destone28/DomotiQ/docs/it/07-riconoscimento-e-identita.md

# 7. Riconoscimento e identità

La casa riconosce persone, animali, l'auto e gli oggetti con la **visione artificiale classica**, senza addestrare un modello. Vista dal palo, la base di una statuina misura appena una dozzina di pixel alla risoluzione di analisi, il numero dei personaggi non ha limiti e chi usa la casa ne aggiunge di nuovi in ogni momento. Un rilevatore addestrato avrebbe bisogno di centinaia di immagini etichettate per ogni nuovo personaggio; il metodo classico registra un personaggio in pochi secondi e sta in un solo core della CPU della UNO Q.

Il **machine learning** si usa in due punti. Quando un personaggio viene registrato con una foto, un rilevatore di oggetti **YOLOX-Nano** addestrato sul dataset COCO guarda la foto e propone che tipo di cosa è. In più, se vuoi, puoi addestrare sul PC una piccola rete che conosce le tue statuine e dà alla casa un secondo parere (vedi [La rete che conosce le statuine](#la-rete-che-conosce-le-statuine)); senza, la casa funziona lo stesso.

## Come vede la casa

La visione gira in un processo separato, così un fotogramma lento o un problema della webcam non rallentano mai la webapp o la voce; se si ferma, riparte da sola.

1. **Acquisizione.** La Logitech C270 fornisce fotogrammi MJPEG; la casa li analizza a 640 × 480, da 7 a 10 al secondo sulla scheda. Esposizione, bilanciamento del bianco e guadagno sono bloccati, così i colori non si spostano quando statuine e luci colorate vanno e vengono. I valori si trovano misurando le immagini: la casa lascia regolare la webcam in automatico sulla casa vuota, misura luminosità e colori, poi cerca i valori manuali che danno la stessa immagine, un quarto più scura. Quello che la temperatura di colore della webcam non riesce a correggere (certe luci calde e verdastre) lo corregge un guadagno fisso su ogni canale. Finché la luce non è regolata la casa non riconosce niente, e lo dice in *Diagnostica*. Se poi la luce della sala cambia molto, la webcam si riregola da sola (vedi *La luce della sala*).
2. **La casa vuota.** Alla calibrazione la casa salva la mediana di 20 fotogrammi della casa vuota, arredi compresi. Tutto ciò che è diverso da questa immagine è una statuina, l'auto, un oggetto o una mano.
3. **Differenza nello spazio colore CIELAB, con correzione della luce stanza per stanza.** Le luci delle stanze della casa sono colorate, e la luce della sala cambia. Ogni pixel viene corretto con i guadagni della luce della sua stanza: un guadagno per canale di colore, stimato sul pavimento libero della stanza come il rapporto più frequente rispetto alla casa vuota (così una statuina o l'auto non lo falsano), e, quando sono possibili due valori, quello più vicino al fotogramma precedente. Attraverso una porta il guadagno passa gradualmente da una stanza all'altra. La casa avvisa la visione ogni volta che cambia una luce.
4. **Le ombre non contano.** Un'ombra è più scura ma mantiene il colore del pavimento.
   **Tolleranza per pixel.** Alcuni punti tremolano più di altri: i prati, i bordi dei mobili, gli angoli bui, tutta la casa se la sala è buia e la webcam alza il guadagno. Quando si salva la casa vuota la casa misura il tremolio di ogni pixel sui 20 fotogrammi e lo salva accanto all'immagine (`noise.npy`); senza quel file lo impara dalle prime immagini tranquille dopo l'avvio, poi lo aggiorna piano dove non ci sono presenze, e lo reimpara quando la webcam si riregola. Una macchia conta solo se da qualche parte supera di 5 volte il tremolio dei suoi pixel, e allora conta intera: una statuina su un prato che tremola resta com'è, una macchia fatta solo di tremolio sparisce. Con una buona luce il tremolio resta sotto le soglie fisse e non cambia niente; con un'immagine rumorosa (poca luce, guadagno alto) toglie gran parte delle macchie di tremolio, senza perdere statuine. Costa circa 2,5 ms per immagine.
5. **Maschere.** La visione guarda solo la base della casa: quello che c'è intorno (il tavolo, le mani prima che entrino, i telefoni) non conta. Dentro la base vengono ignorate le zone che non sono pavimento: le applique, la chioma dell'albero, il palo della webcam, la cima delle pareti, il totem del citofono e le schede sulle pareti del locale tecnico (la UNO Q, che sporge di un paio di centimetri dalla parete, e l'hub), i cui LED si accendono e spengono, ciascuna proiettata all'altezza a cui si trova davvero.
6. **Oggetti.** Dopo una pulizia morfologica, ogni macchia connessa diventa un oggetto con la sua area in mm², il suo colore mediano e un istogramma del suo colore, il suo allungamento, e i suoi punti più vicino e più lontano rispetto al punto sotto la webcam.
7. **Dove si trova (parallasse).** La webcam vede dall'alto una statuina in piedi, che quindi appare allungata in direzione opposta al punto sotto l'obiettivo: il suo punto più vicino è la punta dei piedi, quello più lontano la nuca. Abbassando la testa di tutta l'altezza della statuina si ottiene anche la posizione dei piedi, così una statuina viene piazzata correttamente anche quando i piedi sono nascosti dietro una parete. L'auto, che è una scatola più che una statuina, viene piazzata al centro di ciò che si vede. Su scene di prova sintetiche l'errore di posizione resta sotto i 12 mm. Una statuina sul letto, sul divano, su un tavolo o su una panca viene misurata dall'altezza di quel mobile: la casa capisce che ci sta sopra perché i suoi piedi, riportati a quell'altezza, cadono sul mobile. Sul tetto dell'auto invece no: una statuina posata sull'auto si confonde con l'auto. Su quale mobile sta un personaggio lo sa anche la casa, che lo dice (capitolo 8).
8. **Mani.** Una macchia grande almeno come un braccio (2500 mm² dentro la base) che entra dal bordo della base è una mano, tranne al portone del garage, da cui entra l'auto. Fa eccezione anche l'auto parcheggiata contro il muro di fondo del garage, con il tetto sopra il bordo: una "mano" quasi tutta nel garage la guarda la rete, e se vi riconosce l'auto con sicurezza non è una mano. Tutti i pezzi vicini alla mano ne fanno parte, qualunque sia la loro dimensione: il braccio tagliato dalla cima delle pareti e dalle applique, le dita, l'ombra. Una "mano" che resta perfettamente ferma per 8 secondi è invece un oggetto appoggiato sul bordo (un modulo, un cavo) ed entra a far parte della casa vuota. Le statuine che la "mano" copriva restano fuori dalla casa vuota: per esempio, il bagliore di una lampada a parete appena accesa dalla casa può diventare una grande "mano" ferma che contiene le statuine della stanza, e la casa le tiene dove le aveva viste l'ultima volta da sole. Una "mano" quasi tutta in stanze che la casa ha appena acceso, comparsa con la luce, è il bagliore di quella luce e non ferma la casa; le stanze accese restano anche fuori dalla misura con cui la webcam segue la luce della sala.
9. **Inseguimento.** Gli oggetti vengono abbinati alle tracce del fotogramma precedente con il metodo ungherese, su una distanza che combina posizione, colore e dimensione. **Niente si muove da solo, nemmeno sulla mappa:** senza una mano passata da poco una traccia non salta oltre 30 mm, per quanto tempo sia rimasta nascosta, e la posizione di un personaggio fermo non cambia (un'ombra o una luce sulla sua macchia non lo spostano); nei secondi dopo il passaggio di una mano la posizione si aggiorna una volta, dove la mano l'ha lasciato. Un personaggio seguito che per un momento non si vede (una luce, due statuine che si toccano) resta al suo posto fino a due minuti, un personaggio noto fino a un quarto d'ora. Una macchia sconosciuta proprio accanto a un personaggio, del suo colore, è un pezzo di lui (una statuina sdraiata sopra il tronco dell'albero si vede in due).
10. **Portato in mano.** Quando una statuina sparisce sotto una mano, la sua traccia diventa *portata* e mantiene la sua identità; quando la mano se ne va, la statuina che ricompare dove la mano ha lavorato è lo stesso personaggio. Se la mano ha lasciato una sola cosa nuova, quella è il personaggio che teneva, anche sdraiato o sul letto con colori un po' diversi. Se la mano le è solo passata sopra, la statuina ritrova la sua traccia dov'era. Se è stata posata contro un'altra statuina e le due si vedono come una sola macchia, resta nascosta dietro l'altra finché non si separano. Se la mano esce senza posarla, il personaggio lascia la casa 2,5 secondi dopo.
11. **Chi è.** Ogni identità registrata ha una **firma di colore**: un istogramma degli assi di colore a\* e b\* dello spazio CIELAB (dove la luminosità è tenuta a parte, così un'ombra o una luce più fioca cambiano poco) più il colore mediano. Per le statuine bianche, grigie e nere la luminosità pesa di più, perché è l'unica cosa che le distingue. Le identità sono uniche, quindi l'assegnazione delle identità alle tracce si risolve per tutte insieme; un'identità viene data dopo due fotogrammi concordi. Conta anche la dimensione: l'auto non viene mai presa per una statuina né una statuina per l'auto, e una taglia molto diversa da quella imparata conta come meno somigliante. Ogni personaggio impara sulla scheda le sue **pose** (fino a sei: sdraiato, sul letto, sotto un'altra luce), ciascuna con colori, dimensione e forma, e il confronto si fa con la più simile; una posa nuova si aggiunge quando la casa è sicura del personaggio, fermo e visto intero, e subito quando qualcuno dice chi è. Una posa però mostra la stessa statuina da un altro lato, non un altro colore: deve avere i colori del personaggio, più che di chiunque altro. Una posa imparata sulla macchia sbagliata (i LED di una scheda, un altro personaggio vicino) farebbe vedere quel personaggio ovunque: la casa non la impara, e quando carica i personaggi dimentica le pose che non passano questo controllo. Allo stesso modo i colori e la dimensione registrati imparano solo da una macchia che somiglia da vicino al personaggio. Il confronto di una macchia con tutte le pose di tutti i personaggi è un solo calcolo, fatto una volta per fotogramma. Un personaggio molto più simile a uno che a tutti gli altri viene riconosciuto anche con colori meno vicini, ma solo nei primi 10 secondi di una traccia nuova. **I nomi si muovono solo con le mani:** un nome non sta mai in due posti; senza una mano, chi lo tiene se lo tiene finché gli somiglia, e lo perde solo dopo otto fotogrammi in cui non gli somiglia più; e un nome non va mai a una macchia lontana dall'ultimo posto in cui quel personaggio è stato visto, a meno che una mano sia passata di lì o l'abbia preso. Un personaggio che non si vede più resta così dov'era, invece di comparire su qualche riflesso dall'altra parte della casa. **Storico:** la casa ricorda dove ogni personaggio è stato visto l'ultima volta e se una mano è passata di lì; prima di chiedere chi è una cosa nuova, se in quel punto stava un personaggio e nessuna mano lo ha toccato, è ancora lui e riprende il suo nome. Mentre una statuina è seguita con sicurezza, la sua firma si aggiorna lentamente con quello che vede la webcam.
12. **In quale stanza.** La stanza è quella sotto il punto in cui la statuina poggia, con 15 mm di tolleranza sulle porte, così una statuina su una soglia non salta avanti e indietro tra due stanze.

Il risultato è un elenco di tracce, ognuna con una posizione in millimetri, una stanza, un tipo e, quando è nota, un'identità. Il resto della casa (luci, regole, voce, webapp) lavora su questo elenco.

**A riposo.** Analizzare un fotogramma costa circa 180 ms sulla scheda. Quando la casa è ferma (nessuna mano da 25 secondi, nessuna luce della casa che cambia o è animata, niente in sospeso) la casa confronta prima ogni fotogramma, rimpicciolito a 80 × 60 e in grigi, con l'ultimo analizzato: se nessun punto è cambiato di più di 6 livelli di grigio, il fotogramma è uguale e non viene analizzato di nuovo. Il confronto costa una frazione di millisecondo, una mano lo cambia subito, e comunque almeno un fotogramma al secondo viene analizzato per intero. Così il processore resta libero per la voce. In **Diagnostica**, sulla riga della webcam, *a riposo 60% dei fotogrammi* dice quanti fotogrammi la casa ha lasciato stare (durante la festa compare *in pausa per la festa*).

**Priorità.** La visione è il lavoro continuo della scheda: quando il processore non basta per tutti, cede il passo alla voce, che gira nello stesso servizio (il suo processo ha priorità più bassa). Tra i servizi vengono prima la casa, poi la sintesi vocale, per ultimo il modello linguistico.

### Niente si muove da solo

In un plastico ogni cambiamento lo fa una mano: una statuina entra, esce o si sposta solo se qualcuno la prende. La casa usa questa regola per non vedere presenze che non ci sono.

- **Mentre una mano è sopra la casa**, e per 0,6 secondi dopo che è uscita (la sua ombra, la statuina che oscilla), la casa non conta niente di nuovo e non fa sparire nessuno. Una statuina che la mano non tiene resta dov'è: la sua traccia non salta su un'altra macchia.
- **Sulla piantina una statuina si sposta solo se una mano le arriva vicino** (entro 5 cm), anche di pochi millimetri. Senza una mano vicina restano ferme la posizione e il mobile su cui sta: un'ombra, la luce della sala, la sua macchia che a tratti si unisce a qualcosa accanto o salta avanti e indietro di qualche millimetro non la muovono. Mentre la mano lavora, la statuina segue quello che si vede. Quando la mano se ne va (dopo 0,6 secondi), il suo posto diventa la mediana delle prime 10 immagini, circa un secondo: la mediana ignora le immagini storte con l'ombra del braccio. Lo stesso vale per una statuina appena comparsa.
- **Dopo, le cose nuove si cercano solo dove la mano ha lavorato**, per 3 secondi, e nasce solo ciò che la mano ha portato: una cosa che era già diversa dalla casa vuota prima che la mano arrivasse non è nuova. Deve anche essere compatta (al massimo 3,5 volte più lunga che larga) e staccarsi bene dal pavimento, per colore o perché molto più scura o più chiara: le strisce che la luce disegna ai piedi delle pareti o sul bordo del divano, e le chiazze tenui, non sono presenze. Non nasce niente che stia tutto su una parete, né una cosa piccola proprio sul bordo della base.
- **Doppio controllo.** Prima di mostrare una cosa nuova sulla piantina e di chiederne il nome, la casa controlla due volte di esserne sicura. La sicurezza va da 0 a 100% e mette insieme quattro misure: quanto spesso la vede, quanto sta ferma, quanto si stacca dal pavimento, quanto è compatta. Deve superare l'80%, e di nuovo un secondo dopo, senza essere scesa sotto nel frattempo. Per due minuti, nella stanza dove qualcuno ha appena detto che non c'era nessuno (a voce, con **Non c'è niente** o con **Non c'è davvero: togli**) o dove la casa ha appena scartato un riflesso, serve il 92%, controllato a 2,5 secondi di distanza.
- **Una cosa sconosciuta che salta**, anche di pochi millimetri, o che sparisce e ricompare più volte al secondo senza una mano intorno, non è una statuina: è un riflesso o un LED. Esce dalla piantina, lì per 30 secondi non nasce niente e per due minuti in quella stanza vale il doppio controllo più severo. Non vale nelle stanze con le luci animate (la festa).
- **Una differenza senza mano intorno** (un riflesso, la luce della sala, una lampada laterale) non diventa mai una presenza. Le differenze tenui entrano a far parte della casa vuota dopo circa 3 secondi. Ciò che sembra una statuina invece non ci entra mai, così toglierla non lascia un fantasma. Fa eccezione una cosa che spicca chiaramente, compare con una mano intorno e resta per 2 secondi: è una statuina posata mentre la casa aspettava.
- **Il posto lasciato** da una statuina entrata nella casa vuota (per esempio dopo che la casa ha reimparato la casa vuota), quando torna uguale alla casa vuota salvata, non è una presenza: la casa vuota se lo riprende.
- **Quando la casa cambia la luce di una stanza**, per 2,5 secondi il suo riflesso su pareti e pavimento non viene preso per una presenza.
- **Quando cambia la luce della sala** i personaggi restano com'erano un attimo prima, e la casa reimpara la casa vuota con la luce nuova: vedi *La luce della sala*.
- **All'accensione** la casa aspetta che le luci stiano ferme (il microcontrollore le rimanda), poi riconosce i personaggi registrati che sono in casa e l'auto: solo quelli che somigliano da vicino a un personaggio e hanno la forma di una statuina, così l'alone di una lampada o i LED di un modulo non diventano qualcuno. Un personaggio nuovo che era già in casa, o uno sdraiato che somiglia meno, compare appena qualcuno lo sposta.
- **Una presenza seguita meno di 2,5 secondi** è rumore, anche se ha preso un nome: non resta sulla piantina come nascosta.
- **Allarmi solo su presenze certe.** Le regole d'allarme (capitolo 9) contano un personaggio che la casa conosce, o una cosa sconosciuta che sta lì, ferma e ben visibile, da almeno 6 secondi. Una macchia appena nata non fa suonare niente.
- **Il citofono** è escluso dall'analisi, ma il suo contorno conta come bordo della base: un braccio che si allunga verso il soggiorno passando sopra il totem resta una mano.

## Tipi di cose

Ogni identità ha un tipo: **persona**, **cane**, **gatto**, **animale** (qualsiasi altro animale domestico), **auto** o **oggetto**. Le regole possono filtrare per tipo; in una regola *animale* comprende anche cani e gatti. Gli arredi della casa sono fissi e fanno parte della casa vuota; un oggetto nuovo messo nella casa (una sedia, un pallone, una valigia) è un'identità di tipo *oggetto*.

Quando parte una registrazione, la casa propone un tipo:

- **Dalla foto**, se ne è stata scattata una: YOLOX-Nano gira sulla scheda con ONNX Runtime e cerca le 80 classi di COCO; decide il rilevamento sicuro più grande. *person* dà una persona, *dog* un cane, *cat* un gatto; *car*, *truck* e *bus* danno un'auto; *bird*, *horse*, *sheep*, *cow*, *elephant*, *bear*, *zebra*, *giraffe* e *teddy bear* danno un animale; ogni altra classe dà un oggetto, con un nome proposto (per esempio *sedia*, *pallone*, *valigia*).
- **Senza foto**, da dimensione e forma viste dall'alto: una macchia grande è un'auto, una alta e stretta una persona, una piccola, allungata e bassa un animale, tutto il resto un oggetto.

La proposta va sempre confermata da chi registra.

## Registrare un personaggio

Chiunque può registrare personaggi, animali, auto e oggetti, in tre modi.

### Dalla webapp

1. **Personaggi → + Aggiungi**, oppure tocca una statuina sconosciuta nella schermata **Casa** e poi **Registra**.
2. Scrivi il **Nome**. Se vuoi tocca **Scatta o scegli una foto**: basta una foto di fronte; compare nell'elenco e serve a indovinare il tipo. Il telefono la riduce a 1024 pixel prima di inviarla. Tocca **Avanti**.
3. *Appoggialo in un punto libero della casa: lo sto cercando…* La casa cerca qualcosa che vede ma non conosce. Se c'è esattamente un candidato lo prende; se ce n'è più di uno dice *Vedo più cose nuove: tocca quella giusta sulla piantina.*; se non ce n'è nessuno aspetta. Dopo due minuti e mezzo senza risultato ci rinuncia: *Non ho trovato niente di nuovo. Riprova.*
4. *Trovato! Che cos'è?* La casa mostra la sua ipotesi (*Mi sembra: cane*, con un nome proposto per gli oggetti), gli eventuali [avvisi](#avvisi) e i sei tipi. Scegli e tocca **Salva**.
5. *Marco è registrato. D'ora in poi lo riconosco.*

### Con il citofono

1. Premi **Citofono** sul totem. Suona un campanello e la casa chiede "Chi è?" / "Who is it?".
2. **Un nome registrato**: "Ciao Marco, entra pure!". La prima statuina che compare dopo il campanello, nei 3 minuti successivi, sul vialetto o in una stanza della casa (non in garage), riceve quel nome, qualunque cosa la webcam l'abbia presa (una statuina sembra spesso un oggetto o un animale) e senza che la casa chieda chi è. Se il nome appartiene a qualcuno che è già dentro, la casa lo dice ("Ma Marco è già in cucina!"). Se la webcam riconosce chiaramente nella statuina che entra qualcun altro, la casa lo dice ("Ma a me sembri Sofia, non Marco!") e mantiene l'identità che vede.
3. **Un nome nuovo**: "Ho capito Marco, giusto?" Dopo un *sì*: "Piacere, Marco! Entra dalla porta." La prima statuina che compare dopo il campanello, nei 3 minuti successivi, sul vialetto o in una stanza della casa, diventa Marco, una persona, con i colori che la casa vede, senza altri passaggi e senza domande; anche se la casa le aveva dato un nome di cui non era sicura. Una statuina che la casa riconosce con certezza come qualcun altro non conta, e nemmeno una che era già in casa prima del campanello.
4. **Un nome non capito**: un secondo tentativo ("Scusa, non ho capito. Chi sei?"), poi "Non ti conosco, ma entra pure: sei un ospite."

Quando una registrazione avviata a voce è completa, la casa dice "Benvenuto, Marco! Ora ti riconosco."

### Con il tasto Parla

Tieni premuto **Parla** e di' "Aggiungi un personaggio" / "Add a character". La casa chiede "Come si chiama?", poi "In che stanza l'hai messo?", e cerca in quella stanza la statuina che non conosce:

- esattamente una: diventa subito Marco;
- ancora nessuna: "Va bene: mettilo in cucina, lo aspetto." La prima statuina sconosciuta messa in quella stanza entro due minuti e mezzo diventa Marco;
- più di una: "Vedo più di un personaggio nuovo in cucina: scegli Marco dalla webapp." Su tutti i telefoni compare una fascia *Registrazione a voce da completare*; **Scegli** apre la piantina per toccare la statuina giusta.

## Nomi

- **I nomi sono unici** in tutta la casa, senza distinzione tra maiuscole e minuscole, e vengono confrontati anche con le pronunce inglesi. Un nome già in uso viene rifiutato: *Il nome Marco è già usato: aggiungi un cognome o un soprannome.* Se le si chiede a voce di aggiungere un nome che ha già, la casa risponde "Conosco già Marco."
- **Non c'è limite** al numero di personaggi o di oggetti.
- **Dire i nomi a voce.** Per riconoscere un nome a voce, la casa ascolta solo i nomi registrati, con il vocabolario del suo modello di riconoscimento vocale. Un nome fatto di parole che il modello non conosce non si può riconoscere a voce: alla registrazione la casa lo controlla e lo segnala al passo di conferma (*Il riconoscimento vocale italiano non conosce «Zorbax»: a voce potrei non capirlo.*). Il riconoscimento inglese potrebbe non capire un nome italiano: nella scheda del personaggio compila **Pronuncia inglese (facoltativa)** con una grafia che riesca a riconoscere; la casa accetta entrambe le forme.
- Chiunque può rinominare o eliminare un personaggio dalla sua scheda. Un personaggio eliminato lascia subito la presenza che lo portava, le domande aperte che lo proponevano e le etichette di **Addestramento immagini** (non insegna più alla rete un personaggio che non c'è). Resta nel cestino per 24 ore e si può ripristinare da **Altro → Impostazioni → Cestino**; se nel frattempo il suo nome è stato preso, torna con " 2" dopo il nome.

## Avvisi

Alla registrazione la casa controlla cosa potrebbe rendere difficile riconoscere la nuova statuina, e lo dice al passo di conferma:

- *Il colore è molto simile al pavimento / ai prati / alle pareti: potrei non vederlo bene.* La differenza rispetto alla casa vuota è piccola, quindi alcune parti della statuina potrebbero andare perse.
- *Compare e scompare: prova a spostarlo in un punto più libero.* La statuina è stata rilevata in meno della metà dei fotogrammi da quando è comparsa.
- *Sembra uguale a Marco: li distinguerò solo seguendoli.* La sua firma di colore è quasi uguale a quella di un personaggio già registrato.

Nessuno di questi avvisi impedisce la registrazione.

## Personaggi dello stesso colore e dubbi

Due statuine dello stesso colore si distinguono solo seguendole. La continuità del movimento le tiene separate: se solo una delle due viene presa e appoggiata altrove, dev'essere per forza quella, visto che l'altra è rimasta in vista.

Quando il filo si perde (prese tutte e due insieme, le due si toccano, una ricompare lontano, oppure la casa è appena partita) la traccia diventa **incerta**. La casa allora:

- chiede su tutti i telefoni, con una domanda come "In cucina c'è Marco o Leo?", un pulsante per ogni nome e **Tutti e due**, se le statuine si toccano;
- chiede anche ad alta voce, se la sua loquacità lo permette, e subito dopo ascolta la risposta da sola, senza il tasto **Parla**: basta dire il nome, oppure "tutti e due". Vale la prima risposta, a voce o da un telefono;
- se non arriva una risposta entro 60 secondi, tiene la sua ipotesi migliore, segnata come incerta: un **?** sulla piantina, e "Marco è in cucina. Almeno credo." nelle risposte a voce.

**Un nome non sta mai in due posti.** Prima di chiedere, la casa toglie dai candidati chi è già riconosciuto da un'altra parte della casa (tranne se una mano è passata dov'era), chi è stato visto per l'ultima volta lontano da lì senza che una mano ci sia passata, chi ha una taglia troppo diversa da quella che vede (più di quattro volte più grande o più piccola di tutte le sue pose; una statuina non è mai l'auto, l'auto non è mai una statuina) e l'auto fuori dal garage se non ne è certa. Se ne resta uno solo, la casa decide da sola senza chiedere: se Sofia è in cucina, la statuina nuova in soggiorno che somiglia a Sofia e a Leo è Leo. Se non ne resta nessuno (Sofia è in cucina e Leo in camera), quella statuina non è nessuno dei due: la casa la tratta come un nuovo arrivato e chiede chi è. Se il dubbio si scioglie mentre la domanda è aperta (Sofia ricompare in cucina), la domanda viene ritirata dai telefoni e la casa smette di ascoltare.

La stessa regola vale per quello che la casa mostra e dice. Se due presenze arrivano con lo stesso nome (per esempio una ancora in mano e una appena posata), il nome resta a quella in vista. Un nome dato dalla webapp, a voce o dal citofono resta dove è stato dato e sparisce da dove era subito, anche nel mezzo secondo in cui la visione, che gira in un processo separato, non lo sa ancora; poi i nomi tornano a essere quelli della visione, che non li rimette più su una presenza a cui li ha tolti.

**L'auto sta in garage.** L'auto non viene mai proposta per una statuina, né per qualcosa fuori dal garage, a meno che la casa non ne sia certa: grande come un'auto, ferma e ben visibile da 10 secondi.

Sulla stessa statuina richiede al massimo ogni 30 secondi. Una risposta, una registrazione o un ingresso dal citofono **confermano** un'identità: una statuina confermata la mantiene finché la casa riesce a seguirla.

## Un nuovo arrivato

Quando è sicura che c'è qualcosa che non riconosce, la casa lo chiede subito, a voce e su tutti i telefoni insieme. Dice anche che cosa le sembra, così lo si può correggere: "In soggiorno vedo una persona nuova, giusto? Come si chiama?". A una persona chiede il nome, senza proporre quelle registrate. Per un animale, un'auto o un oggetto propone i registrati dello stesso tipo che non sono già in casa ("In giardino vedo un cane nuovo, giusto? È Fido o Birba, o come si chiama?"); per un animale non propone mai una persona. **L'auto sta in garage**: dentro una stanza della casa non chiede mai di un'auto nuova (la chiama "un oggetto"); per qualcosa grande come un'auto fuori dal garage (più spesso una luce, un'ombra o statuine ammucchiate) la casa non chiede niente, a meno di esserne certa: vista ferma e ben visibile per almeno 10 secondi.

**A voce**, senza il tasto Parla, si può rispondere con qualsiasi frase. La casa la capisce e risponde di conseguenza:

| Risposta | La casa |
|---|---|
| un nome nuovo ("Marco", "si chiama Marco", "è mio fratello Andrea") | chiede conferma del nome insieme al tipo ("Una persona di nome Marco, giusto?"), poi "Piacere, Marco!" |
| un nome già registrato ("è Sofia"), anche sentito con una lettera sbagliata ("sera" per Sara) | lo assegna e ne impara i colori, se gli somigliano. Se quel personaggio è in vista in un altro punto della casa, il nuovo arrivato non c'era: "Sofia è già in soggiorno: allora qui ho visto male" |
| "tutti e due", "entrambi", "sia Sofia che Leo", "Sofia e Leo" | due statuine a contatto sono una sola macchia: le segna presenti tutte e due, una nascosta dietro l'altra finché una mano non le separa ("Ah, sono in due: Sofia e Leo!"). Se uno dei due è in vista altrove, qui c'è solo l'altro; se i nomi non sono stati detti e la domanda non ne proponeva, chiede quali sono |
| il tipo giusto ("no, è un cane", "è un gatto e si chiama Micia") | corregge il tipo e chiede il nome, se manca |
| sì o no | dopo un sì chiede il nome, dopo un no chiede che cos'è |
| "non c'è nessuno", "è la mia mano", "è un'ombra" | dimentica quello che aveva visto: la macchia entra nella casa vuota e lì per 30 secondi non nasce niente. Per due minuti in quella stanza vale il doppio controllo più severo |
| "non lo so", "lascia perdere" | lascia la domanda ai telefoni |
| "aspetta" | aspetta e ascolta di nuovo |
| un comando o una domanda ("che ore sono?", "accendi la luce in cucina") | risponde, poi chiede di nuovo il nome |
| una battuta o altro | chiede di nuovo il nome; la seconda volta lascia stare |
| un discorso che non parla del nuovo arrivato ("...e domani andiamo al mare") | come una battuta: il tipo che dice il modello linguistico conta solo se la frase lo nomina |
| silenzio | chiede ancora una volta, poi lascia la domanda ai telefoni. Se due nuovi arrivati di fila non ricevono nessuna risposta, per tre minuti la casa li chiede solo sui telefoni |

Le risposte brevi e comuni le capiscono delle regole, all'istante. Le altre frasi le classifica il modello linguistico locale (capitolo 8). Sulla scheda servono da 3 a 6 secondi, e intanto la casa dice "Fammi pensare..." e i tasti respirano.

- **Dal telefono** si tocca un nome sulla domanda, **Tutti e due** quando i nomi proposti sono più di uno, oppure si sceglie **Uno già noto…** fra tutti i personaggi e gli oggetti che la casa conosce e si tocca **Questo** (il nome si sposta lì da dov'era), oppure si scrive un nome nuovo, si sceglie il tipo e si tocca **Aggiungi**. **Non c'è niente** fa dimenticare alla casa quello che aveva visto.
- Vale la prima risposta, da uno dei due canali; quando arriva, la casa smette di ascoltare.
- Se quello di cui chiede sparisce prima della risposta, la domanda viene ritirata dai telefoni e la casa smette di ascoltare.

Con un nome nuovo la casa crea il personaggio, con il tipo detto (o intuito) e i colori che vede. Con un nome già registrato aggiorna subito i colori di quel personaggio con quelli che vede in quel momento, se gli somigliano, così la volta dopo lo riconosce da sola; una risposta data sulla macchia sbagliata dà il nome ma non cambia l'aspetto del personaggio. Una registrazione in corso dalla webapp ha la precedenza: mentre aspetta il suo personaggio, la casa non fa questa domanda.

## Durante la festa

Mentre la casa fa festa le luci colorate cambiano a ogni battuta, e la webcam vede colori che non sono quelli dei personaggi. Per questo la casa **sospende il riconoscimento** dall'inizio della festa alla fine dello spettacolo di luci: le presenze restano dove erano e con il loro nome, non nasce niente di nuovo, non sparisce niente, la casa non fa domande e non annuncia spostamenti. L'immagine in **Diretta** continua ad aggiornarsi.

A festa finita la casa misura di nuovo la luce di ogni stanza, aspetta che le luci si fermino e riprende quello che vede, come all'avvio. Durante la festa qualcuno potrebbe aver spostato un personaggio, quindi per ognuno vale come se una mano fosse passata dov'era: un personaggio spostato viene ritrovato e il suo nome lo segue anche lontano da dov'era; se la casa non lo riconosce, chiede chi è.

## Correggere la casa dalla webapp

- **Chi è.** Sulla scheda di una presenza (pagina **Casa**), **Chi è?** o **È un altro: cambia** apre l'elenco di tutti i personaggi e gli oggetti che la casa conosce, con un nome nuovo in fondo. Scegliendo un personaggio già noto, il nome passa a quella presenza e lascia quella che lo aveva per errore; la casa impara quell'aspetto come una delle sue pose anche se è diverso dal solito (una luce diversa, un personaggio sdraiato), fino a una distanza di colore di 0,6 invece di 0,45, e lo ricorda dopo un riavvio. Una risposta a voce, che potrebbe riguardare la macchia sbagliata, resta più prudente.
- **Elemento non riconosciuto.** Una statuina che la casa non ha visto posare, o che ha preso per la casa vuota, non viene seguita. **Elemento non riconosciuto**, sulla pagina **Casa** (toccando il punto sulla piantina) o in **Diretta** (toccandolo nell'immagine), dice alla casa dov'è: intorno a quel punto, per circa 3 cm, la casa riprende la casa vuota com'era stata salvata, così quello che c'è torna diverso da lei, ne fa una presenza seguita da subito e chiede chi è. Lì si annullano anche i "non c'è niente" detti poco prima. Se lì non vede niente di diverso dalla casa vuota (l'elemento c'era già quando è stata salvata), basta spostarlo un poco e riprovare.

- **Impara di nuovo l'aspetto.** Nella scheda di un personaggio (**Personaggi**) fa dimenticare alla casa i suoi colori, le pose e la misura. Il nome, le cose da sapere e le regole restano. La prima volta che qualcuno dice chi è (toccando la statuina sulla piantina, rispondendo a una domanda della casa o a voce) la casa impara l'aspetto che vede in quel momento. Serve quando la statuina è un'altra: un personaggio ridipinto o sostituito da un'altra statuina, oppure dopo aver ripristinato un backup fatto con statuine diverse dalle tue. La casa cercherebbe i colori vecchi e non riconoscerebbe la statuina nuova, o la scambierebbe con un altro personaggio.

## La luce della sala

La webcam ha esposizione e colori bloccati sulla luce in cui è stata salvata la casa vuota.

**Il guadagno segue la luce.** Mentre la casa guarda, ogni mezzo secondo confronta la luce delle stanze con la casa vuota in uso, così come è stata fotografata: in ogni stanza conta il pavimento libero, lontano dai personaggi e dalle mani, e fra le stanze conta quella di mezzo, così una stanza con la luce appena accesa non sposta niente. Se la differenza supera il 5%, ritocca il guadagno della webcam di un passo, al massimo l'8% di luce alla volta. Quando la luce della sala cambia di colpo, la casa tiene fermi i personaggi, il guadagno fa passi più lunghi (fino al 25%) e solo dopo la casa impara di nuovo la casa vuota. Così la sera che cala o una lampada accesa si seguono senza buchi di immagini: la regolazione completa della webcam, circa 10 secondi senza immagini, parte da sola solo quando il guadagno è già al limite, e mai al buio se è già stata fatta al buio. *Diagnostica → Luce della webcam* mostra guadagno, ritocchi dell'ultima ora ed eventuale pausa (mani sulla casa, avvio, buio, festa, stanze coperte, luci della casa che cambiano). La webapp non ha un interruttore: si spegne mettendo `"follow_light": false` nella sezione `"camera"` di `var/config/settings.json` e riavviando `domotiq`.

**Come se ne accorge.** La casa si accorge da sola quando cambia la luce della sala:
- la luminosità dell'immagine cambia di oltre il 12% in 2 secondi (una luce accesa o spenta);
- la luminosità resta per 3 secondi oltre il 15% lontana da quella in cui ha imparato la casa vuota l'ultima volta (la sera che arriva piano);
- gran parte della casa cambia senza mani;
- le "mani" coprono quasi metà della casa e insieme la luminosità è cambiata (due braccia vere coprono al massimo un quarto della casa e la luminosità la cambiano appena: sono le pareti illuminate in un altro modo);
- la luce va oltre quello che la correzione delle stanze riesce a seguire;
- la webcam viene regolata di nuovo.

Non conta mentre una luce della casa è appena cambiata (il suo riflesso si misura stanza per stanza), né durante la ricerca dei personaggi all'avvio.

**Cosa fa.**
- **I personaggi restano.** Da quel momento i personaggi restano esattamente com'erano un attimo prima: stessi nomi, stessi posti, niente nasce, niente sparisce e la casa non guarda. Quello che negli ultimi secondi sembrava "preso in mano" resta dov'era: quelle mani erano la luce.
- **La luminosità.** Se l'immagine è sotto il 70% o sopra il 143% della casa vuota, la webcam si regola di nuovo subito.
- **La mappa.** Quando la luminosità sta ferma (entro il 2% per un secondo), la casa reimpara la casa vuota dalla mediana degli ultimi 5 fotogrammi, tranne intorno ai personaggi.
- **Si riparte.** Un secondo dopo ritrova i personaggi al loro posto e ricomincia a guardare: in tutto, pochi secondi.

Spegnere la luce della sala porta l'immagine a circa metà della luminosità, mentre gli scenari della casa (cinema, notte) la abbassano appena: la soglia del 70% distingue bene i due casi.

Una webcam coperta o abbagliata non viene mai imparata come casa vuota, e lo stesso vale per una sala troppo buia (grigio medio dell'immagine sotto 25 su 255). La casa vuota non si può nemmeno salvare al buio: la webapp chiede di accendere la luce. I personaggi restano e la webapp avvisa *La webcam vede quasi buio* (vedi il capitolo 11). Quando la luce torna, la casa riguarda cosa c'è, come dopo una festa: al buio qualcuno può aver spostato una statuina, e la casa la ritrova al suo nuovo posto, con il suo nome. Neanche una webcam urtata: prima di imparare, la casa controlla che pareti e mobili siano al loro posto. Se non ci sono, non impara niente e chiede subito una nuova calibrazione. *Diagnostica* mostra quando la luce sta cambiando e quante volte la casa si è adattata.

**Una sala molto buia.** Anche quando l'immagine è troppo buia per essere imparata, la webcam continua ad alzare il guadagno, e solo verso la luce, finché può, così la casa non resta cieca ad aspettare che la luce torni. Arrivata al guadagno massimo, la webcam usa anche le esposizioni oltre 625, dove moltiplica l'immagine (circa 1,7, 2,3 e 2,9 volte, sempre a 15 fotogrammi al secondo); quando la luce torna le lascia per prime. A quel punto il rumore della webcam è alto, e la casa lo impara di nuovo anche se vede "mani": a quel guadagno quasi sempre sono il rumore stesso. In una sala così buia le statuine scure sul pavimento scuro (una statuina nera, una rossa nell'ombra) possono non distinguersi più: la casa non vede cose che non ci sono, ma può non vedere tutte quelle che ci sono. Con una luce normale tutto torna come prima.

**La casa vuota con più luci.** In **Calibrazione**, con la casa vuota:
1. **Fotografa con tutte le luci della casa.** La casa mostra le sue luci una dopo l'altra (tutte spente, tutte accese, una stanza alla volta, gli scenari) e in ognuna salva una foto della casa vuota, in circa un minuto.
2. **Aggiungi la luce di adesso.** Accendi una alla volta le luci della sala che la casa non comanda (lampade, LED, la luce della finestra) e per ognuna premi il pulsante.

Quando la luce cambia, e a ogni avvio, la casa confronta con la foto più simile, dopo aver misurato la luce di ogni stanza, e non impara niente da quello che vede: una statuina che non sta seguendo non può finire nella casa vuota. Se nessuna foto è abbastanza simile, la reimpara come al solito. Le foto si cancellano quando si rifanno gli angoli. Dopo aver spostato un arredo, premi *Cancella* e rifalle.

**Un avvio con un'altra luce.** Se la casa si accende, o riparte, con una luce diversa da quella in cui è stata salvata la casa vuota, i colori delle statuine non sono quelli registrati. All'avvio la casa prende anche quello che la rete riconosce come un personaggio, e se reimpara la casa vuota senza conoscere ancora nessuna presenza, quello che spicca non entra nella casa vuota e la casa riguarda cosa c'è. Altrimenti le statuine diventerebbero parte della casa vuota: non si vedrebbero più e, spostate, lascerebbero presenze fantasma dove erano state. Resta buona regola salvare di nuovo la casa vuota quando la luce della sala cambia per sempre. Se mentre cerca la casa cambia una luce (per esempio una regola che accende una stanza, o le luci che seguono le persone, se le hai accese), da quel momento prende solo quello che la rete riconosce con sicurezza: il bagliore di una lampada sui muri ha i colori dei personaggi.

Mentre la webcam si regola (circa 10 secondi, senza immagini) le presenze restano dove sono sulla piantina, anche nell'istante tra la fine della regolazione e il primo fotogramma: la casa non saluta e non riaccoglie nessuno. Se una regolazione non riporta l'immagine vicina alla casa vuota (una sala più buia di quanto la webcam riesca a seguire), la successiva aspetta il doppio, fino a un quarto d'ora, così la webcam non si regola di continuo sempre con gli stessi valori.

Con una luce molto diversa le pareti e i bordi dei mobili cambiano aspetto e possono sembrare grandi macchie che entrano dai bordi, cioè mani, che "prenderebbero" e sposterebbero i personaggi e lascerebbero nascere presenze false dove erano stati. Per questo la casa riconosce prima il cambio di luce, e la casa vuota imparata di nuovo non ha più quelle "mani". Valgono anche le regole delle mani: "mani" ferme senza interruzione per 30 secondi non sono mani, e se la luce è vicina a quella della casa vuota entrano nella casa vuota (tranne dove c'è un personaggio).

## La rete che conosce le statuine

Oltre alla differenza dalla casa vuota e alla firma di colore, la casa può avere un secondo parere: una piccola rete neurale che addestri tu sulle tue statuine, viste dalla webcam della casa con luci e ombre diverse (vedi *Addestrarla* più sotto). Guarda il ritaglio di una macchia e dice quale personaggio è, oppure "niente" (il riflesso di una luce su una parete, un'ombra, un modulo). Sulla scheda ogni ritaglio costa circa 10 ms, quindi la casa la usa solo quando serve:
- **Una macchia nuova** che la rete vede come "niente", abbastanza sicura, non diventa una presenza. Non vale mentre si registra un personaggio nuovo: la rete non lo conosce ancora.
  - **"Niente" per prima risposta.** Anche quando la rete non è sicura, una presenza nuova viene annunciata solo quando la sua risposta più recente non è "niente": la presenza aspetta, e la rete la riguarda ogni mezzo secondo. Le statuine vere non hanno quasi mai "niente" come prima risposta, mentre molte presenze false (mobili, griglie e prati sotto un'altra luce) sì. Un personaggio registrato dopo l'addestramento della rete non viene giudicato da lei.
  - **Il tipo.** Una presenza senza nome prende il tipo del personaggio che la rete vede, se ne è sicura almeno all'80%: così una statuina piccola e tonda, che dalla forma sembrerebbe un animale, non viene chiesta come "un animale nuovo".
  - **La soglia.** Ogni rete è sicura a modo suo, quindi la soglia si misura quando la si addestra: sta appena sopra la statuina vera più "niente" dei blocchi lasciati fuori, e arriva nel file `figures.json` della rete. Senza, è il 90%.
- **Un personaggio che non somiglia più ai suoi colori** (un'altra luce) tiene il nome finché la rete, almeno all'80%, lo vede ancora.
- **Un nome sbagliato dei colori.** La rete riguarda ogni 2 secondi anche le presenze che hanno un nome. Se è sicura al 95% due volte di fila che una presenza è un altro personaggio, il nome passa a lei, anche da un'altra presenza che lo teneva, tranne quando quel nome l'ha dato qualcuno o la rete vede quel personaggio anche nell'altra presenza. Un personaggio non impara un aspetto nuovo quando la rete, almeno all'80%, ci vede un altro personaggio.
- **Un nuovo arrivato** prende il nome di un personaggio che nessun altro ha, invece di sentirsi chiedere "chi è?", quando la rete ne è sicura al 95% due volte di fila.
- **Il nome che può avere uno solo.** Una presenza senza nome prende il nome del personaggio che la rete vede almeno al 75%, tre volte di fila, se nessun altro può esserlo: quel personaggio non è altrove in casa, la rete non lo confonde con un altro che manca, e non vede lui in nessun'altra presenza senza nome. Serve dove la rete è meno sicura perché ha visto poco quel posto (per esempio il bagno, che di serie è sfocato anche nelle immagini per la rete).
- **L'auto con l'alone.** In una luce diversa da quella della casa vuota l'auto ha intorno un alone di pavimento e pareti, e la rete ne è meno sicura nella macchia intera che nel suo centro. Per una macchia grande come l'auto la rete guarda anche il centro, all'avvio e nei controlli di ogni presenza. L'auto riconosciuta così non è una mano, nemmeno accanto a una "mano" (un bagliore lì vicino).
- **I doppioni.** Una presenza senza nome che la casa non vede più, o crede in una mano, a meno di 4 cm da un personaggio visto adesso, è lui ritrovato: sparisce subito, senza essere contata né chiesta.
- **Il nome che la rete vede resta.** Quando la rete vede in una presenza il personaggio di cui porta il nome, almeno all'80%, i colori non glielo tolgono per 10 secondi dall'ultima volta che la rete l'ha guardata (una presenza con un nome la guarda ogni qualche secondo). Così un personaggio di cui la casa non conosce ancora bene i colori non torna a prendere il nome di un altro personaggio dai colori simili.
- **Un nome conteso.** Se la rete vede in una presenza un altro personaggio almeno al 90%, due volte di fila, e quel personaggio non è in nessun'altra presenza, oppure la presenza che ne porta il nome è in vista e la rete lì non lo vede, il nome passa a lei. Due personaggi scambiati dai colori si rimettono a posto da soli; la presenza che resta senza nome viene riconosciuta o chiesta.
- **Due risposte di fila** della rete contano se arrivano a meno di 10 secondi l'una dall'altra: a casa ferma la webcam guarda un'immagine al secondo, poche presenze per volta, quindi la rete riguarda una presenza con un nome solo ogni qualche secondo.
- **Con le luci della casa che si muovono** (un allarme, l'onda del climatizzatore, uno scenario) la visione non cambia idea: nessun nome passa da una presenza a un'altra, la rete non viene interrogata (il bagliore ne cambia i colori), i personaggi restano dove erano anche se il bagliore li nasconde, e il bagliore nelle stanze accese non è una mano. Nasce solo quello che una mano ha posato, e prende il nome quando le luci si fermano. Nemmeno la luce della sala si adatta: il lampeggio rosso dell'allarme sembrerebbe una luce nuova della sala, e la casa vuota verrebbe imparata di nuovo con dentro l'allarme.
- **Due personaggi dei colori simili** (due statuine rosse, per esempio) li distingue la rete, quando è sicura al 95% due volte di fila, invece dei colori. Prima di chiedere "chi è?" per un dubbio tra due personaggi uguali, la casa aspetta 2 secondi il parere della rete.

La rete guarda anche le statuine prese "in ritardo" (posate mentre la casa aspettava). È sempre accesa, senza interruttori nelle impostazioni; *Diagnostica* mostra quante volte è servita. Senza il file della rete (`models/vision/figures.onnx` e `figures.json`) la casa funziona senza questo secondo parere.

**Il consenso della rete**, sempre richiesto quando la rete c'è: una presenza nuova viene annunciata solo quando la rete ha visto una statuina, due volte di fila. È il modo per non avere falsi positivi. Il prezzo è che una statuina che la rete non conosce viene annunciata solo mentre la si registra (**Personaggi → + Aggiungi**), e che con poca luce una statuina può tardare un po'.

Una presenza nuova viene annunciata solo dopo che la rete l'ha guardata (al più un fotogramma dopo), e il nome di un personaggio appena preso in mano non va a una macchia che la rete ha appena visto come "niente".

**La raccolta continua** (Impostazioni → Raccolta continua di immagini per la rete, spenta di serie) tiene quello che vede la webcam, con l'esterno sfocato, in `var/collect`: cartelle di 10 minuti nel formato delle registrazioni, un'immagine ogni 5 secondi e due al secondo quando succede qualcosa. Oltre lo spazio scelto (500 MB di serie) si cancellano le cartelle più vecchie. Sono i dati per addestrare di nuovo la rete con le luci e le posizioni vere del posto dove sta la casa; ogni cartella tiene anche la casa vuota di quel momento (`reference.jpg`), utile per controllare che la casa non abbia imparato una statuina come parte della casa vuota.

**Addestramento immagini** (Altro → Addestramento immagini) serve ad addestrare la rete neurale a riconoscere meglio presenze e assenze nella casa: tiene ogni presenza nuova, ogni nome dato e ogni macchia scartata dalla rete, con l'immagine. Dire per ognuna se era giusto, o cosa era davvero, dà esempi verificati da una persona per l'addestramento successivo (`build_crops.py ... --journal <copia di var/journal>`).

**Addestrarla.** La rete si addestra sul PC con i programmi di `scripts/figures/`, partendo dalle registrazioni della casa (**Calibrazione → Registra**). Ogni registrazione salva, per ogni personaggio riconosciuto, il riquadro della sua macchia: quello è il ritaglio con il suo nome.
1. Con tutti i personaggi in casa e riconosciuti, registra qualche minuto spostandoli in stanze e posizioni diverse, con luci diverse (luce della sala, una lampada laterale, gli scenari della casa) e con le ombre di chi sta vicino.
2. Copia sul PC `var/recordings/rec-*` (o `var/collect/rec-*`, la raccolta continua), `var/config/identities.json`, `var/domotiq.db` e `var/calibration`, poi:
   ```
   python scripts/figures/web_fixes.py domotiq.db identities.json correzioni.json [--since "AAAA-MM-GG HH:MM"]
   python scripts/figures/build_crops.py <registrazioni> identities.json crops [--journal journal] [--fixes correzioni.json]
   python scripts/figures/empty_crops.py calibration vuota     # la casa vuota sotto ogni luce: tutto "niente"
   python scripts/figures/preview.py crops anteprima.png      # controlla a occhio le etichette
   python scripts/figures/train.py rete crops vuota --only 2 --niente-weight 2   # prova su un blocco lasciato fuori
   python scripts/figures/train.py rete2 crops vuota --drop rete/suspect.json --niente-weight 2
   ```
   - **Le correzioni della piantina.** `web_fixes.py` ritrova nel database della casa quello che è stato corretto sulla piantina della webapp: una presenza eliminata era "niente" per tutto il tempo in cui è rimasta in quel punto; una presenza a cui è stato dato un nome era quel personaggio, anche mentre la casa la chiamava in un altro modo o non la chiamava. Con `--fixes` queste correzioni contano più delle etichette della casa. `--since` (facoltativo) prende solo le correzioni fatte da quel momento in poi.
   - **La casa vuota.** `empty_crops.py` fa ritagli "niente" dalle foto della casa vuota (quella salvata e quelle con le luci), alle misure delle macchie vere. Insegnano alla rete i mobili della casa anche prima che ci siano errori da correggere: per esempio un divano di un colore simile a quello di una statuina viene scambiato per una statuina molto più di rado.
   - **Il peso di "niente".** Ogni classe si vede circa lo stesso numero di volte; in più un errore su una statuina pesa di più, perché "niente" ha molti più esempi. Con `--niente-weight 2` un errore su "niente" pesa il doppio: calano sia le statuine vere prese per "niente" sia i ritagli "niente" presi per statuine. Con valori più alti, per esempio 4, le presenze false calano ancora, ma una statuina sdraiata sul prato comincia a diventare "niente".
   - **Il secondo addestramento** lascia fuori i ritagli su cui la rete è sicurissima di un'altra etichetta (lì aveva sbagliato la casa). Non vale per un nome dato a mano: lì la rete può essere sicura di un nome sbagliato solo perché la casa, prima della correzione, aveva chiamato così quella statuina.
3. Copia `figures.onnx` e `figures.json` in `models/vision/` sulla scheda e riavvia la casa.

Serve PyTorch sul PC (non sulla scheda). Le classi sono i nomi dei personaggi: dopo un personaggio nuovo, o con statuine diverse, la rete va addestrata di nuovo.

## Privacy

- **Tutto ciò che sta intorno alla casa è sfocato** in ogni immagine che lascia la scheda (il tavolo, le persone intorno, i loro telefoni), appena la casa sa dove si trova la base.
- **Il bagno è sfocato** di serie in ogni immagine che lascia la scheda: la diretta, le istantanee, le catture per i dataset e le sequenze registrate. Si può togliere in **Impostazioni → Bagno sfocato nella diretta**. Con il bagno sfocato anche la raccolta continua e le registrazioni lo sono, e non insegnano alla rete il bagno: lì la rete resta meno sicura. L'area sfocata è l'ingombro del bagno a livello del pavimento e alla cima delle sue pareti, più un margine, così all'interno non si vede niente, a qualsiasi altezza. L'area viene calcolata dalla calibrazione. Prima della calibrazione la casa presume che la webcam sia montata come da progetto e sfoca un'area più ampia attorno a dove dovrebbe trovarsi il bagno: calibra prima di usare la diretta, così la sfocatura si adatta esattamente al bagno.
- Il microfono registra solo mentre la casa ascolta; l'audio resta in memoria e non viene mai salvato.
- Niente lascia la scheda: niente internet, niente cloud. Le posizioni vengono conservate per 24 ore e gli eventi per 7 giorni.

## Dataset e registrazioni

La casa funziona senza addestramento, ma si possono raccogliere immagini anche per altri progetti, per esempio per addestrare un rilevatore. In **Altro → Calibrazione → Dataset**:

- **Cattura** salva il fotogramma attuale; **Raffica (10)** ne salva dieci di fila. Ogni immagine (JPEG 640 × 480, bagno sfocato) riceve etichette automatiche: un riquadro attorno a ogni oggetto trovato dalla visione, con il tipo e il nome della sua traccia; le mani vengono escluse.
- **Scarica il dataset** esporta uno zip con `images/`, `coco/annotations.json` (formato COCO, categorie person, dog, cat, animal, car, object, con il nome del personaggio come attributo) e `yolo/` (`classes.txt` e un file di etichette per immagine nel formato YOLO).
- **Registra una sequenza (60 s)** salva in `var/recordings/rec-DATE-TIME/` ogni fotogramma analizzato come JPEG sfocato, un file `detections.jsonl` con gli oggetti e le tracce di ogni fotogramma, la calibrazione e il riferimento della casa vuota. Sequenze come queste servono a provare l'inseguimento su un PC: `.venv/bin/python scripts/replay.py var/recordings/rec-DATE-TIME` fa girare il codice di visione attuale sui fotogrammi registrati e stampa quello che vede accanto a quello che la casa aveva visto allora (`--video out.mp4` scrive anche i fotogrammi con le tracce disegnate).

Avanti: [voce](08-voce.md).
