destone28/DomotiQ/docs/it/08-voce.md

# 8. Voce

La casa ascolta e parla in **italiano e in inglese**, interamente offline. I visitatori usano i tre tasti del totem: tengono premuto **Parla** per fare una domanda o dare un comando, premono **Citofono** per suonare il campanello e presentarsi, e premono **Lingua** per passare dall'italiano all'inglese e viceversa.

La catena vocale ha quattro parti:

- **Riconoscimento vocale**: Vosk, con i modelli piccoli italiano e inglese, sulla scheda.
- **Comprensione**: un analizzatore a regole, veloce, per le frasi più comuni; le frasi che non capisce passano a un piccolo modello linguistico, Qwen2.5-0.5B-Instruct su llama.cpp, che sceglie soltanto cosa fare.
- **Risposte**: sempre composte dal codice a partire dallo stato reale della casa.
- **Sintesi vocale**: Piper, con una voce naturale per l'italiano e una per l'inglese.

## I tasti

Visti dal visitatore, da sinistra:

| Tasto | Cosa fa | Il suo LED |
|---|---|---|
| **Parla** | Tienilo premuto e parla; rilascialo quando hai finito. Un bip segna l'inizio e la fine. Non c'è fretta: la casa ascolta finché il tasto resta premuto (fino a due minuti). Premere Parla mentre la casa sta parlando la interrompe. Con la [parola di attivazione](#la-parola-di-attivazione) basta dirla. | lampeggia mentre la casa ascolta (con gli altri due) |
| **Citofono** | Suona un campanello e la casa chiede "Chi è?" / "Who is it?". Di' un nome, senza premere niente: dopo la domanda la casa ascolta per 5 secondi. Vedi [il citofono](07-riconoscimento-e-identita.md#con-il-citofono). | lampeggia durante la conversazione |
| **Lingua** | Passa dall'italiano all'inglese e viceversa. Tutte le luci lampeggiano per circa un secondo, **verdi per l'italiano** e **rosse per l'inglese**, e la casa dice "Italiano" o "English". | acceso mentre la casa parla inglese |

Mentre la casa ascolta, **tutti e tre i LED** dei tasti **lampeggiano**; mentre elabora una risposta da dire, **respirano** (si accende il centro, poi tutti, poi di nuovo il centro, poi si spengono); mentre parla restano **accesi fissi**. Se il microfono si apre mentre la casa sta ancora finendo la frase, restano fissi finché non ha finito, poi lampeggiano.

La casa parte in italiano. Puoi cambiare la lingua anche dalla webapp, in **Comandi → Lingua della casa**, oppure a voce ("Parla inglese", "Speak Italian"). È la lingua in cui la casa parla e ascolta; ogni telefono sceglie per conto suo la lingua della webapp.

Durante la conversazione del citofono e la registrazione a voce, la casa ascolta da sola per qualche secondo dopo ognuna delle sue domande ("Chi è?", "Ho capito Marco, giusto?", "In che stanza l'hai messo?"). Anche alle sue domande su chi è chi ("In cucina c'è Marco o Leo?", a cui si può rispondere anche "tutti e due") e sull'ora si risponde senza premere niente.

## La parola di attivazione

In **Impostazioni → Voce** puoi accendere **Attivazione con la parola chiave** e scrivere la *Parola di attivazione*, per esempio *Casa*. Da quel momento dire la parola fa quello che fa il tasto Parla. I tre LED dei tasti cominciano a lampeggiare mentre la parola è ancora detta: il riconoscimento la segnala parola per parola, senza aspettare la fine della frase.

Puoi dire tutto insieme, "Casa, accendi la luce in cucina": dopo la parola la casa continua ad ascoltare fino alla prima pausa, e quello che segue è già la richiesta. **Se dici solo la parola, la casa risponde subito**: appena il riconoscimento libero ha scritto la parola, se per tre decimi di secondo non continui a parlare dice "Dimmi!" (oppure "Sì, dimmi!" o "Eccomi!"), una frase breve già pronta in memoria, poi ascolta la frase senza tasti e risponde. Se il riconoscimento libero non l'ha ancora scritta, la casa aspetta mezzo secondo di silenzio e la trascrizione completa: così le voci vicine che somigliano alla parola non ricevono un "Dimmi!".

Così è chiaro quando parlare: dopo la parola, o dopo il suo "Dimmi!". I LED lampeggiano dalla parola fino alla risposta senza spegnersi. Una sola parola dopo il nome vale come richiesta solo se ha un senso per la casa ("Casa, aiuto!"); un suono qualsiasi no. Il tasto Parla continua a funzionare.

- **Numeri e lettere.** La parola si confronta come la scrive il riconoscimento vocale: i numeri diventano parole, quindi *Robot 3*, *robot3* e *robot tre* sono la stessa parola (in inglese *Robot 3* è *robot three*). Salvando, la webapp mostra come la casa sentirà la parola.
- **Una parola che il riconoscimento vocale non conosce.** La casa la ascolta con parole che conosce e suonano uguali, per esempio *Domotiq* come «domotica». Le lettere che l'italiano non ha si scrivono come suonano: *q* e *k* come *c*, *w* come *v*, *y* come *i*. Se la parola finisce con una consonante, si prova anche con una vocale in fondo. La webapp lo dice: «che il riconoscimento vocale non conosce e sente come «domotica»». Una parola così si conferma sempre con il riconoscimento libero, anche detta da sola, perché la stessa grafia si sente anche nel finale di altre parole ("automatico" per "domotica"). Solo una parola senza nessuna grafia conosciuta va cambiata, e la webapp lo avvisa.
- **Quando ascolta.** Solo quando la casa è libera: non mentre parla (e per poco più di un secondo dopo, perché la sua voce potrebbe dire la parola), non durante una conversazione, una domanda della casa o una domanda ai personaggi, e non in modalità silenziosa. Il microfono resta acceso mentre aspetta la parola, ma l'audio non viene mai salvato né mandato da nessuna parte (la casa tiene in memoria solo gli ultimi due secondi, per non perdere la richiesta detta insieme alla parola); mentre aspetta la parola i LED restano spenti e lampeggiano dal momento in cui la sente.
- **Errori.** Una parola comune come "casa" può comparire in una conversazione tra visitatori ("che bella casa!") e svegliare la casa senza volerlo; una parola rara, o di due parole, sbaglia meno. Per questo la casa fa un controllo: il riconoscimento libero deve ritrovare la parola in quello che è stato detto. Se non la ritrova (per esempio "cosa facciamo?" sentito come "casa"), i LED si spengono e la casa non risponde. In una stanza rumorosa la casa può perdere qualche chiamata: in quel caso c'è sempre il tasto Parla.

## Loquacità

| Livello | Comportamento |
|---|---|
| **Silenziosa** | Non parla mai. Restano il campanello e i suoni brevi; le risposte e tutto il resto che la casa direbbe compaiono solo come sottotitoli nella webapp. |
| **Normale** | Risposte, citofono, allarmi e avvisi, gli eventi importanti delle regole, le domande della casa e una frase per chi entra, esce o cambia stanza (vedi *Il racconto della casa* più sotto). |
| **Chiacchierona** | Come Normale, più i commenti: le proposte ("Siete in tanti in soggiorno: facciamo festa?" con tre o più persone in soggiorno, "Che bella giornata in giardino: accendo il barbecue?" con due o più persone in giardino, al massimo ogni 10 minuti, con la risposta ascoltata senza Parla come per le domande), le frasi che le regole segnano come chiacchierone, come "La temperatura è tornata normale.", e le **domande ai personaggi** (sotto). |

Impostala da **Comandi → Loquacità**, oppure a voce: "Stai zitta" / "Be quiet", "Parla di più" / "Talk more", "Parla normale" / "Normal mode". Ogni frase che la casa dice compare anche come sottotitolo sui telefoni e in **Eventi → Detto dalla casa**.

## Parlare senza premere Parla

Dopo **ogni** sua domanda la casa ascolta da sola per qualche secondo, senza il tasto Parla: il saluto a un telefono nuovo, le domande ai personaggi, "chi è?" per un nuovo arrivato, i dubbi tra due personaggi, le conferme. Se la risposta non è chiara la chiede una seconda volta, e intanto la stessa domanda compare sui telefoni: vale la prima risposta, a voce o dall'app, e appena arriva la casa smette di ascoltare.

Il microfono si apre già mentre la casa finisce la domanda, e quello che sente viene scartato fino a un terzo di secondo dopo la sua ultima parola: così una risposta detta subito ("sì") non va persa mentre il registratore parte. Mentre ascolta, i tre LED dei tasti lampeggiano e sui telefoni compare *La casa ti ascolta…*; mentre elabora la risposta, i LED respirano.

Alla domanda "chi è?" su un nuovo arrivato si può rispondere con qualsiasi frase: la casa la capisce e risponde di conseguenza ([capitolo 7](07-riconoscimento-e-identita.md#un-nuovo-arrivato)). Se mentre ascolta la casa dice qualcos'altro (una regola, un avviso), la risposta viene scartata: potrebbe essere la sua stessa voce. **Parla** e il **citofono** vengono sempre prima: premerli interrompe il saluto o la domanda, e la casa ascolta il tasto.

**Un telefono nuovo.** La prima volta che un telefono apre la webapp, la casa lo saluta: "Ciao! Si è appena collegato un telefono nuovo. Come ti chiami?". Il nome si può dire a voce (la casa chiede conferma: "Ti chiami Luca?") oppure scrivere nella scheda che compare sul telefono; poi la casa invita a entrare con un personaggio, e il telefono propone **Aggiungi un personaggio**. Il nome diventa il soprannome del telefono, quello che compare nel registro delle modifiche.
- Ogni telefono viene salutato una volta sola, anche dopo un riavvio; un telefono che si ricollega dallo stesso indirizzo con un'altra pagina (l'icona sulla schermata Home, una finestra anonima, `casaN.lan`) è lo stesso telefono. La casa dimentica i telefoni (e i nomi) dopo 7 giorni.
- Se si collegano più telefoni insieme, un solo saluto per tutti, e al massimo un saluto a voce (o un ringraziamento) ogni 45 secondi: gli altri telefoni ricevono solo la scheda.
- I nomi **scritti** sui telefoni non vengono mai letti ad alta voce (una casella per il nome permetterebbe di far dire alla casa qualunque cosa): la casa ringrazia senza il nome, il telefono lo mostra. I nomi detti a voce sì, perché vengono dalle parole che il modello vocale conosce.
- **Più tardi** sulla scheda vale per quel telefono: la casa non lo chiede più. Se la scheda si perde (pagina ricaricata, telefono bloccato), torna una volta sola al ricollegamento.
- In modalità **Silenziosa** la casa non parla e non ascolta: resta la scheda sul telefono.
- Puoi spegnerlo da **Impostazioni → Voce → Saluta i telefoni nuovi**.

**Le domande ai personaggi** (solo in modalità **Chiacchierona**). Più o meno ogni due minuti, se ci sono visitatori (qualcosa è successo in casa negli ultimi 5 minuti: una statuina spostata, un tasto, un telefono), c'è un personaggio con un nome e la casa è libera, la casa gli fa una domanda adatta alla stanza in cui si trova, e ascolta la risposta:
- in cucina: "Marco, cosa cuciniamo stasera: pizza o pasta?", "hai fame?";
- in soggiorno: "ti va un po' di musica?" (con un sì parte la festa), "guardiamo un film?" (con un sì, scenario cinema), "preferisci il divano o la poltrona?";
- in camera: "hai dormito bene?", "ti abbasso le luci per riposare?" (con un sì la luce diventa tenue);
- in garage: "dove andiamo con la macchina: al mare o in montagna?";
- in giardino: "accendo il barbecue?" (con un sì parte la ventola), "ti piace il mio giardino?";
- dovunque: "ti piace questa casa?", "sei più da mattina o da sera?", "da dove vieni?", "qual è il tuo colore preferito?" (la luce della stanza prende quel colore);
- agli animali: "vuoi fare una passeggiata?", "hai fame?".

La risposta a una domanda di chiacchiera si confronta con poche parole attese (sì, no, pizza, pasta, i colori...) e non viene mai eseguita come un comando: "mi piace la musica" non fa partire la festa.

Le **proposte** (la musica, il film, la luce tenue, il barbecue e quelle ai gruppi della tabella qui sopra) capiscono invece le risposte come vengono: un sì, anche dentro una frase ("sì dai, mettiamo un po' di musica", "perché no", "magari", "volentieri", "dai"), esegue la proposta; un no ("no grazie", "non adesso", "più tardi") la lascia stare; un altro comando della casa detto al posto della risposta ("no, accendi il barbecue", "metti la luce rossa in soggiorno") esegue quel comando, e una luce senza stanza è quella della stanza del personaggio ("spegni tutte le luci" resta tutta la casa). Un sì non conta se la proposta stessa è rifiutata ("sì, ma niente musica", "dai, non accendere il barbecue"), e chi dice di non sopportarla ("odio la musica", "la musica è troppo alta", "spegni la tv" al film) risponde di no. Una frase che nomina la proposta senza chiederla ("ieri abbiamo fatto festa") non la esegue: la valuta il modello. Le frasi che le regole non capiscono passano al modello linguistico (più sotto), che dice soltanto se la risposta accetta, rifiuta o nessuna delle due; un sì di cui non è sicuro non basta.

Se la risposta non è chiara la casa chiede una volta "Scusa, non ho capito: sì o no?"; se nessuno risponde, per 30 secondi si può ancora dire "sì" con **Parla** (una domanda o un'altra richiesta detta intanto, come "c'è qualcuno in cucina?", ha la sua risposta e non chiude la proposta). La casa non propone quello che adesso non può fare (il barbecue già acceso, una festa appena finita, il cinema già in corso).

Senza risposta: "Niente? Sarà per la prossima volta, Marco." la prima volta, poi silenzio; dopo due domande senza risposta la casa aspetta un nuovo segno di visitatori. Mai in bagno né nel locale tecnico, mai due volte di fila allo stesso personaggio (con uno solo in casa aspetta che ne arrivi un altro), e non durante una festa, una conversazione, una registrazione o una domanda della casa. Le regoli da **Impostazioni → Voce**: *Domande ai personaggi* e *Una domanda ogni (s)* (almeno 45, di solito 120; il momento esatto varia di un quarto in più o in meno).

**Il racconto della casa.** In modalità **Normale** e **Chiacchierona** la casa dice in poche parole cosa succede: "Ecco Viola in soggiorno!", "Viola va in cucina.", "Luca entra in casa.", "Mister Braun esce sul vialetto.", "Ciao Rosaria, a presto!", "L'auto è parcheggiata in garage." (l'arrivo e la partenza dell'auto li dicono le regole: "Bentornato a casa!", "Buon viaggio!"). Aspetta che il movimento si sia fermato per un secondo, così una statuina che attraversa una stanza al volo non viene annunciata; quello che succede insieme lo dice in una volta sola; non parla sopra una domanda né mentre qualcuno parla con lei. Un nuovo arrivato che non conosce non viene annunciato: la casa chiede chi è.

Sul letto o sul divano lo dice ("Ecco Viola sul letto della camera!", "Mister Braun è sul divano del soggiorno."); su un tavolo, una panca, il frigo o gli altri mobili fa scendere subito ("Viola, scendi subito dal tavolo!"), e "Dov'è Viola?" risponde con il mobile. Non saluta chi è ancora in casa (per esempio posato altrove).

Quello che ha detto di un personaggio non lo ripete finché il personaggio resta lì: "Rossana è sul letto della camera" si sente una volta, non a ogni ombra sul bordo del letto né ogni volta che la casa ritrova il suo nome. Lo ridice dopo dieci minuti, oppure quando il personaggio passa davvero in un'altra stanza e poi torna. Una statuina che sparisce e ricompare al bordo dell'inquadratura, o che sale e scende da un mobile nella stessa stanza, non viene salutata né richiamata ogni volta: per dieci minuti la stessa frase su quel personaggio non si ripete. Le frasi più comuni, del racconto e delle domande, hanno diverse varianti, e la casa non dice mai la stessa due volte di fila.

## Cosa puoi dire

Gli esempi qui sotto vengono capiti direttamente dall'analizzatore a regole. Tollera gli errori di riconoscimento nei nomi e non richiede frasi esatte: le parole che contano sono i verbi, le stanze, i colori e i nomi dei personaggi. Un nome registrato detto da solo ("Luna") vale come "dov'è Luna?".

**I nomi prima di tutto.** Quando una frase nomina un personaggio, le richieste sui personaggi vengono prima di quelle generali: "Raccontami cosa piace a Rossellina" è una domanda su Rossellina, non "chi sei?" né "cosa sai fare?". Un nome storpiato dal riconoscimento viene ritrovato se gli somiglia abbastanza ("Rossellino" è Rossellina) o se ne contiene una parola tutta sua ("vista Brown" è Mister Brown, se nessun altro si chiama Brown). Le parole comuni a molti nomi (*Mister*, *Signora*, i colori, le stanze) da sole non bastano. Dopo una domanda su un personaggio, per un minuto e mezzo una domanda senza nome parla di lui: "Raccontami qualcosa di Rossellina", poi "che lavoro fa?", "cosa le piace?".

| Richiesta | Italiano | Inglese |
|---|---|---|
| Dove si trova qualcuno | Dov'è Marco? · Dove si trova Sofia? | Where is Marco? |
| Chi c'è in una stanza | Chi c'è in cucina? · C'è qualcuno in garage? | Who's in the living room? · Is anyone in the garage? |
| Quanti | Quante persone ci sono in casa? · Quanti animali ci sono? | How many people are in the bathroom? · How many pets are there? |
| Temperatura | Che temperatura c'è? · Temperatura in bagno | What is the temperature? |
| Umidità | Quanta umidità c'è in bagno? | How humid is the bathroom? |
| Ora | Che ore sono? | What time is it? |
| Impostare l'ora | Sono le tre e mezza · Sono le quindici e trenta | It's half past three · It's ten to seven pm |
| Accendere le luci | Accendi la luce in cucina · Luce rossa in camera | Turn on the kitchen light · Make the bedroom red |
| La luce preferita | Accendi la luce preferita di Marco · Metti il colore preferito di Giulia in cucina | Turn on Marco's favourite colour |
| Spegnere le luci | Spegni la luce in bagno · Spegni tutto | Turn off the lights in the garage |
| Scenari | Scenario cinema · Scenario relax · Modalità via · Buonanotte · Buongiorno | Cinema mode · Relax scene · Away mode · Good night · Good morning |
| Festa | Fai festa · Balliamo | Let's dance · Party |
| Barbecue | Accendi il barbecue · Spegni il barbecue | Light the barbecue · Turn off the barbecue |
| Climatizzatore e riscaldamento | Accendi il condizionatore · Accendi il clima · Accendi il riscaldamento · Spegni il climatizzatore · Spegni i climatizzatori | Turn on the air conditioning · Turn off the heating |
| L'auto | Dov'è la macchina? | Where is the car? |
| Tutta la casa | Com'è la casa? · Cosa succede? | How is the house? · What's happening? |
| Aiuto | Cosa sai fare? | What can you do? |
| Chi è la casa | Chi sei? | Who are you? |
| Una barzelletta | Raccontami una barzelletta · Fammi ridere | Tell me a joke · Make me laugh |
| Lingua | Parla inglese · Parla italiano | Speak English · Speak Italian |
| Loquacità | Stai zitta · Parla di più · Parla normale | Be quiet · Talk more · Normal mode |
| Volume | Alza il volume · Abbassa la musica | Louder · Turn it down |
| Nuovo personaggio | Aggiungi un personaggio | Add a character |
| Una storia | Raccontami una storia · Una storia su Marco e Giulia · Una storia sulla cucina · Un'altra storia | Tell me a story · A story about Marco and Giulia · A story about the kitchen · Another story |
| La giornata | Cosa ha fatto Marco oggi? · Dov'è stato Luca? · Chi è stato in cucina oggi? · Quante feste abbiamo fatto oggi? | What did Marco do today? · Where has Luca been? · Who has been in the kitchen today? · How many parties today? |
| Un personaggio | Ricorda che Marco fa il medico · Il colore preferito di Marco è il rosso · Il lavoro di Marco è il medico · Cosa sai di Marco? · Raccontami qualcosa di Marco · Cosa piace a Giulia? · Chi è Giulia? | Remember that Marco is a doctor · Marco's favourite colour is red · What do you know about Marco? · Tell me about Marco · What does Giulia like? · Who is Giulia? |
| Due personaggi insieme | Mister Brown e Rossellina stanno insieme · Marco e Giulia sono vicini | Marco and Giulia are together |
| I personaggi | Chi sono i personaggi che conosci? · Chi conosci? | Who do you know? · Which characters do you know? |
| Dire chi è una presenza | L'ospite in soggiorno è Rosaria · Quello in cucina si chiama Marco | The guest in the living room is Rosaria |
| Un'altra stanza, subito dopo | (dopo "chi c'è in cucina?") E in bagno? | (after "who's in the kitchen?") And in the bathroom? |
| Ricordi e domande libere | Ti ricordi la festa di compleanno di Giulia del 1998? · Luca ha pagato le bollette? · Quando scade l'assicurazione dell'auto? | Do you remember Giulia's birthday party in 1998? · Did Luca pay the bills? · When does the car insurance expire? |
| Annullare | Annulla · Lascia stare | Cancel · Never mind |

Colori: rosso/red, verde/green, blu/blue, giallo/yellow, arancione/orange, viola/purple, rosa/pink, bianco/white, azzurro/cyan, caldo/warm. Le stanze si possono chiamare in più modi: *soggiorno*, *salotto* o *sala*; *camera* o *camera da letto*; *locale tecnico* o *tecnico*; *living room*, *lounge*; e così via.

Qualche dettaglio:

- "Buonanotte" / "Good night" passa allo scenario Notte e augura la buonanotte; "Buongiorno" / "Good morning" torna allo scenario Normale e augura il buongiorno.
- Una luce accesa a voce resta accesa per due minuti; "spegni" la tiene al buio per un minuto; poi la stanza torna alla casa.
- Il volume cambia a passi di 15 (su 100).
- A una festa o a una grigliata chiesta troppo presto la casa risponde "Un attimo di pausa, poi rifacciamo festa!" oppure "Il barbecue è già acceso, o si sta raffreddando."
- "L'ospite in soggiorno è Rosaria" dà il nome alla presenza di quella stanza che la casa non conosce (o all'unica che c'è), come la scelta dalla webapp; con un nome nuovo nasce un personaggio nuovo ("Piacere, Giacomo!"). Con più presenze sconosciute nella stanza, chiede di indicarla dalla webapp.
- Subito dopo una domanda su una stanza (chi c'è, quanti, temperatura, umidità, luci), per un minuto e mezzo basta dire un'altra stanza: "E in bagno?" fa la stessa domanda per il bagno.
- A una domanda su un personaggio senza nome, se poco prima non si è parlato di nessuno ("che lavoro fa?"), la casa chiede "Di chi?" e ascolta la risposta senza Parla.
- "Dov'è Tommaso?" con un nome che la casa non conosce risponde "Non conosco nessuno che si chiama Tommaso."
- "Accendi il condizionatore" (o il climatizzatore, il clima) fa quello che fa il termostato quando sente caldo: "Accendo il climatizzatore." e un'onda azzurra in tutte le stanze per due minuti. "Accendi il riscaldamento" fa un'onda arancione, "spegni il climatizzatore" la ferma. Se la casa sente solo il nome ("climatizzatore", "riscaldamento"), perché un "spegni" detto in fretta si perde facilmente, fa da interruttore: spegne l'onda se c'è, anche quella del termostato, e la accende se non c'è. La casa non ha un climatizzatore vero: la ventola del plastico è quella del barbecue.
- Un'informazione su un personaggio detta così com'è, senza "ricorda che", si aggiunge a quelle che la casa sa di lui: "il colore preferito di Mister Blu è l'azzurro" → "Me lo ricorderò: Mister Blu ha come colore preferito l'azzurro." Per il colore prende il posto di quello detto prima, e la luce preferita lo segue. Detta come domanda ("qual è il colore preferito di Mister Blu?") resta una domanda.
- Una o due parole che la casa non capisce ricevono "Non ho capito", non una risposta inventata. Dopo, ogni volta, la casa propone una richiesta diversa da provare, tra quelle che il suo riconoscimento sente meglio: "Prova a chiedermi che ore sono", "Chiedimi dov'è un personaggio, chiamandolo per nome", "Prova a chiedermi una grigliata: facciamo una bella grigliata!". Le propone tutte una volta prima di ripeterne una.
- Alcune frasi che il riconoscimento sente spesso storpiate sono capite come erano state dette: "fai presto" e "let's body" fanno festa.
- "Mister Brown e Rossellina stanno insieme" dice alla casa che la sagoma che vede è fatta dei due personaggi che si toccano: due statuine a contatto sono una sola macchia, e la casa le segna presenti tutte e due, una nascosta dietro l'altra finché una mano non le separa (come la risposta "tutti e due" in [un nuovo arrivato](07-riconoscimento-e-identita.md#un-nuovo-arrivato)). La casa cerca la sagoma che ha già uno dei due nomi, oppure l'unica che non riconosce; se dici la stanza ("...in soggiorno") cerca lì. Se non la trova risponde "Non li vedo: mettili dove la webcam li vede, oppure dimmi in che stanza sono."

Ecco come suonano le risposte: "Marco è in cucina." / "Marco is in the kitchen.", "In cucina ci sono Marco e un cane.", "In casa ci sono 2 persone.", "In soggiorno ci sono 24.3 gradi.", "L'auto è parcheggiata in garage." Quando la casa non è sicura di una statuina aggiunge "Almeno credo." / "I think.".

## Il modello linguistico dei comandi

Una frase che l'analizzatore non capisce ("Quanta gente c'è in cucina?", una richiesta con parole insolite, una frase storpiata dal riconoscimento) passa a **Qwen2.5-0.5B-Instruct** (quantizzato a 4 bit, in formato GGUF), fatto girare da `llama-server` di llama.cpp nel servizio `domotiq-llm`. Mentre lavora, la casa dice "Vediamo…" / "Let me see…".

Il modello riceve istruzioni fisse con le stanze, i comandi della casa e qualche esempio, poi i nomi dei personaggi registrati e la frase. La sua uscita è vincolata mentre viene prodotta, così può scrivere soltanto un comando della casa con i suoi argomenti: *where_is Marco*, *who_in kitchen*, *lights_on bedroom purple*, oppure *other* per tutto il resto. Le istruzioni sono sempre lo stesso testo, che `llama-server` tiene nella sua cache. **La stessa frase non si chiede due volte**: la casa ricorda le ultime 256 risposte del modello (con gli stessi personaggi registrati la risposta sarebbe la stessa) e a una frase già sentita risponde subito, senza "Vediamo…".

Lo stesso modello capisce anche le risposte a "chi è?" che le regole non riconoscono: le classifica come nome, tipo, sì, no, "non c'è nessuno", "non lo so" o altro; una frase con due nomi registrati ("guarda che ci sono sia Viola che Rosaria") vuol dire che ci sono tutti e due. Un nome che propone vale solo se è nella frase; il tipo e i nomi registrati la casa li legge nella frase stessa, quindi il modello non può inventare un personaggio. Queste istruzioni stanno in un secondo slot di `llama-server`, in un terzo quelle che dicono se una risposta accetta una proposta della casa e in un quarto quelle che dicono di cosa parla un'informazione su un personaggio quando nessuna parola chiave lo dice ([Cosa sa dei personaggi](#cosa-sa-dei-personaggi)): `-np 4`, contesto 8192, così nessun tipo di richiesta toglie gli altri dalla cache.

**L'avvio del modello.** Le quattro istruzioni (con i loro esempi) sono lunghe 5.458 token: sui core Cortex-A53 della scheda, con 3 thread a bassa priorità per non rallentare visione e voce, il modello le legge in circa 9 minuti. Per accorciare questa attesa l'installazione applica a llama.cpp dei calcoli scritti apposta per questo processore, che non ha l'istruzione per il prodotto scalare (`scripts/llama/arm-nodot.patch`).

Dopo la prima lettura ogni slot si salva in `/var/lib/domotiq-llm` (`--slot-save-path`, 67 MB in tutto) e agli avvii successivi torna in cache in pochi secondi. Si rilegge solo se cambiano le istruzioni, il modello o il modo in cui il servizio tiene la memoria (per esempio la flash attention, spenta perché su questi core le richieste sono più veloci senza). La lettura parte insieme alla preparazione delle frasi della voce, non dopo. Finché il modello non è pronto le regole funzionano lo stesso, e solo una frase libera che avrebbe bisogno del modello ottiene "non ho capito". Poi una risposta libera richiede circa 2 secondi (da 1,6 a 3,4 secondi).

**Questo modello sceglie cosa fare e non scrive mai quello che dice la casa**: la risposta si compone dallo stato reale della casa, con frasi preparate in italiano e in inglese, quindi non può inventare. Lo stesso vale per la giornata dei personaggi ("Cosa ha fatto Marco oggi?"): la risposta viene da quello che la webcam ha visto davvero, non da un modello.

## Storie, ricordi e domande libere

Le storie, i ricordi ("Ti ricordi la festa di compleanno di Giulia del 1998?") e le risposte sulla vita di casa ("Luca ha pagato le bollette?", "Quando scade l'assicurazione dell'auto?") la casa le genera sulla scheda combinando i pezzi di un database locale, `data/stories.json`, scritto a mano in italiano e in inglese: momenti ("Una sera d'inverno"), attività per ogni stanza, eventi, reazioni, relazioni tra personaggi, scoperte, finali, personalità (lavori, caratteri, passioni e manie, anche per cani e gatti), dettagli della vita di casa (bollette, assicurazioni, faccende, spesa, torte, vacanze) e le tracce di sei tipi di storia (da soli, al lavoro, in coppia, lo scherzo sospetto, la festa a sorpresa, la stanza).

È generazione procedurale: la casa sceglie a caso tra i pezzi che stanno bene insieme e li incastra nella traccia. Poche centinaia di pezzi danno milioni di storie diverse, pronte in un millesimo di secondo, e ogni frase è corretta perché ogni pezzo è scritto per andare d'accordo con qualunque nome: in italiano nessun aggettivo o participio si riferisce a un personaggio, in inglese niente *he* o *she*. Qui la casa inventa, ed è voluto:

- **Pezzi che stanno insieme.** Una scoperta o un finale può essere legato agli eventi che spiega (il pacco senza nome era un regalo per la casa); gli altri pezzi condividono un'etichetta con l'evento (buio, rumore, acqua, festa…). Giorno e notte, estate e inverno non si incontrano mai nella stessa storia; il rumore "dal garage" non lo sente chi è già in garage; i cani abbaiano e i gatti soffiano.
- **Personalità.** La prima volta che serve, un personaggio riceve dal database un lavoro, un carattere, una passione e una mania, diversi da quelli degli altri. Restano gli stessi fino al riavvio della casa: se Marco è un medico, nelle storie successive resta un medico; al riavvio si riparte da capo. Quello che è stato detto alla casa viene prima (nella webapp, in *Chi è*, una cosa per riga, oppure a voce: "Ricorda che Marco fa il medico"). Un'informazione che è un lavoro prende il posto del lavoro, e nelle storie in inglese diventa il lavoro corrispondente del database ("works at the hospital"); le altre entrano nelle storie scritte nella loro lingua ("Marco, che ama il jazz, …"). "Cosa sai di Marco?" risponde dicendo prima dove si trova Marco, poi le informazioni date e la personalità; un'informazione scritta nell'altra lingua si legge con la voce di quella lingua.
- **Sempre una storia nuova.** Per ogni personaggio (o stanza) la casa ricorda le tracce e i pezzi già usati e sceglie tra gli altri finché non li ha usati tutti.
- **La vita della casa.** Alla prima domanda la risposta si inventa dal database, poi resta: la stessa domanda riceve la stessa risposta, anche nell'altra lingua, fino al riavvio. La casa sa rispondere su bollette (tutte o una sola: luce, gas, acqua, internet; chi le ha pagate e quando, oppure quando scadono), assicurazione dell'auto e della casa, compleanni, feste passate (con il nome e l'anno, anche di qualcuno che non conosce, oppure "la festa di Natale del 2005": la stanza, la torta, cosa successe e chi c'era), spesa, faccende (spazzatura, piatti, bucato, aspirapolvere, piante), la pappa degli animali, l'auto, le vacanze e i ricordi di un personaggio. A una domanda che non riguarda la casa risponde che è una casa e del resto del mondo non sa niente.
- **Detta frase per frase.** Mentre una frase suona si sintetizza la successiva, ognuna con la voce della sua lingua, e la stanza di cui parla si accende. **Parla** interrompe la storia; anche un cambio di lingua la ferma.

In modalità **Chiacchierona**, circa due volte su cinque al posto di una domanda della lista la casa dice qualcosa su un personaggio presente: un aneddoto, la sua mania ("Lo sapevate che Marco parla alle piante?"), un ricordo con la data ("Vi ricordate la festa di Marco del 2004?") oppure una domanda sulla vita di casa ("Marco, hai pagato la bolletta della luce?"), seguita dalla risposta a un sì o a un no. Quello che dice il visitatore diventa la vita della casa: dopo un sì, a "Marco ha pagato la bolletta della luce?" la casa risponde di sì. Una domanda detta come risposta continua il discorso: a "Viola, lo sai che manca poco al tuo compleanno?" si può rispondere "Quando?" ("Il compleanno di Viola è il 12 marzo."), alla domanda sulle vacanze "Dove?"; una richiesta o una domanda per la casa ("che ore sono?") ha la sua risposta.

Storie, ricordi e domande libere non usano nessun modello linguistico, quindi funzionano anche con un'installazione `--no-llm`.

## Cosa sa dei personaggi

Una risposta a una domanda della modalità chiacchierona che dice qualcosa di duraturo su un personaggio diventa una sua informazione, come quelle di *Chi è* nella webapp: scritta come si direbbe dopo il nome, nella lingua della conversazione. "Qual è il tuo piatto preferito?" → "la pizza" diventa "adora mangiare la pizza", e la casa risponde "Me lo segno: Rossellina adora mangiare la pizza."; "da dove vieni?" → "viene da Torino". Pizza o pasta, divano o poltrona, mare o montagna, mattina o sera, il colore preferito, la casa e il giardino si segnano senza dire altro.

Le domande sul momento ("hai fame?", "hai dormito bene?") e le proposte ("ti va un po' di musica?") non si segnano, né una risposta poco chiara ("boh"), troppo lunga o sentita male, né una che parla di chi risponde invece di dare un piatto o un posto ("sono vegetariano", "sono italiana", "mi chiamo Giulia"). Una scelta negata vale per l'altra ("non la pizza, la pasta", "il mare no, la montagna"); "non mi piace il rosso" non è un colore preferito.

Ogni domanda tiene una riga sola: una risposta nuova prende il posto della vecchia, anche se era nell'altra lingua; quando le righe sono già otto lascia il posto la risposta più vecchia, mai una riga scritta da qualcuno (a meno che non abbia proprio la forma di una risposta, come "adora mangiare la pizza": "viene da una famiglia di musicisti" resta com'è). Le righe nate da una risposta si leggono nelle due lingue: in inglese "adora mangiare la pizza" diventa "loves eating pizza", nelle storie e nelle risposte.

La casa risponde poi alle domande su quello che sa, anche dette con altre parole: "Cosa mangia Rossellina?", "Qual è il pranzo preferito da Rossellina?", "Cosa posso cucinare a Rossellina?", "What does Rossellina like to eat?" → "So che Rossellina adora mangiare la pizza.". Le parole chiave delle due lingue dicono di cosa parla la domanda (cibo, bevande, colori, musica, sport, lavoro, paure, passatempi, viaggi, divano e poltrona, provenienza, animali, famiglia, età, la casa, mattina e sera) e di cosa parla ogni informazione.

Quando nessuna parola chiave lo dice, la casa cerca le informazioni che hanno una parola in comune con la domanda ("Marco suona la chitarra?" trova "suona la chitarra in una band"); a una domanda su cosa piace a qualcuno risponde con quello che ama. Per un'informazione scritta nella webapp che nessuna parola chiave descrive ("ha un debole per i fumetti") l'argomento lo dice il modello linguistico, che può scrivere soltanto uno di quegli argomenti: lo fa in sottofondo, quando la casa è libera, appena l'informazione viene scritta, così la domanda la trova senza aspettarlo.

La risposta è l'informazione stessa dopo il nome, quindi la casa non inventa e la frase va d'accordo con qualunque nome; un'informazione scritta come frase intera ("il suo piatto preferito è la carbonara") si dice com'è: "Di Rossellina so che il suo piatto preferito è la carbonara." Se di quell'argomento non sa niente lo dice: "Non lo so: Rossellina non me l'ha ancora detto." **La risposta è sempre immediata**, come quella dei comandi delle luci: nessuna domanda su un personaggio aspetta il modello linguistico.

Le domande sulla vita di casa (bollette, spesa, faccende…) restano alle storie; sulle vacanze un'informazione viene prima della risposta inventata. Una richiesta che nomina un personaggio resta una richiesta ("Marco vuole sentire la musica", "musica per Marco", "Marco ha fame, accendi il barbecue"), e "Marco è sul divano?" chiede dov'è adesso, non dove gli piace sedersi.

**Cosa ne fa.** Tre risposte la casa le usa per agire:

- **Il colore preferito** ("Marco, qual è il tuo colore preferito?"): "accendi la luce preferita di Marco" accende la stanza in cui si trova Marco, o quella detta ("...in cucina"), del suo colore. Se Marco non l'ha ancora detto e si trova in casa, la casa glielo chiede subito e la risposta accende la stanza. Le luci che seguono le persone sono spente di serie (vedi il [capitolo 9](09-regole.md#priorità-e-livelli-delle-luci)); se le accendi e in `var/config/settings.json` metti anche `"follow_favourite": true` nella sezione `"lights"`, nello scenario Normale la luce di una stanza prende il colore preferito di chi c'è, di chi è entrato per ultimo tra quelli che l'hanno detto.
- **Ama ballare** ("Marco, ti piace ballare?"): in modalità chiacchierona, quando Marco è in soggiorno con qualcun altro, la casa gli propone una festa ("Marco, tu che ami ballare: facciamo festa?").
- **Ama le grigliate** ("Marco, ti piacciono le grigliate?"): quando Marco è in giardino, la casa gli propone il barbecue ("Marco, tu che adori le grigliate: accendo il barbecue?").

Queste proposte si ascoltano senza Parla come le altre, al massimo una ogni 10 minuti per tipo. **Fai una domanda**, in **Comandi** e sulla scheda di ogni personaggio, fa fare alla casa una di queste domande subito, anche fuori dalla modalità chiacchierona, preferendo quelle a cui il personaggio non ha ancora risposto: a un personaggio scelto a caso tra quelli in casa, o a quello della scheda, anche se non è in casa.

### Quando non sa, chiede e impara

Quando la casa non sa rispondere, non si limita a dire "non lo so".
- **Su un personaggio** ("cosa ama Rossellina?", "che musica ascolta Marco?") dice che non lo sa e chiede: "Tu lo sai? Dimmelo e me lo ricorderò.", poi ascolta senza Parla.
  - La risposta diventa un'informazione del personaggio, scritta in base all'argomento della domanda. Esempi: "le piace il gelato" → "ama il gelato", "il rock" → "ascolta il rock", "Napoli" → "viene da Napoli", "la maestra" → "fa la maestra".
  - La casa ripete cosa ha capito ("Grazie! Me lo segno: Marco ama il gelato.") e la usa per ogni domanda dello stesso argomento, anche detta con altre parole: "cosa ama Marco?" e "cosa piace a Marco?" hanno la stessa risposta.
  - Una risposta che non trova posto fra le informazioni ("Marco ha la patente?" → "sì") resta com'è: la volta dopo "Mi hanno detto di sì."
- **Sul mondo** ("che tempo farà domani?") chiede se preferisci aspettare che ci pensi o dirglielo tu (vedi *Le domande sul mondo* qui sotto); senza il modello delle risposte libere (installazione `--no-llm`) chiede soltanto "Tu lo sai?". Quello che si sente dire lo ricorda, e alla prossima domanda uguale o simile risponde "Mi hanno detto che domani piove.". "Che tempo fa domani?" e "domani piove?" sono la stessa domanda. Quello che riguarda oggi o domani vale per un giorno.
- **Su sé stessa** (le stanze, i mobili, "chi ti ha costruita?", "perché la cucina è gialla?") inventa una spiegazione plausibile e dice che è quello che pensa: "Penso che sia perché chi mi ha costruita voleva così.". Alla stessa domanda dà sempre la stessa risposta.

**Le domande sul mondo.** Una domanda che non riguarda la casa, i suoi personaggi o quello che la casa sa fare ("Come si fa la pizza?", "Perché il cielo è blu?") ha una strada sua. La casa dice subito che deve pensarci e chiede: "Ci devo pensare un attimo. Preferisci aspettare qualche secondo, o me lo dici tu?".
- **"Aspetto"** (anche "sì", "pensaci tu", o il silenzio): "Va bene, ci penso. Un attimo..." e i tasti respirano. Un secondo modello linguistico, Qwen3.5-0.8B (servizio `domotiq-chat`), scrive la risposta da zero in 20-50 secondi, e la casa la dice ("Ecco cosa ne penso: ..."). È un modello piccolo: scrive un italiano sensato, ma sui fatti può sbagliare.
- **"Te lo dico io"**: "Dimmi pure!", e la casa tiene la risposta. Anche la risposta detta subito, senza "te lo dico io", vale.
- **"Lascia stare"** o "non lo so": "D'accordo, lasciamo stare.". Un comando al posto della scelta viene eseguito.

Quello che la casa ha pensato o si è sentita dire resta in `var/config/knowledge.json`: alla stessa domanda, o a una simile, risponde subito. La casa ripete quello che ha imparato ("Grazie! Se mi chiedono come si fa la pizza, risponderò: …"), così una parola sentita male si corregge subito.

**Correggere una risposta sbagliata.**
- **"Sbagliato".** Subito dopo una risposta presa da quello che ha imparato (entro 3 minuti, senza altro in mezzo), "sbagliato", "non è vero", "non è così" o "non è giusto" fanno chiedere "Scusa! Qual è la risposta giusta?". La risposta detta nella stessa frase vale subito: "Non è vero, ci vuole acqua, farina, lievito e sale".
- **"Te lo dico io come si fa la pizza".** Corregge anche più tardi: "Dimmi pure!", e la risposta prende il posto di quella di prima. "Te lo dico io" da solo vale per l'ultima risposta; se non ce n'è, la casa chiede prima la domanda.
- **Chi vince.** Quello che qualcuno insegna vince sempre su quello che la casa ha pensato o immaginato.
- **Dalla webapp.** Tutto si corregge o si cancella anche dalla pagina **Altro → Cosa ha imparato** (capitolo 6), compresa una domanda sentita male.
- **Le domande corte.** Una parola o due ("pizza") non bastano per ripetere una risposta imparata: servono almeno tre parole, o un argomento come il meteo ("domani piove?").

"Non lo so", "boh", il silenzio o un comando al posto della risposta ("accendi la luce") non insegnano niente: la casa risponde "Va bene, lo chiederò a qualcun altro." o esegue il comando. Una risposta sentita male (riconoscimento poco sicuro) non viene tenuta. Quello che la casa impara sul mondo e su sé stessa sta in `var/config/knowledge.json` (le ultime 300 cose); quello sui personaggi tra le loro informazioni, che la webapp mostra e chiunque può correggere.

## Riconoscimento vocale

I modelli Vosk sono `vosk-model-small-it-0.22` e `vosk-model-small-en-us-0.15` (Apache-2.0). La casa li usa in due modi:

- **Un elenco chiuso di frasi** per i nomi, il sì/no e le opzioni di una domanda: il modello accetta solo quelle parole, il che lo rende veloce (meno di mezzo secondo per un nome sulla scheda) e molto difficile da ingannare;
- **Parlato libero** per domande e comandi, trasformato poi in un intento.

Alle sue domande la casa ascolta in tutti e due i modi lo stesso audio, contemporaneamente e su due core diversi: quando la frase finisce, anche il parlato libero è già pronto.

**I nomi dentro una frase libera.** Con il tasto Parla e con la parola di attivazione, mentre il riconoscimento libero trascrive la frase, sul secondo core un altro riconoscimento ascolta lo stesso audio conoscendo soltanto i nomi dei personaggi registrati. Serve quando un nome non è una parola della lingua: "Dov'è l'Honda Civic?" può essere trascritto "dovevo music", mentre il riconoscimento dei soli nomi sente "honda civic".

Se la frase libera non contiene nomi e non è un comando che la casa conosce, o chiede di un nome che la casa non conosce ("dov'è misteri?"), la casa usa il nome sentito così: con "dove" (o "cerca") risponde dov'è, altrimenti lo aggiunge alla frase. Conta solo un nome sentito intero: "honda" da solo, uscito da "andato", non è l'Honda Civic.

Un nome che il modello non conosce entra nell'elenco con una scrittura che il modello conosce, con una doppia scritta singola o divisa in due parole: "Rossellina" si ascolta come "rosellina", e quando la sente la casa ritrova il nome. Alla registrazione la casa avvisa solo se non trova nessuna scrittura così.

Vale la parola dell'elenco quando il parlato libero la conferma o le somiglia, oppure quando il riconoscimento ne è molto sicuro e la risposta è corta (fino a tre parole); altrimenti vale il parlato libero, che capisce anche le risposte con parole diverse da quelle attese ("direi di sì", "mi sa la pasta").

**Le frasi più probabili.** Per una richiesta libera, con il tasto Parla o dopo "Dimmi!", il riconoscimento tiene le cinque frasi più probabili. Se le regole non capiscono la prima, provano le altre: "fece in camera da letto" può essere anche "chi c'è in camera da letto". Le regole accettano anche le frasi come le scrive il riconoscimento ("dove Viola" per "dov'è Viola", "come la casa", "a nulla" per "annulla", "spegne la luce") e quelle con una parola persa nel rumore ("chi in cucina").

Il microfono è acceso solo mentre la casa ascolta, a 16 kHz mono: mentre Parla è premuto, dopo "Chi è?" e per qualche secondo dopo il saluto a un telefono nuovo o una domanda della modalità chiacchierona; con la [parola di attivazione](#la-parola-di-attivazione) accesa, anche mentre la casa è libera e aspetta la parola.

Il registro di sistema della scheda (`journalctl -u domotiq`, solo per chi ha accesso alla scheda) riporta le frasi sentite e quelle dette dalla casa, per controllarne il comportamento; non va ai telefoni. L'audio resta in memoria e non viene mai salvato; di quello che la casa sente senza Parla resta nel registro solo l'esito (sì, no, un'opzione), mai il testo, e il testo riconosciuto non viene mandato ai telefoni.

Fa eccezione una risposta che diventa un'informazione di un personaggio ([Cosa sa dei personaggi](#cosa-sa-dei-personaggi)): resta tra le sue informazioni, che la webapp mostra e chiunque può correggere o cancellare. La risposta di un visitatore a una domanda sulla vita di casa (modalità chiacchierona) resta nella memoria del narratore, per le storie successive, fino al riavvio: non viene scritta su disco.

## Sintesi vocale

**Una frase alla volta.** Sulla scheda, con la casa accesa, una frase di tre secondi e mezzo richiede a Piper circa 4,5 secondi. Per questo una risposta di più frasi si prepara frase per frase: la casa dice la prima mentre prepara la seconda, e la prima frase si sente dopo il tempo che serve per lei sola, non per tutta la risposta.

Piper (`piper1-gpl`, GPL-3.0) gira come programma separato nel servizio `domotiq-tts`, e la casa gli manda le frasi via HTTP sull'interfaccia di loopback. Le voci sono `it_IT-serena-medium` (CC BY 4.0) e `en_US-ljspeech-medium` (pubblico dominio). Numeri e unità di misura vengono pronunciati come si deve ("24.3 °C" diventa "24 virgola 3 gradi" in italiano e "24 point 3 degrees" in inglese).

Le frasi frequenti ("Chi è?", "Vediamo…", "Si balla!"…) vengono preparate all'avvio e tenute in memoria, così partono subito anche quando il processore è impegnato. **Ogni frase sintetizzata si salva anche su disco**, in `var/voice/` (un file WAV per frase, con il nome ricavato dalla voce e dal testo): dopo un riavvio la casa la rilegge in un attimo invece di chiederla di nuovo a Piper, quindi le frasi frequenti sono pronte subito e Piper lavora solo per quelle mai dette. Restano al massimo 3000 frasi; quando sono di più si cancellano quelle non dette da più tempo. Il nome del file dipende anche dalla voce: se sostituisci una voce di Piper, le frasi si sintetizzano di nuovo.

**Le frasi fisse** (alcune centinaia, quelle senza nomi né numeri: il campanello, le domande, le conferme, le risposte preparate) **si possono preparare in anticipo** con `scripts/voice_cache.py`, che le prende dal codice stesso della casa e le scrive in `models/voice-cache/`. La casa legge anche quella cartella, quindi una casa nuova le dice subito dal primo avvio. Lo script si può lanciare sulla scheda, con il suo Piper, oppure su un PC con la stessa versione di Piper e le stesse voci; `release.sh` copia la cartella dal PC alla scheda (vedi il [capitolo 2](02-installazione.md)). Sul PC basta circa un minuto; sulla scheda servono parecchi minuti.

Alcune frasi si passano a Piper già trascritte in fonemi, dove la voce italiana mangerebbe una vocale: altrimenti "Come si chiama?" uscirebbe come "Cme s chiama?", perché la trascrizione automatica legge "si" come una vocale ridotta. La casa non dice mai "Mmm" o "Hmm": le voci li leggono lettera per lettera ("emme emme emme"). Al loro posto la casa dice "Fammi pensare...", "Ah," o "Scusa,", e un "Mmm" in una frase scritta da qualcuno viene tolto prima della sintesi.

Tutti gli altri suoni (campanello, campanello breve, i bip di Parla, allarme, notifica) e la musica della festa sono sintetizzati dal codice stesso della casa: nessun campione registrato. La musica della festa è dance in cassa dritta a 124 BPM, con kick, clap, hi-hat, basso, accordi e una melodia che cambiano a ogni festa, a tempo con lo spettacolo di luci del microcontrollore. Quando la casa parla, la musica si abbassa sotto la voce.

## Impostare l'ora a voce

La UNO Q non ha una batteria per l'orologio. L'ora impostata (da un telefono, a voce o dalle impostazioni) vale finché la scheda resta accesa: se riparte solo l'applicazione, per un aggiornamento o per il watchdog, la casa non la chiede di nuovo. Se due minuti dopo l'avvio l'ora è ancora sconosciuta, la casa lo chiede una volta (a meno che non sia Silenziosa): "Non so che ore sono: che ore sono adesso?", e ascolta subito la risposta, senza il tasto Parla. Fa lo stesso dopo "Che ore sono?" quando non lo sa. In qualsiasi momento puoi anche tenere premuto **Parla** e dire l'ora:

- In italiano: "Sono le quindici e trenta", "Sono le tre e mezza", "Sono le tre e venticinque", "Sono le dieci e un quarto", "Sono le tre e tre quarti", "Sono le otto meno venti", "Sono le sette meno un quarto", "È l'una e dieci". Va bene qualsiasi minuto, in lettere o in cifre; "del pomeriggio" o "di sera" aggiungono dodici ore.
- In inglese: "It's half past three", "It's quarter to five", "It's twenty past six", "It's ten to seven pm", "It's five twenty", "Set the clock at three thirty". "pm", "afternoon" o "evening" aggiungono dodici ore.

La casa conferma: "D'accordo, sono le 15 e 30." / "All right, it's 15:30." Anche il primo telefono che apre la webapp imposta l'orologio, e puoi impostarlo da **Impostazioni → Usa l'ora di questo telefono**.

Avanti: [regole](09-regole.md).
