destone28/DomotiQ/docs/it/index.md

# Guida di DomotiQ

DomotiQ è una casa intelligente in scala 1:20 che funziona interamente offline su una sola **Arduino UNO Q 4GB**. Una webcam su un palo guarda la casa dall'alto e, con la visione artificiale, segue personaggi, animali, un'auto giocattolo e oggetti. Le regole reagiscono a quello che succede con luci, suoni e avvisi, un'interfaccia vocale risponde alle domande in italiano e in inglese, e qualsiasi telefono può aprire la webapp della casa attraverso l'hotspot Wi-Fi della scheda.

Questa guida copre tutto il progetto, da una scheda nuova di fabbrica fino a una casa che funziona. I capitoli seguono l'ordine in cui costruisci la casa.

## Capitoli

1. [Preparare la UNO Q](01-preparare-uno-q.md): prima password, SSH, nomi di rete, aggiornamento del sistema, accesso da un PC.
2. [Installare il software](02-installazione.md): `install.sh`, i servizi, l'hotspot, gli aggiornamenti.
3. [Stampa e montaggio](03-stampa-e-montaggio.md): i file STL numerati e come si montano i pezzi.
4. [Collegamenti](04-collegamenti.md): la catena Qwiic attraverso il Modulino Hub, l'alimentazione, relè e ventola, l'audio, la webcam.
5. [Collaudo e messa in servizio](05-collaudo.md): la verifica di ogni parte, la calibrazione della webcam, il primo personaggio, la voce, i telefoni.
6. [La webapp](06-webapp.md): come aprirla, tutte le schermate, chi può fare cosa, le notifiche e le domande.
7. [Riconoscimento e identità](07-riconoscimento-e-identita.md): come vede la casa, la registrazione dei personaggi, la rete che conosce le statuine, la privacy, i dataset.
8. [Voce](08-voce.md): i tasti, le lingue, la loquacità, frasi di esempio, il modello linguistico.
9. [Regole](09-regole.md): Quando / Se / Allora, tutti gli eventi, le condizioni e le azioni, le regole di partenza, i livelli delle luci, gli scenari.
10. [Attribuzioni](10-attribuzioni.md): le licenze del progetto e di ogni componente di terze parti.
11. [Risoluzione dei problemi](11-risoluzione-problemi.md): sintomo, causa e soluzione.

Per l'uso di tutti i giorni c'è una [guida rapida](guida-rapida.md) di una sola pagina: accensione, preparazione, tasti, telefoni e cosa fare quando qualcosa non va.

## In breve

| | |
|---|---|
| Nome host | `casa1` |
| Utente e password | `arduino`, `domotiq2026` (scelta nel [capitolo 1](01-preparare-uno-q.md)) |
| Hotspot Wi-Fi | `DomotiQ-Casa1` (canale 1), password `domotica2026` |
| Webapp | `http://10.42.1.1/` |
| Altri nomi | `casa1.lan`, `casa1.local` |
| Cartella del progetto | `/home/arduino/domotiq` |

## Licenza e attribuzione

Il codice sorgente è distribuito sotto licenza MIT; documentazione, immagini, file di stampa 3D e i dati in `data/` sono distribuiti sotto CC BY 4.0. I dettagli, insieme alle licenze dei componenti che la casa usa, sono in [Attribuzioni](10-attribuzioni.md).

**Emilio Destratis** · [destratis.it](https://destratis.it) · Progetto Arduino
