destone28/DomotiQ/docs/images/screens/en/rule-edit.png

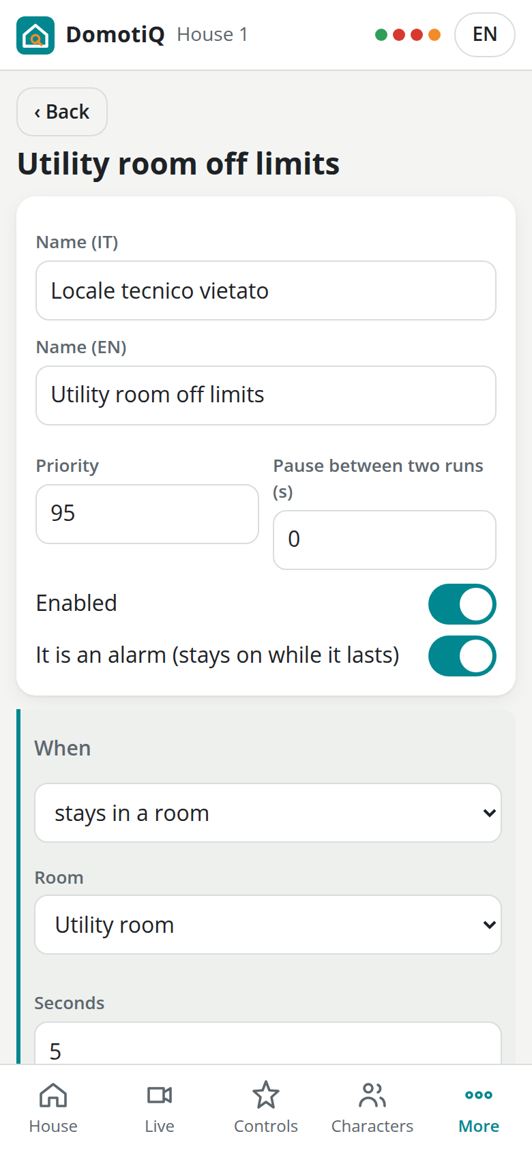
docs/images/screens/en/rule-edit.png
