destone28/DomotiQ/docs/images/screens/it/rule-edit.png

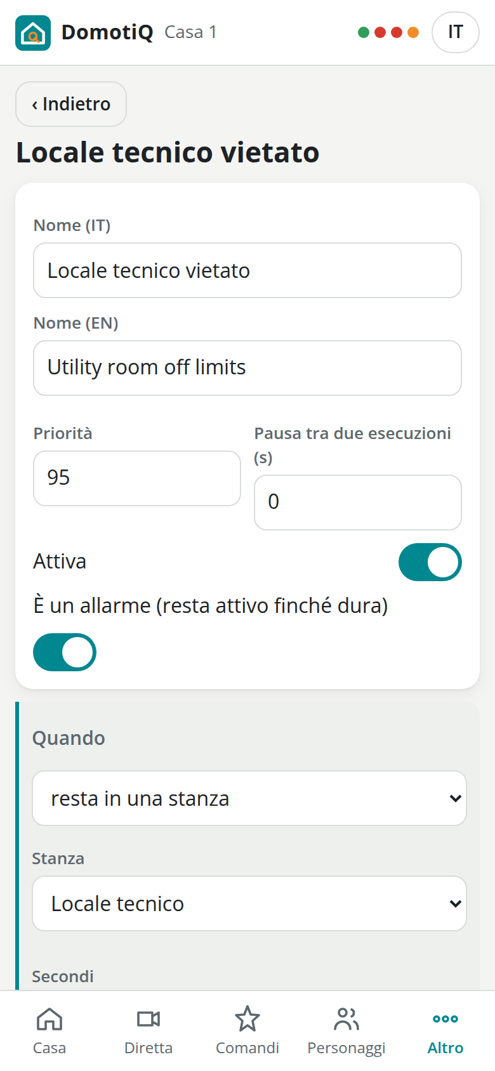
docs/images/screens/it/rule-edit.png
