destone28/DomotiQ/hardware/stl/07_Chiave_03.stl

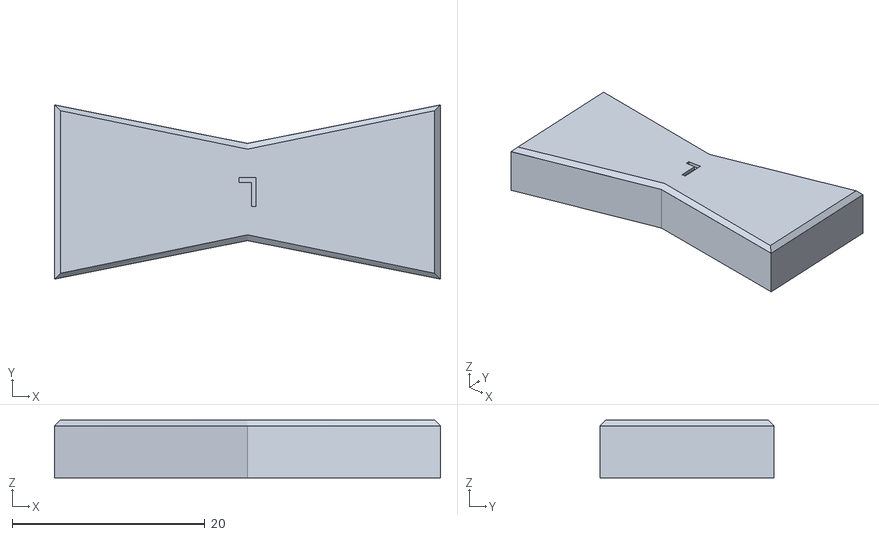
[picture p22: CAD file, 2026-10-05]
hardware/stl/07_Chiave_03.stl
40.1 x 18.1 x 6.00
