destone28/DomotiQ/hardware/stl/44_Fioriera_Cassa_Sx.stl

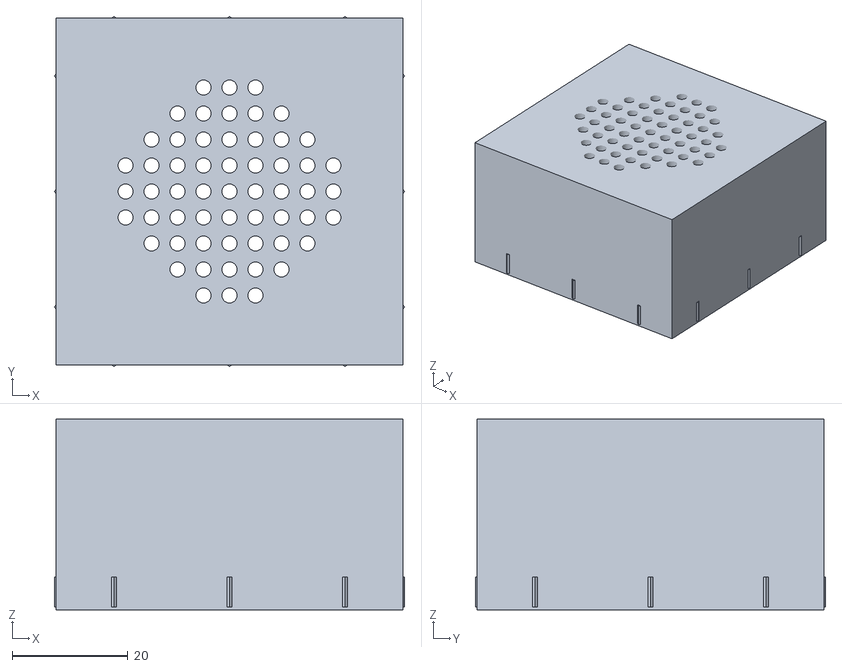
[picture p23: CAD file, 2026-10-05]
hardware/stl/44_Fioriera_Cassa_Sx.stl
60.6 x 60.6 x 33.0
