destone28/DomotiQ/hardware/stl/20_Palo_3.stl

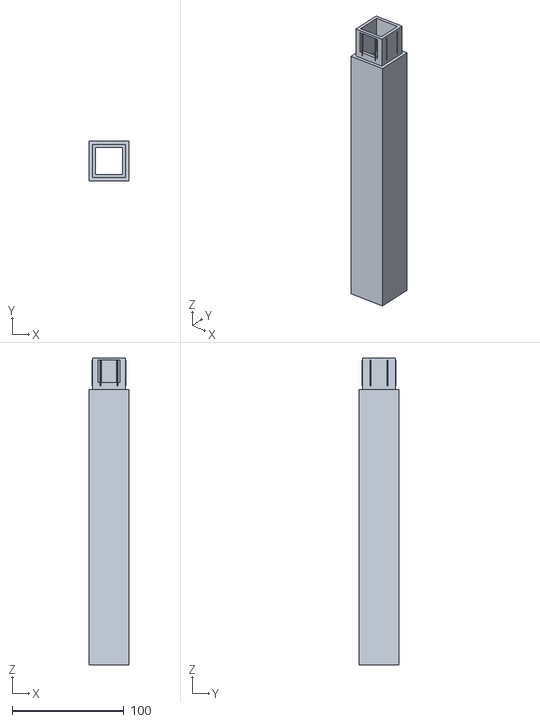
[picture p24: CAD file, 2026-10-05]
hardware/stl/20_Palo_3.stl
36.0 x 36.0 x 274.3
