destone28/DomotiQ/hardware/stl/26_Applique_Pixels_Cucina.stl

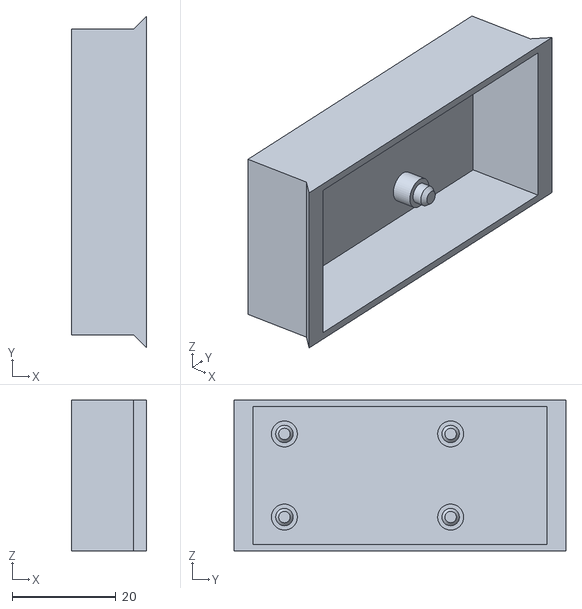
[picture p25: CAD file, 2026-10-05]
hardware/stl/26_Applique_Pixels_Cucina.stl
14.5 x 63.9 x 29.0
