destone28/DomotiQ/hardware/stl/50_Arredo_Cucina_Frigo.stl

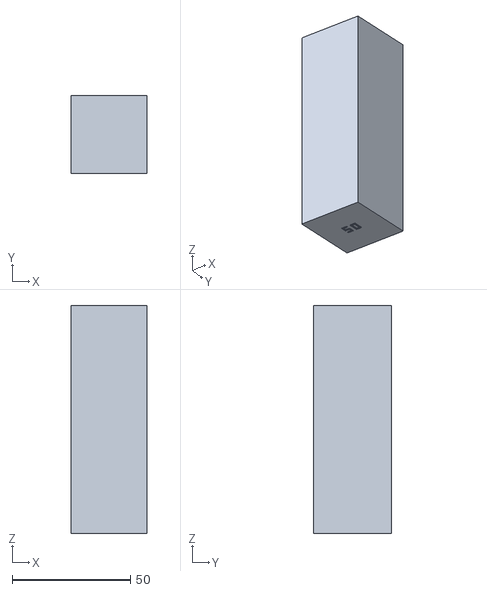
[picture p26: CAD file, 2026-10-05]
hardware/stl/50_Arredo_Cucina_Frigo.stl
32.0 x 33.0 x 96.5
