destone28/DomotiQ/hardware/stl/13_Parete_Bagno_Tecnico.stl

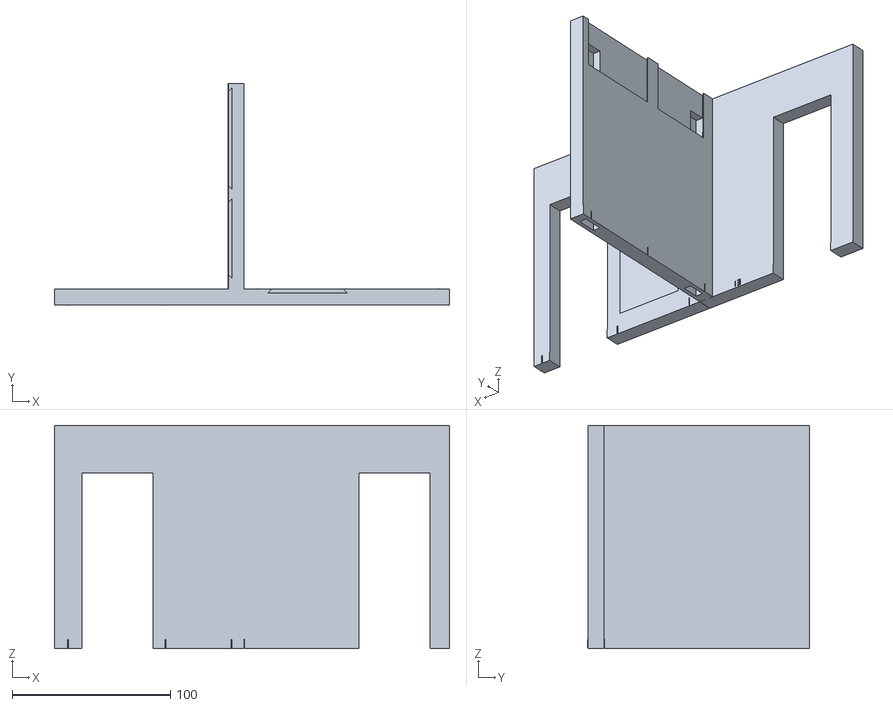
[picture p27: CAD file, 2026-10-05]
hardware/stl/13_Parete_Bagno_Tecnico.stl
249.5 x 140.1 x 141.0
