destone28/DomotiQ/hardware/stl/02_Pedana_A2.stl

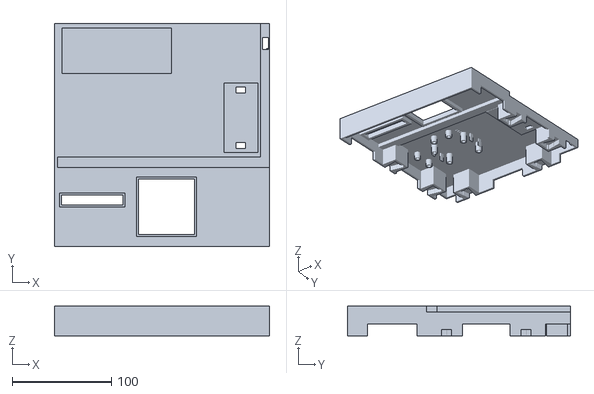
[picture p28: CAD file, 2026-10-05]
hardware/stl/02_Pedana_A2.stl
217.0 x 225.0 x 30.0
