destone28/DomotiQ/hardware/stl/41_Panca_Giardino_1.stl

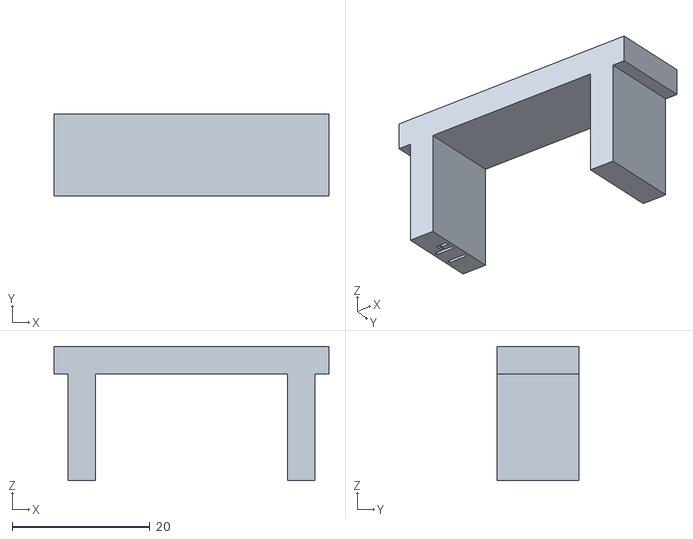
[picture p29: CAD file, 2026-10-05]
hardware/stl/41_Panca_Giardino_1.stl
40.0 x 12.0 x 19.5
