destone28/DomotiQ/hardware/stl/12_Parete_Camera.stl

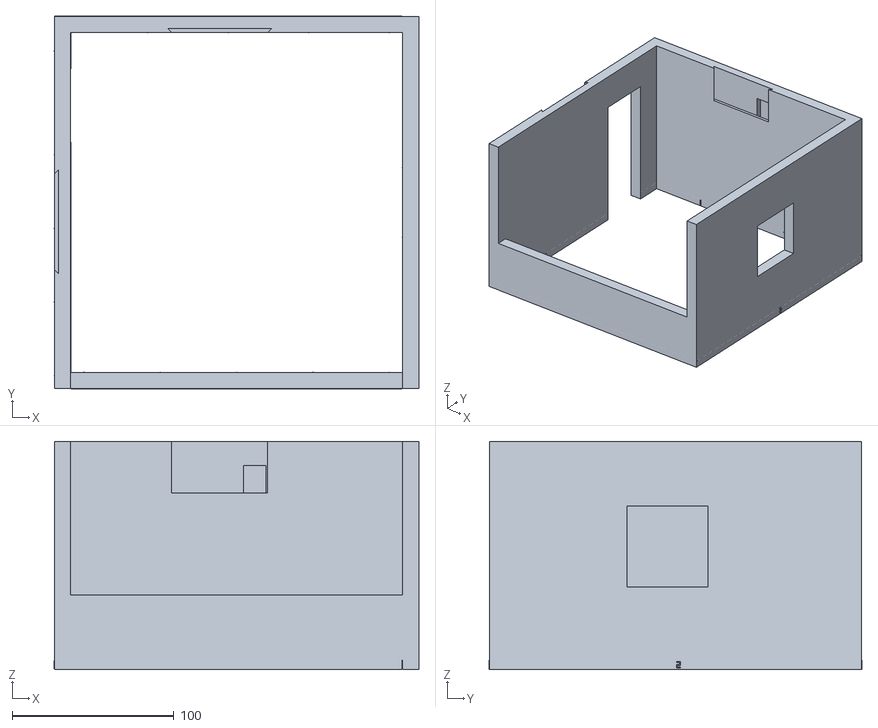
[picture p30: CAD file, 2026-10-05]
hardware/stl/12_Parete_Camera.stl
225.4 x 230.2 x 141.0
