destone28/DomotiQ/hardware/stl/39_Albero_Chioma.stl

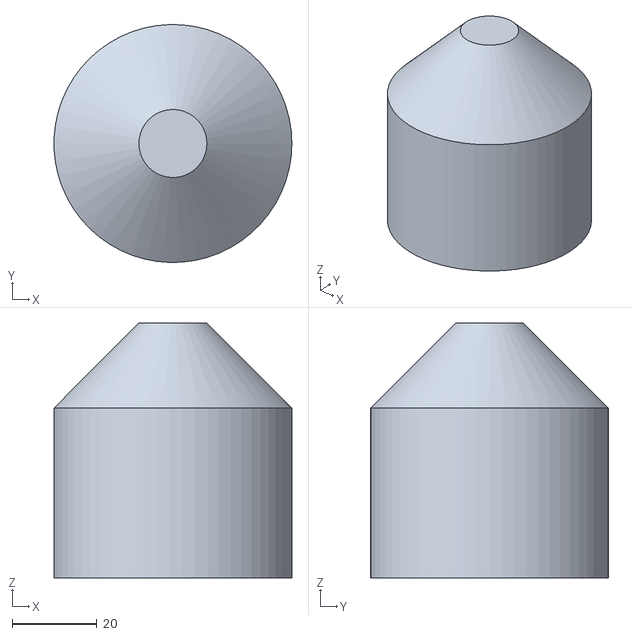
[picture p31: CAD file, 2026-10-05]
hardware/stl/39_Albero_Chioma.stl
56.0 x 56.0 x 60.0
