destone28/DomotiQ/hardware/stl/18_Palo_1.stl

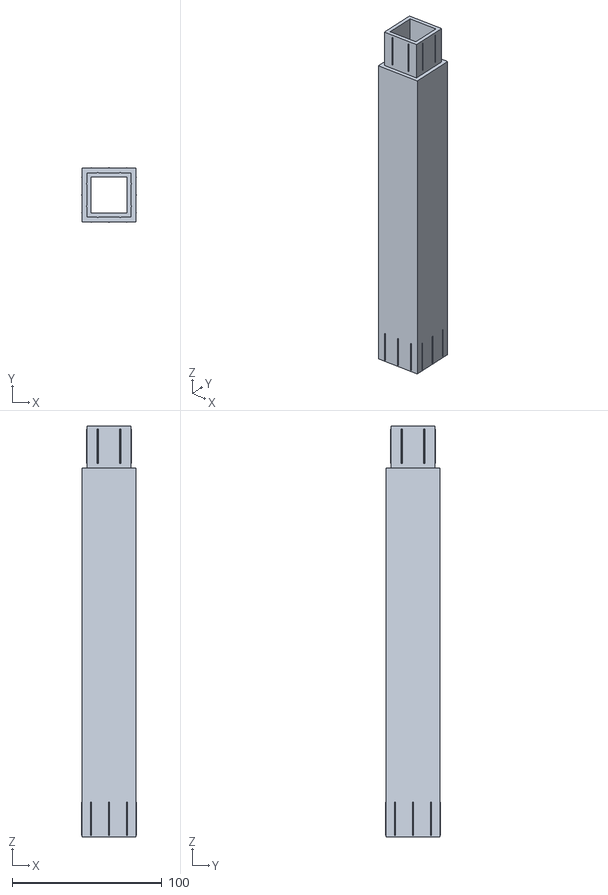
[picture p32: CAD file, 2026-10-05]
hardware/stl/18_Palo_1.stl
36.6 x 36.6 x 274.3
