destone28/DomotiQ/hardware/stl/54_Arredo_Mobile_TV.stl

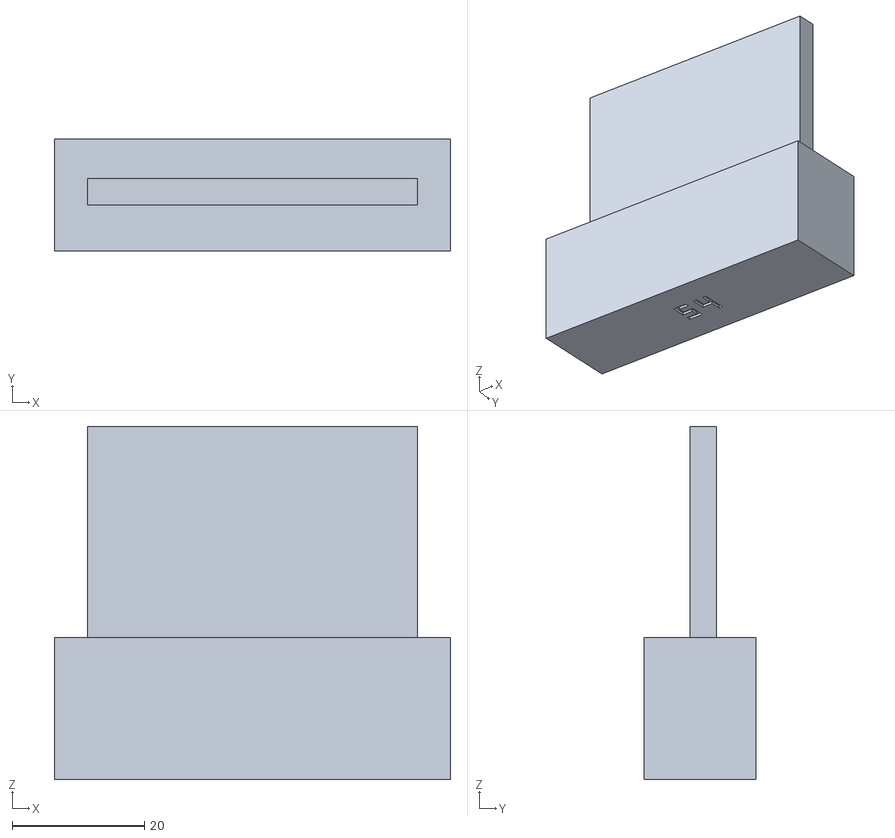
[picture p33: CAD file, 2026-10-05]
hardware/stl/54_Arredo_Mobile_TV.stl
60.0 x 17.0 x 53.5
