destone28/DomotiQ/hardware/stl/17_Parete_Fac_Soggiorno.stl

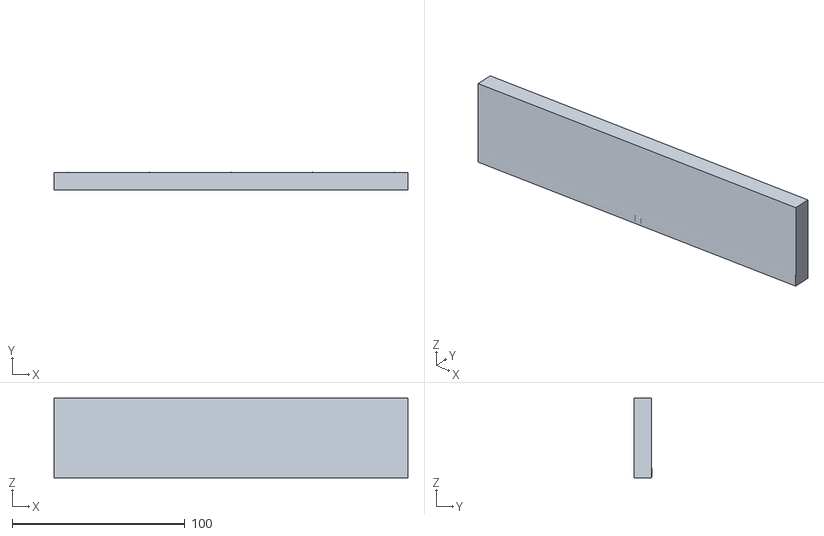
[picture p34: CAD file, 2026-10-05]
hardware/stl/17_Parete_Fac_Soggiorno.stl
204.8 x 10.4 x 46.0
