destone28/DomotiQ/hardware/stl/37_Griglia_Coperchio.stl

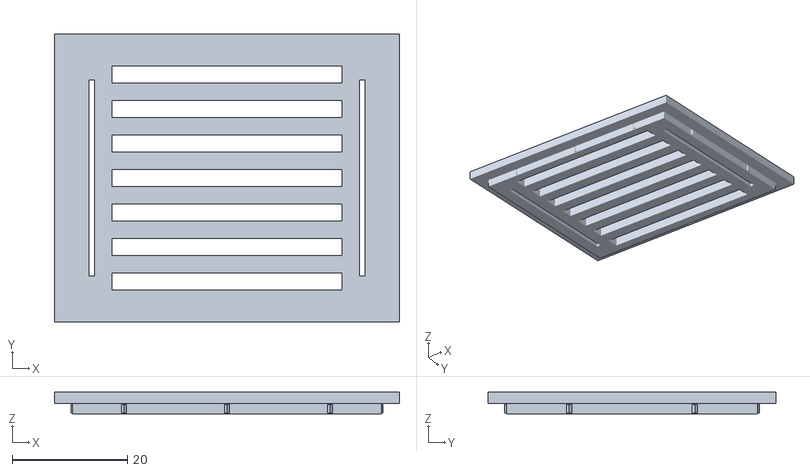
[picture p35: CAD file, 2026-10-05]
hardware/stl/37_Griglia_Coperchio.stl
60.0 x 50.0 x 3.80
