destone28/DomotiQ/hardware/stl/22_Fermo_Camera.stl

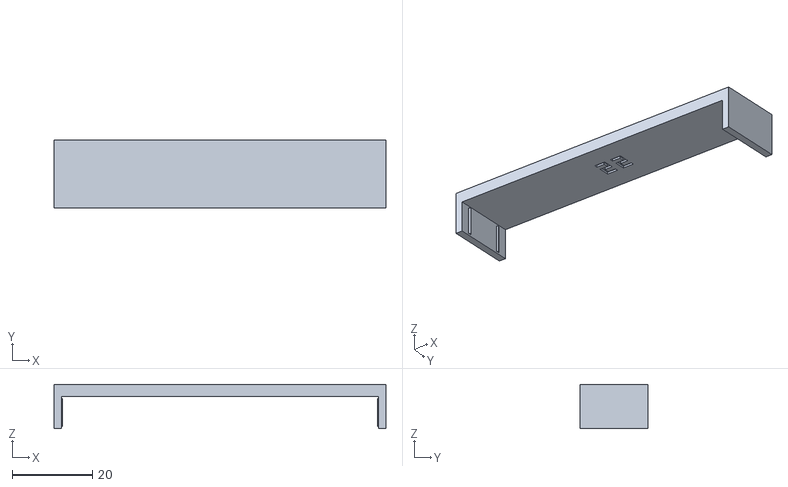
[picture p36: CAD file, 2026-10-05]
hardware/stl/22_Fermo_Camera.stl
82.6 x 16.8 x 11.0
