destone28/DomotiQ/hardware/stl/28_Totem_Scocca.stl

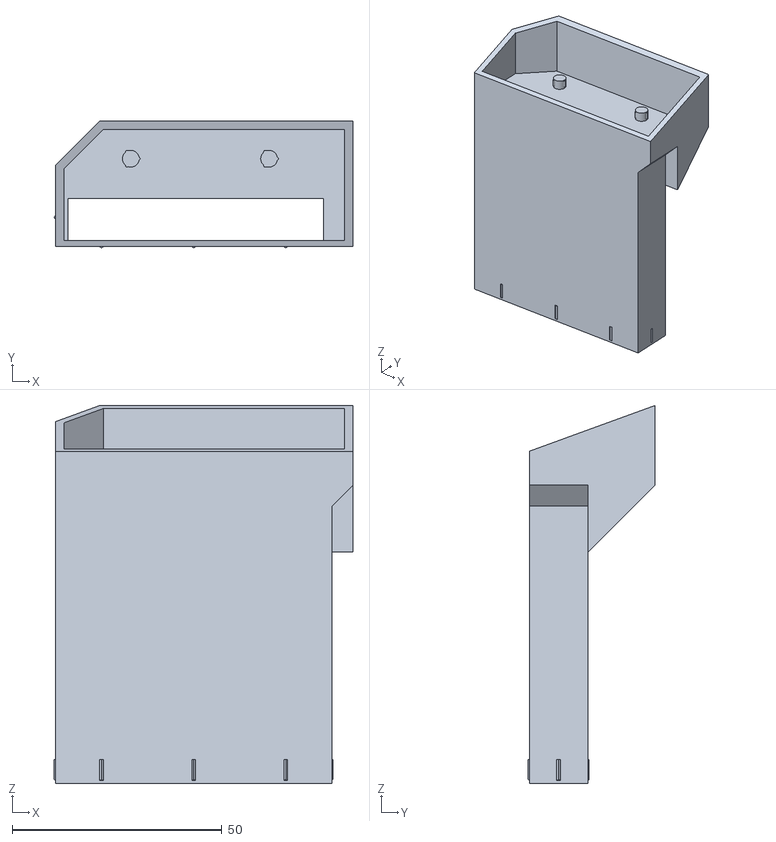
[picture p37: CAD file, 2026-10-05]
hardware/stl/28_Totem_Scocca.stl
71.3 x 30.3 x 90.2
