destone28/DomotiQ/hardware/stl/48_Prato_Vialetto_Dx.stl

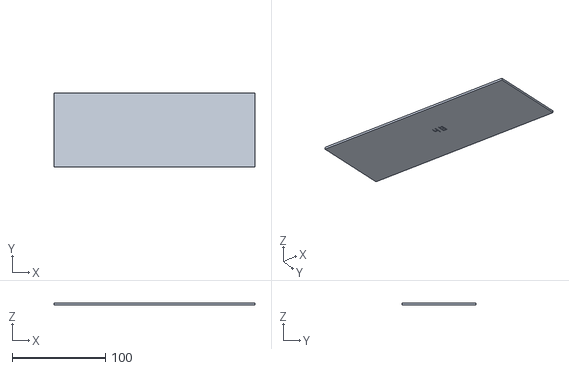
[picture p38: CAD file, 2026-10-05]
hardware/stl/48_Prato_Vialetto_Dx.stl
215.4 x 79.4 x 2.00
