destone28/DomotiQ/hardware/stl/31_Totem_Tasto_C.stl

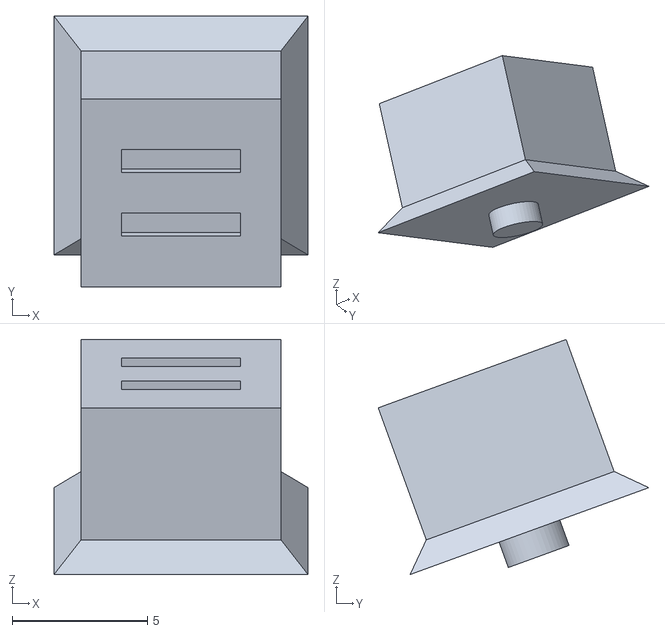
[picture p39: CAD file, 2026-10-05]
hardware/stl/31_Totem_Tasto_C.stl
9.40 x 10.0 x 8.70
