destone28/DomotiQ/hardware/stl/23_Placca_UNO_Q.stl

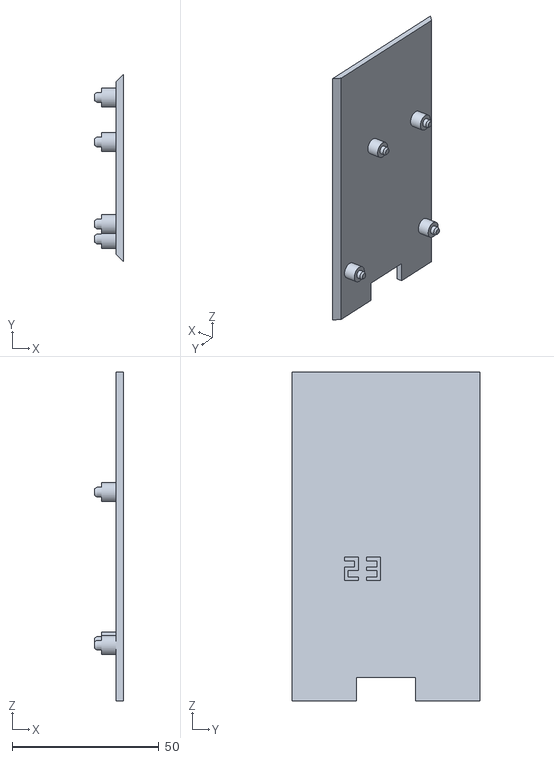
[picture p40: CAD file, 2026-10-05]
hardware/stl/23_Placca_UNO_Q.stl
9.90 x 64.0 x 112.0
