destone28/DomotiQ/hardware/stl/09_Staffa_Scheda_Audio_1.stl

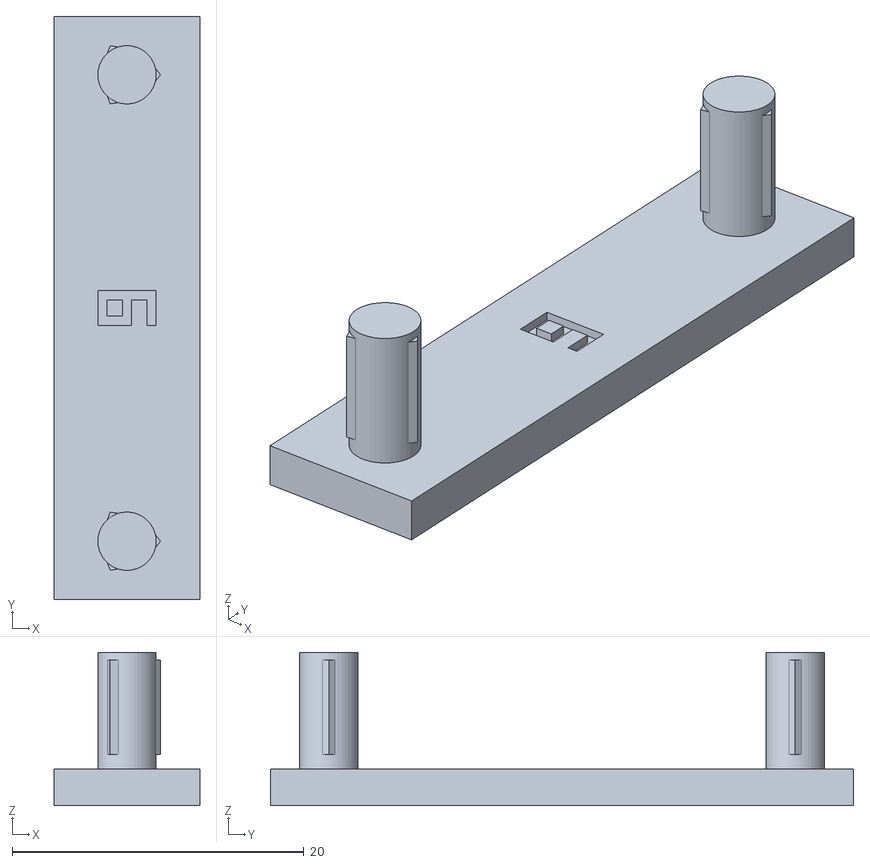
[picture p41: CAD file, 2026-10-05]
hardware/stl/09_Staffa_Scheda_Audio_1.stl
10.0 x 40.0 x 10.5
