destone28/DomotiQ/hardware/stl/46_Prato_Vialetto_Sx.stl

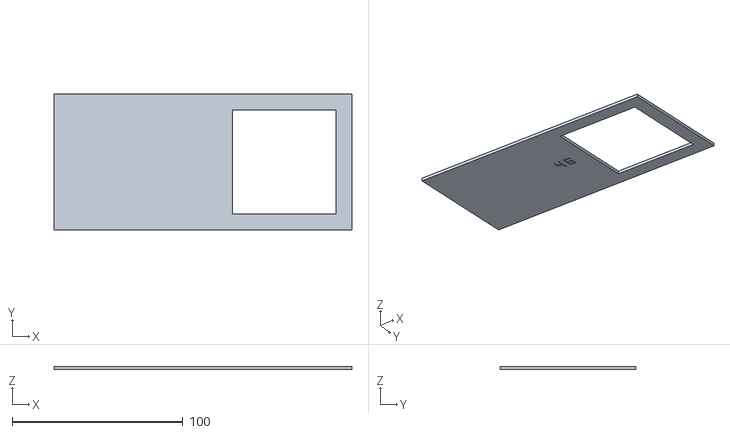
[picture p42: CAD file, 2026-10-05]
hardware/stl/46_Prato_Vialetto_Sx.stl
174.4 x 79.4 x 2.00
