destone28/DomotiQ/hardware/stl/49_Arredo_Cucina_Bancone.stl

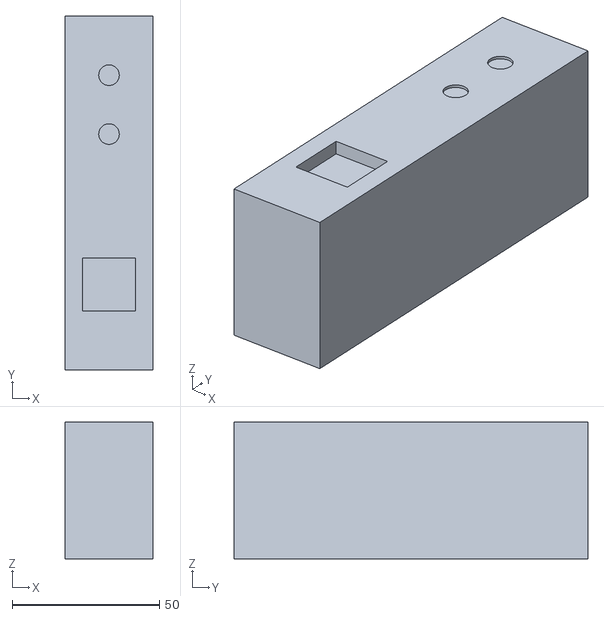
[picture p43: CAD file, 2026-10-05]
hardware/stl/49_Arredo_Cucina_Bancone.stl
30.0 x 120.0 x 46.5
