destone28/DomotiQ/hardware/stl/21_Braccio_Camera.stl

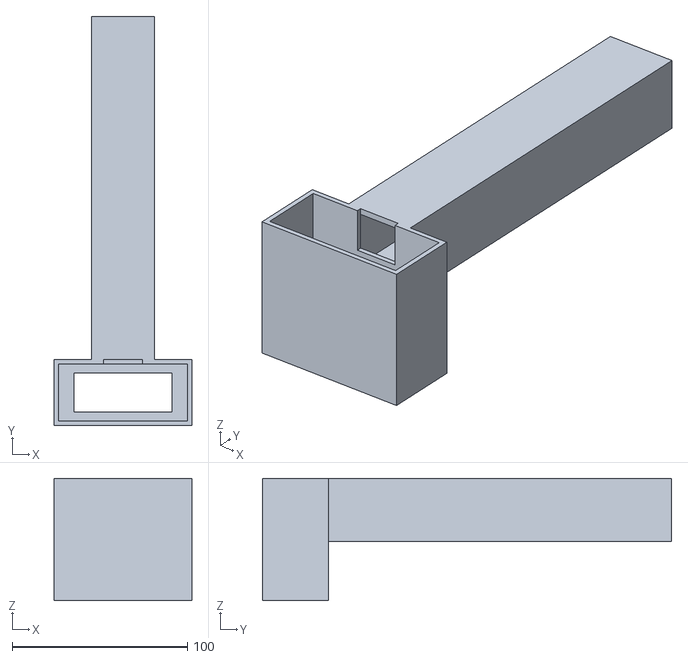
[picture p44: CAD file, 2026-10-05]
hardware/stl/21_Braccio_Camera.stl
78.6 x 233.3 x 69.7
