destone28/DomotiQ/hardware/stl/33_Credenza_Termostato.stl

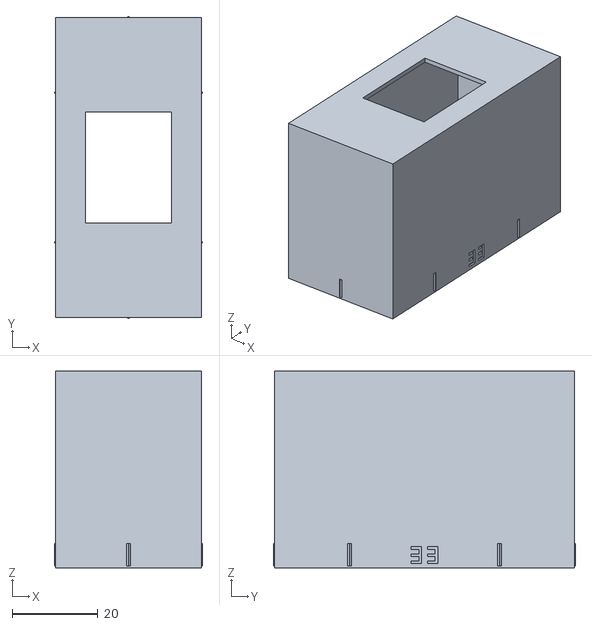
[picture p45: CAD file, 2026-10-05]
hardware/stl/33_Credenza_Termostato.stl
34.6 x 70.6 x 46.0
