destone28/DomotiQ/hardware/stl/47_Prato_Vialetto_Centro.stl

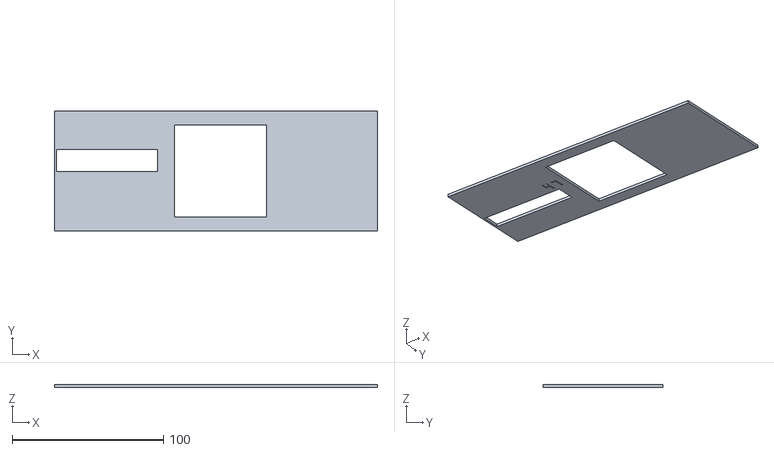
[picture p46: CAD file, 2026-10-05]
hardware/stl/47_Prato_Vialetto_Centro.stl
213.4 x 79.4 x 2.00
