destone28/DomotiQ/hardware/stl/56_Arredo_Comodino_Dx.stl

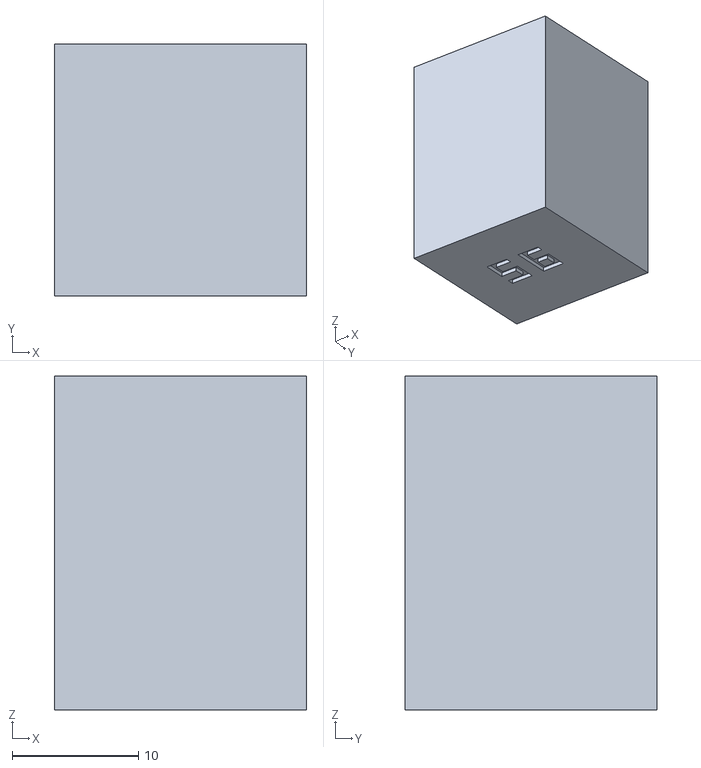
[picture p47: CAD file, 2026-10-05]
hardware/stl/56_Arredo_Comodino_Dx.stl
20.0 x 20.0 x 26.5
