destone28/DomotiQ/hardware/stl/42_Staccionata_Sx.stl

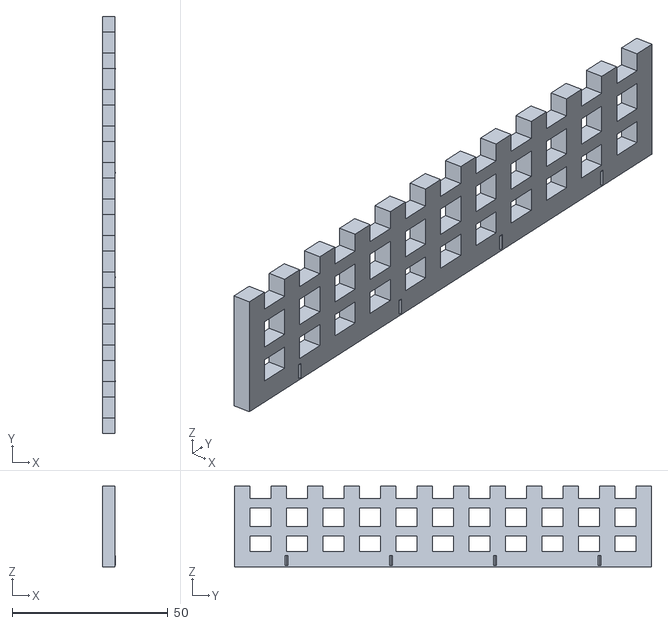
[picture p48: CAD file, 2026-10-05]
hardware/stl/42_Staccionata_Sx.stl
4.30 x 134.0 x 26.0
