destone28/DomotiQ/hardware/stl/51_Arredo_Cucina_Tavolo.stl

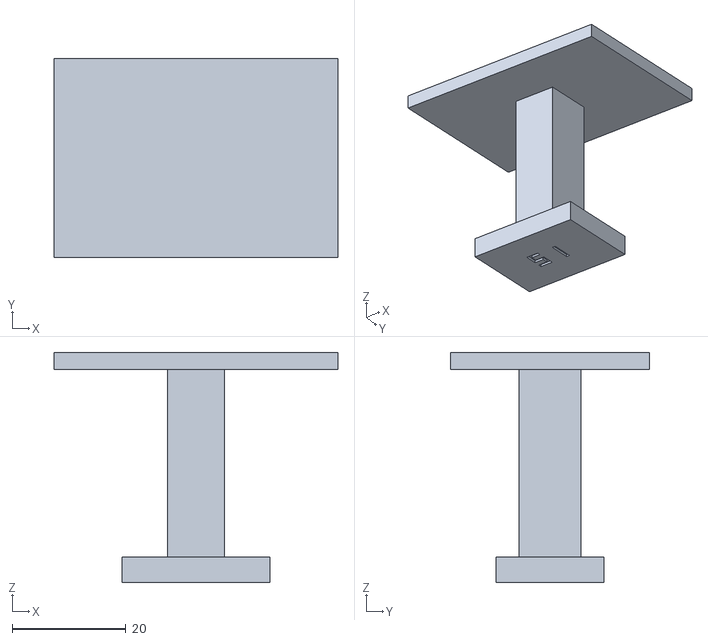
[picture p49: CAD file, 2026-10-05]
hardware/stl/51_Arredo_Cucina_Tavolo.stl
50.0 x 35.0 x 40.5
