destone28/DomotiQ/hardware/stl/35_Griglia_Barbecue.stl

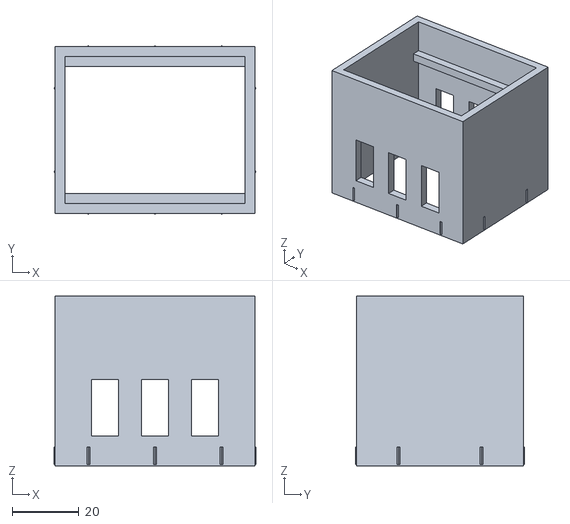
[picture p50: CAD file, 2026-10-05]
hardware/stl/35_Griglia_Barbecue.stl
60.6 x 50.6 x 51.0
