destone28/DomotiQ/hardware/stl/10_Fermacavo_1.stl

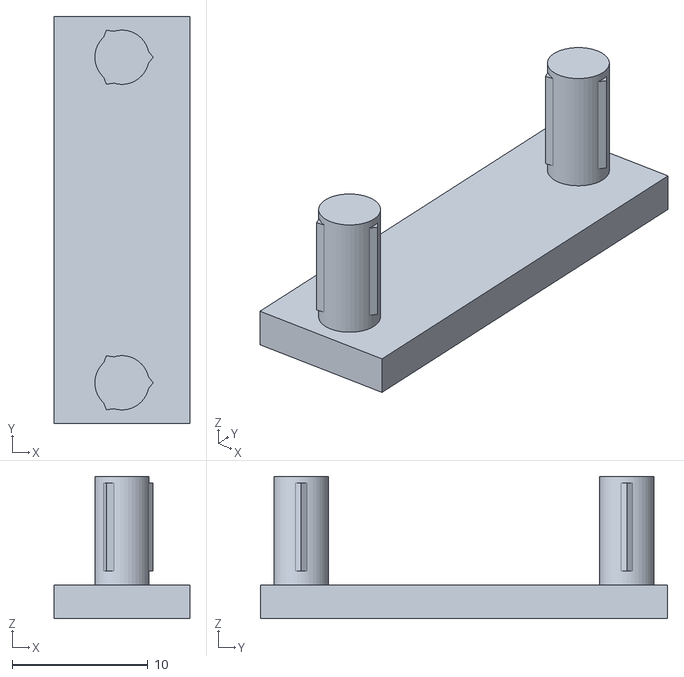
[picture p51: CAD file, 2026-10-05]
hardware/stl/10_Fermacavo_1.stl
10.0 x 30.0 x 10.5
