destone28/DomotiQ/hardware/stl/14_Parete_Bagno.stl

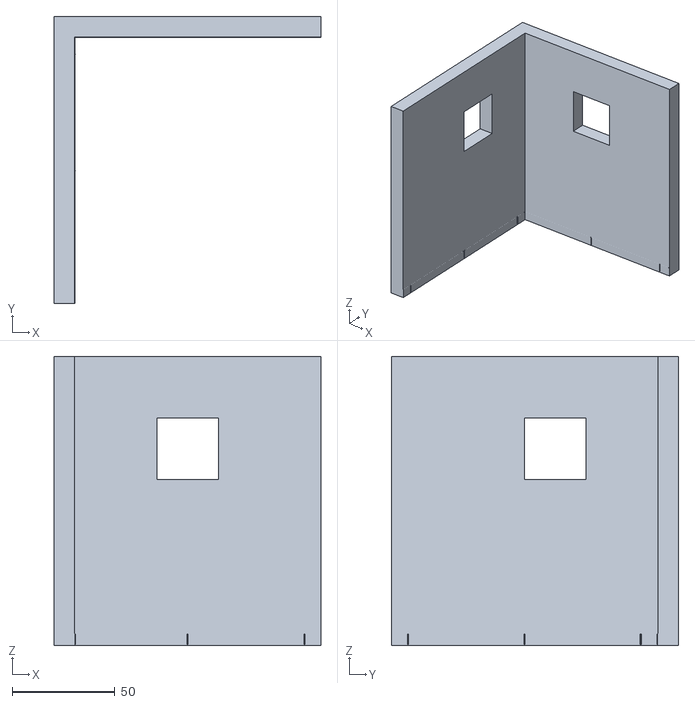
[picture p52: CAD file, 2026-10-05]
hardware/stl/14_Parete_Bagno.stl
130.1 x 139.9 x 141.0
