destone28/DomotiQ/hardware/stl/53_Arredo_Tavolino.stl

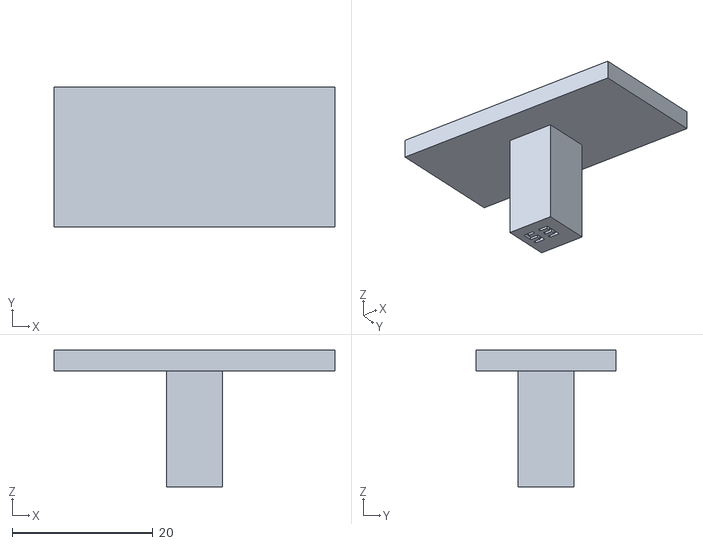
[picture p53: CAD file, 2026-10-05]
hardware/stl/53_Arredo_Tavolino.stl
40.0 x 20.0 x 19.5
