destone28/DomotiQ/hardware/stl/55_Arredo_Letto.stl

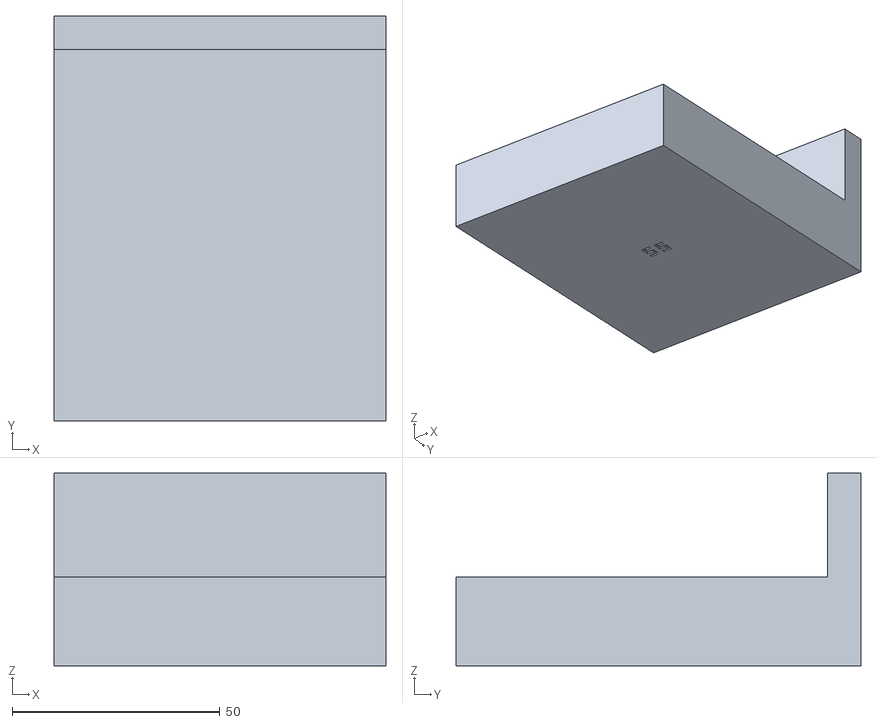
[picture p54: CAD file, 2026-10-05]
hardware/stl/55_Arredo_Letto.stl
80.0 x 97.5 x 46.5
