destone28/DomotiQ/hardware/stl/24_Placca_Relay.stl

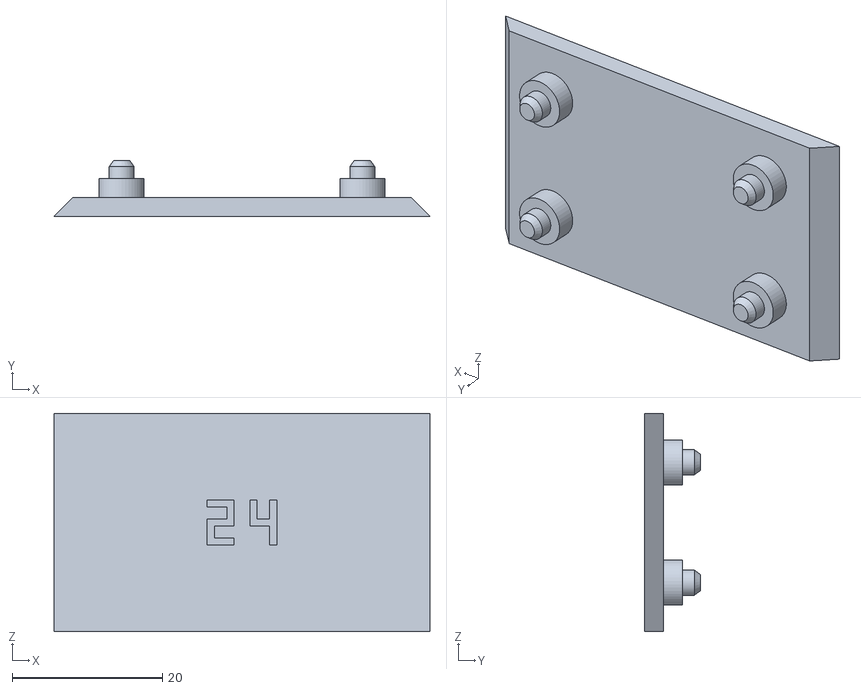
[picture p55: CAD file, 2026-10-05]
hardware/stl/24_Placca_Relay.stl
50.0 x 7.40 x 29.0
