destone28/DomotiQ/hardware/stl/11_Parete_Cucina.stl

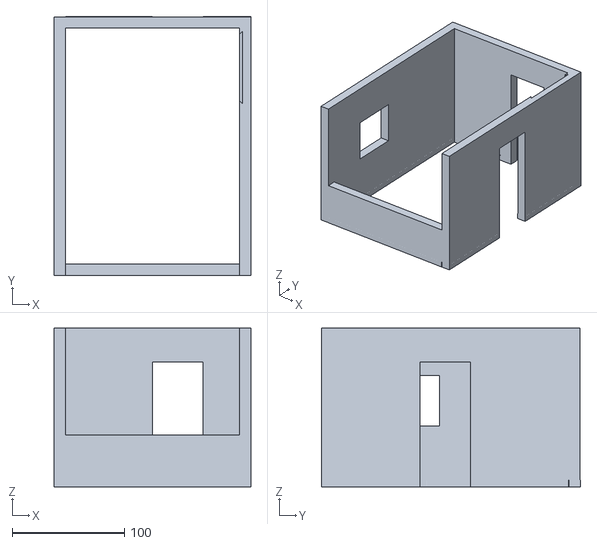
[picture p56: CAD file, 2026-10-05]
hardware/stl/11_Parete_Cucina.stl
175.2 x 230.4 x 141.0
