destone28/DomotiQ/hardware/stl/59_Arredo_Bagno_Doccia.stl

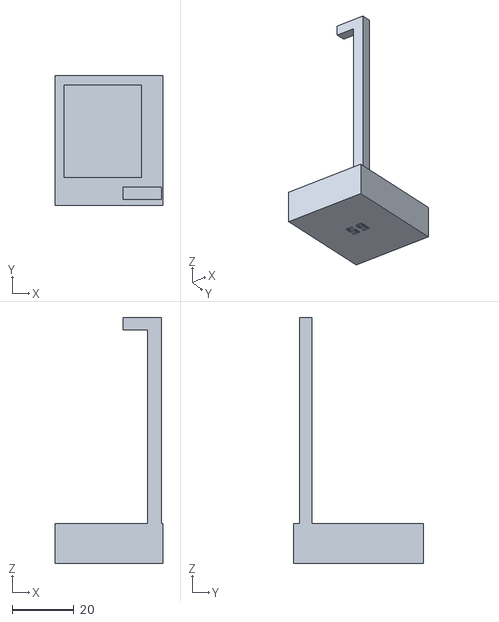
[picture p57: CAD file, 2026-10-05]
hardware/stl/59_Arredo_Bagno_Doccia.stl
35.0 x 42.0 x 79.5
