destone28/DomotiQ/hardware/stl/58_Arredo_Bagno_Lavabo.stl

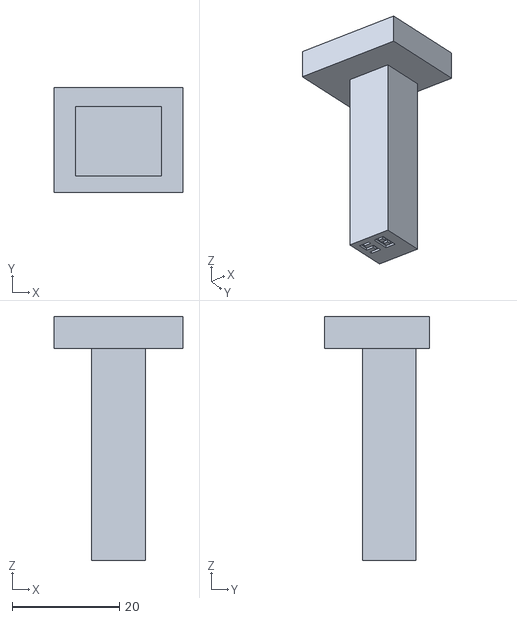
[picture p58: CAD file, 2026-10-05]
hardware/stl/58_Arredo_Bagno_Lavabo.stl
24.0 x 19.5 x 45.5
