destone28/DomotiQ/hardware/stl/19_Collare_Palo.stl

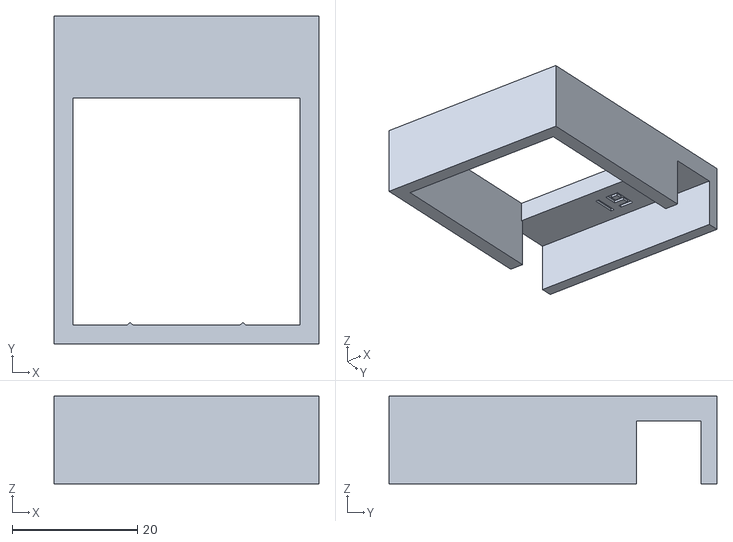
[picture p59: CAD file, 2026-10-05]
hardware/stl/19_Collare_Palo.stl
42.3 x 52.3 x 14.0
