destone28/DomotiQ/hardware/stl/16_Parete_Garage.stl

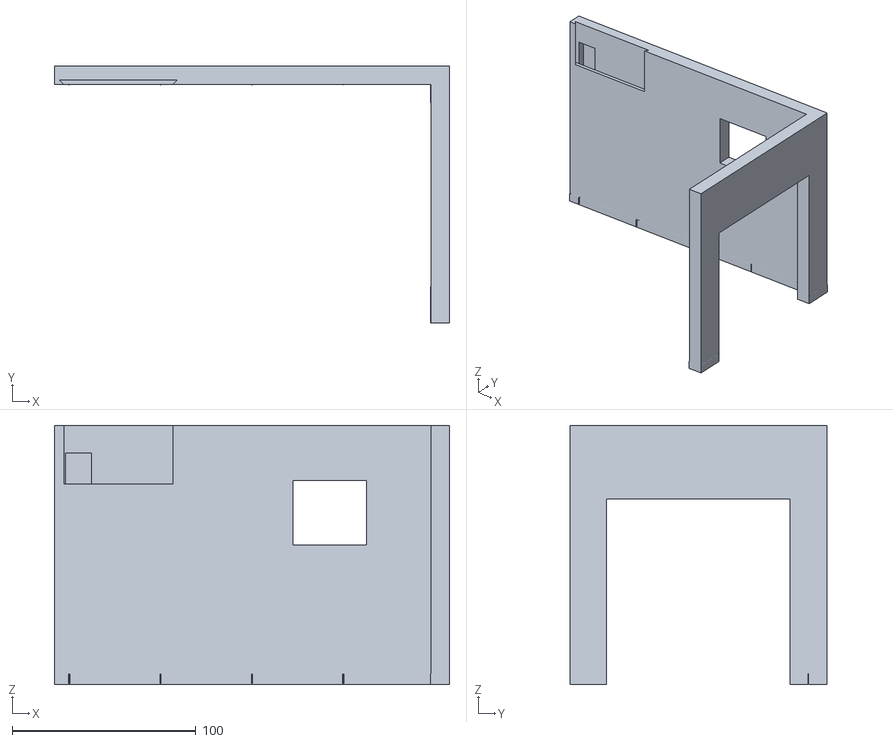
[picture p60: CAD file, 2026-10-05]
hardware/stl/16_Parete_Garage.stl
214.8 x 139.9 x 141.0
