destone28/DomotiQ/hardware/stl/57_Arredo_Bagno_WC.stl

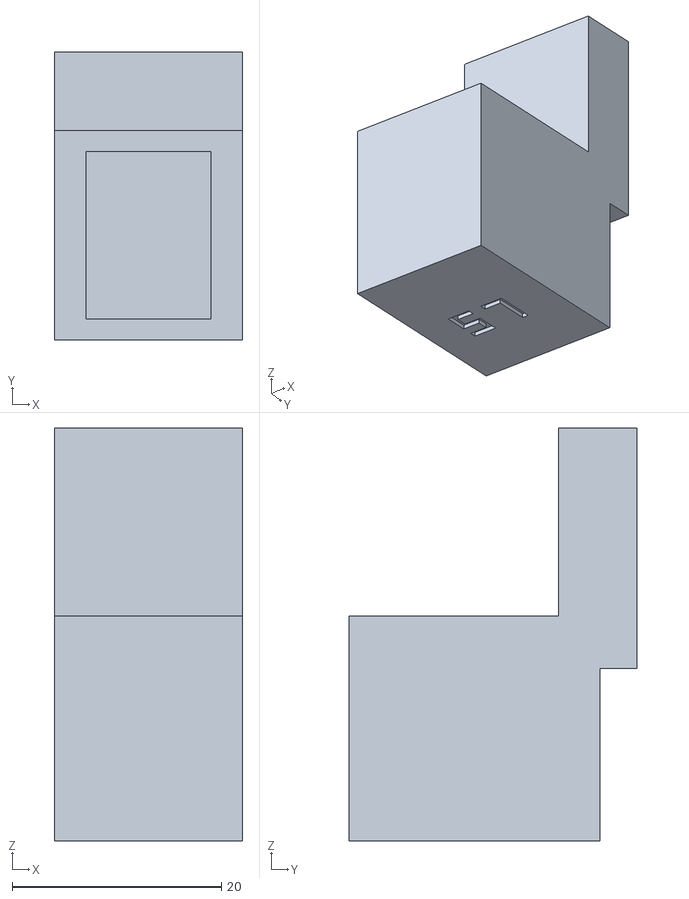
[picture p61: CAD file, 2026-10-05]
hardware/stl/57_Arredo_Bagno_WC.stl
18.0 x 27.5 x 39.5
