destone28/DomotiQ/hardware/stl/32_Totem_Coperchio_Cappucci.stl

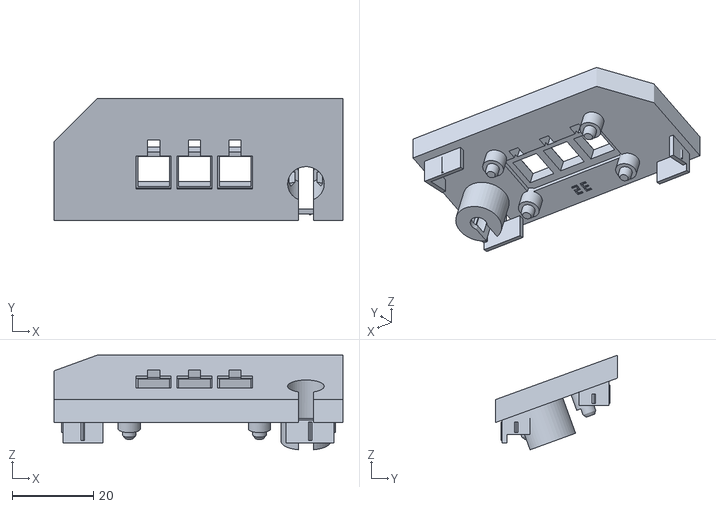
[picture p62: CAD file, 2026-10-05]
hardware/stl/32_Totem_Coperchio_Cappucci.stl
71.0 x 30.0 x 23.3
