destone28/DomotiQ/hardware/stl/38_Albero_Tronco.stl

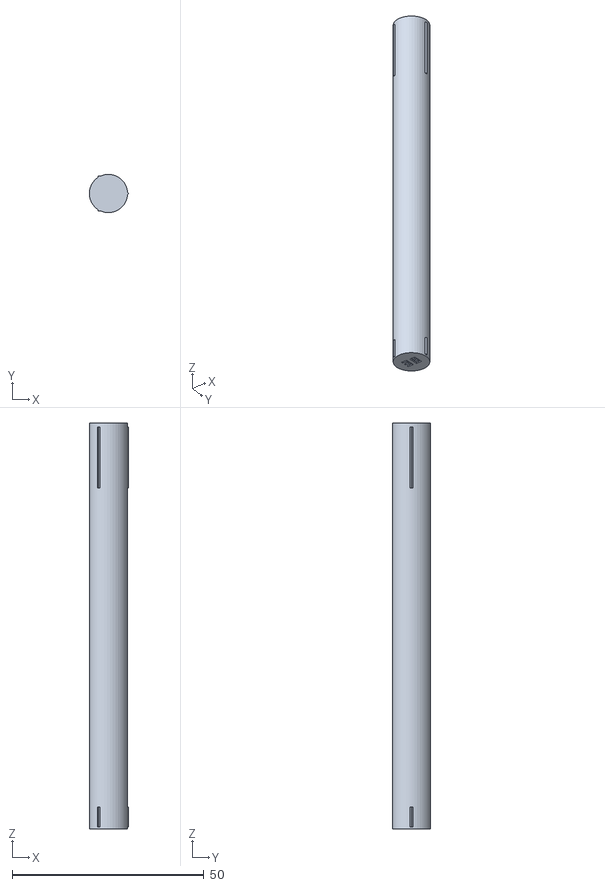
[picture p63: CAD file, 2026-10-05]
hardware/stl/38_Albero_Tronco.stl
10.3 x 9.97 x 106.0
