destone28/DomotiQ/hardware/stl/45_Prato_Giardino.stl

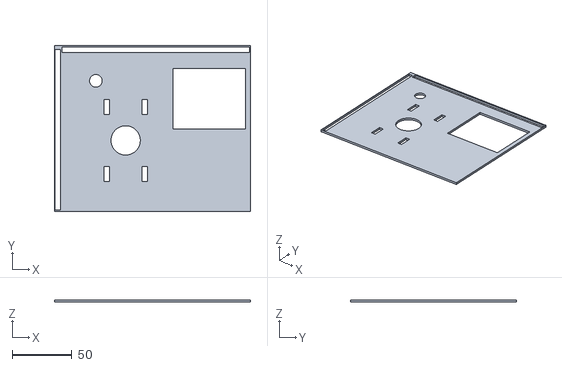
[picture p64: CAD file, 2026-10-05]
hardware/stl/45_Prato_Giardino.stl
164.4 x 139.4 x 2.00
