destone28/DomotiQ/hardware/stl/52_Arredo_Divano.stl

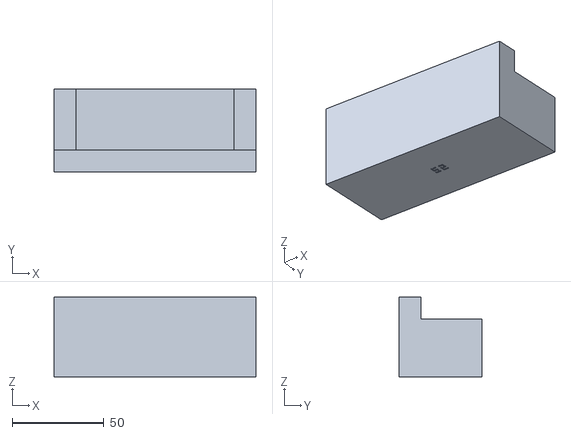
[picture p65: CAD file, 2026-10-05]
hardware/stl/52_Arredo_Divano.stl
110.0 x 45.0 x 43.5
