destone28/DomotiQ/hardware/stl/34_Placca_Termostato.stl

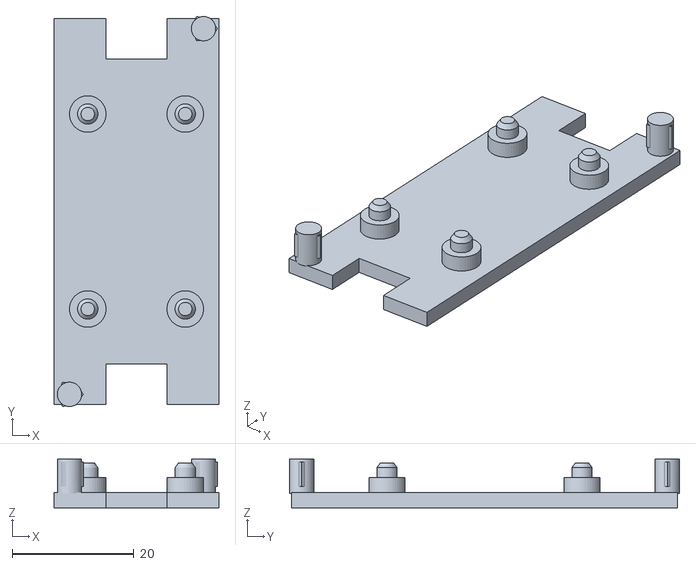
[picture p66: CAD file, 2026-10-05]
hardware/stl/34_Placca_Termostato.stl
27.0 x 64.0 x 8.00
