destone28/DomotiQ/hardware/stl/36_Basetta_Barbecue.stl

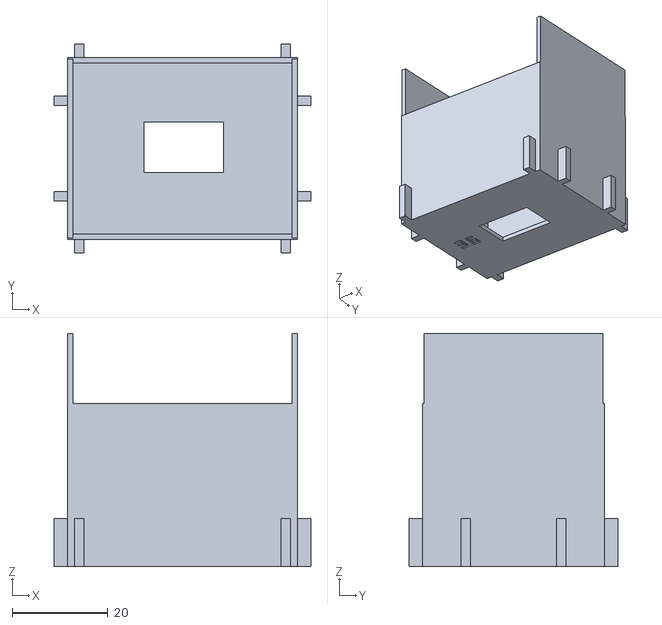
[picture p67: CAD file, 2026-10-05]
hardware/stl/36_Basetta_Barbecue.stl
53.6 x 43.6 x 48.6
