destone28/DomotiQ/hardware/stl/25_Placca_Thermo_Bagno.stl

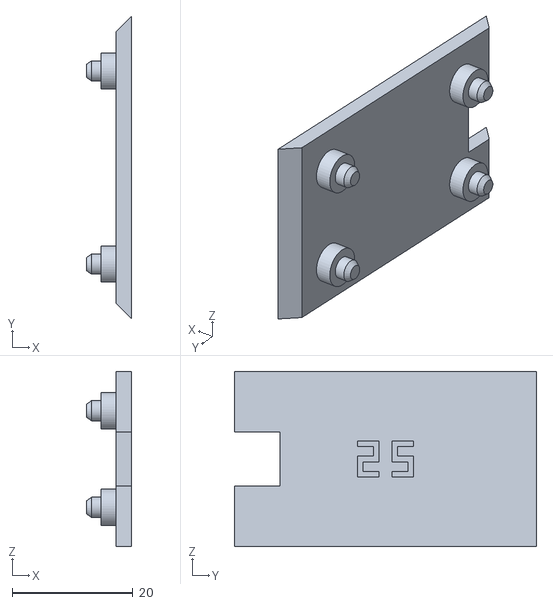
[picture p68: CAD file, 2026-10-05]
hardware/stl/25_Placca_Thermo_Bagno.stl
7.40 x 50.0 x 29.0
