destone28/DomotiQ/hardware/stl/40_Tavolo_Giardino.stl

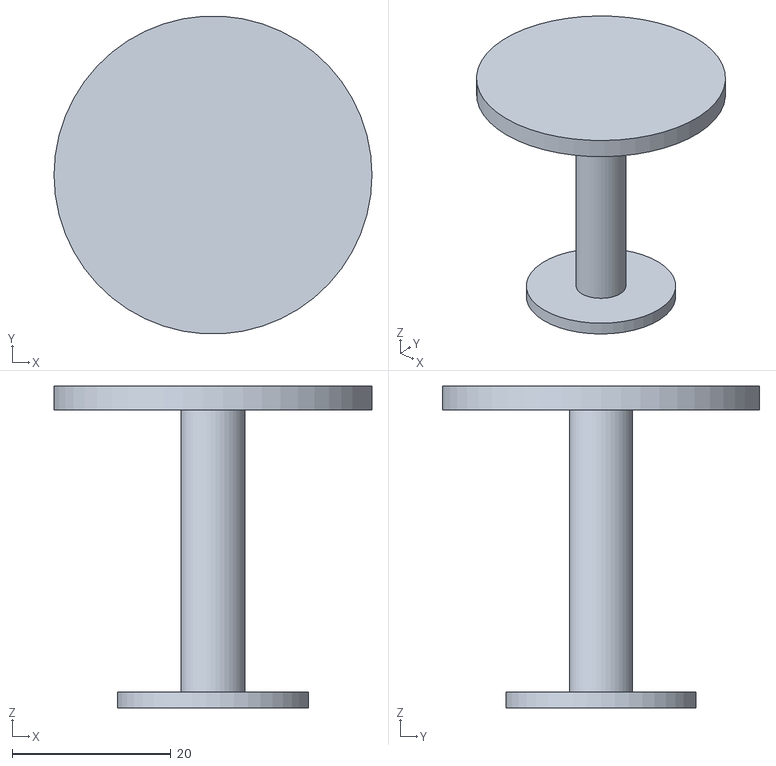
[picture p69: CAD file, 2026-10-05]
hardware/stl/40_Tavolo_Giardino.stl
40.0 x 39.9 x 40.5
