destone28/DomotiQ/hardware/stl/43_Staccionata_Retro.stl

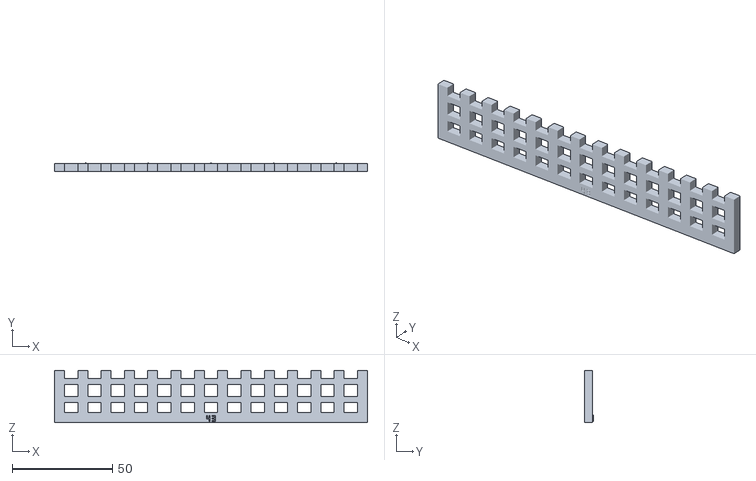
[picture p70: CAD file, 2026-10-05]
hardware/stl/43_Staccionata_Retro.stl
156.5 x 4.30 x 26.0
