destone28/DomotiQ/hardware/stl/15_Parete_Tecnico.stl

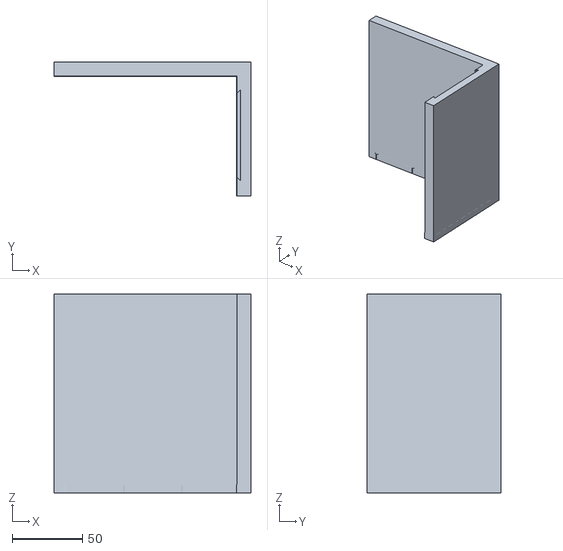
[picture p71: CAD file, 2026-10-05]
hardware/stl/15_Parete_Tecnico.stl
139.9 x 95.1 x 141.0
