destone28/DomotiQ/hardware/stl/04_Pedana_B1.stl

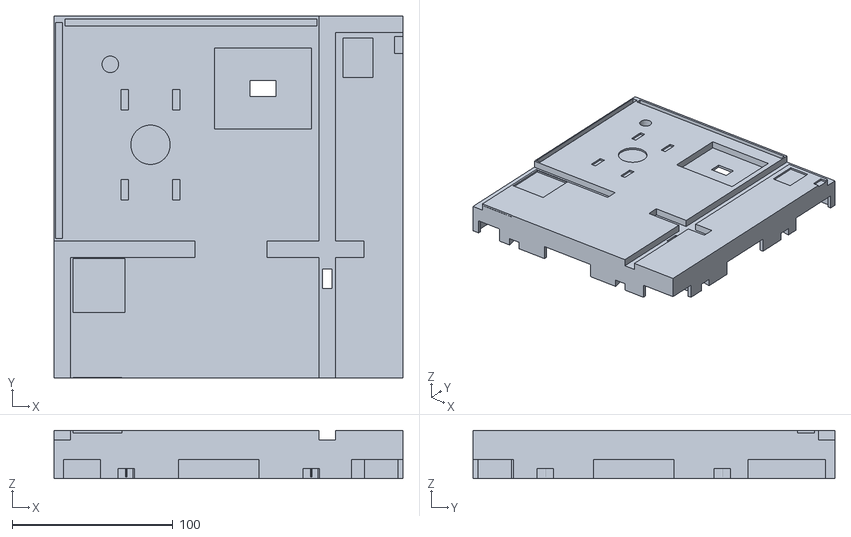
[picture p72: CAD file, 2026-09-28]
hardware/stl/04_Pedana_B1.stl
217.0 x 225.0 x 30.0
