destone28/DomotiQ/hardware/stl/08_Staffa_Revodok_2.stl

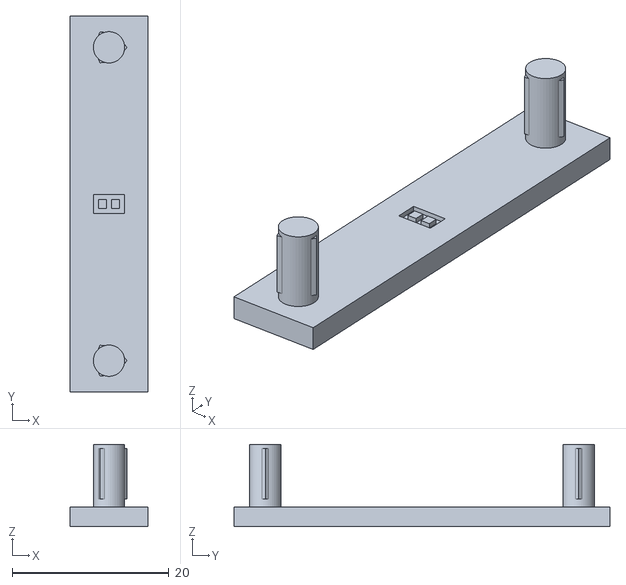
[picture p73: CAD file, 2026-09-28]
hardware/stl/08_Staffa_Revodok_2.stl
10.0 x 48.0 x 10.5
