destone28/DomotiQ/(list of files, cad)

Other CAD files:
hardware/stl/07_Chiave_02.stl
hardware/stl/20_Palo_4.stl
hardware/stl/07_Chiave_09.stl
hardware/stl/01_Pedana_A1.stl
hardware/stl/07_Chiave_04.stl
hardware/stl/27_Applique_Pixels_Garage.stl
hardware/stl/41_Panca_Giardino_2.stl
hardware/stl/44_Fioriera_Cassa_Dx.stl
hardware/stl/26_Applique_Pixels_Soggiorno.stl
hardware/stl/07_Chiave_13.stl
hardware/stl/07_Chiave_06.stl
hardware/stl/26_Applique_Pixels_Camera.stl
hardware/stl/07_Chiave_14.stl
hardware/stl/07_Chiave_07.stl
hardware/stl/07_Chiave_10.stl
hardware/stl/20_Palo_2.stl
hardware/stl/07_Chiave_05.stl
hardware/stl/24_Placca_Hub.stl
hardware/stl/26_Applique_Pixels_Bagno.stl
hardware/stl/29_Totem_Tasto_A.stl
hardware/stl/10_Fermacavo_2.stl
hardware/stl/09_Staffa_Scheda_Audio_2.stl
hardware/stl/56_Arredo_Comodino_Sx.stl
hardware/stl/07_Chiave_11.stl
hardware/stl/07_Chiave_01.stl
hardware/stl/30_Totem_Tasto_B.stl
hardware/stl/07_Chiave_12.stl
hardware/stl/07_Chiave_08.stl
hardware/stl/03_Pedana_A3.stl
hardware/stl/06_Pedana_B3.stl
hardware/stl/05_Pedana_B2.stl
hardware/stl/08_Staffa_Revodok_1.stl
