destone28/DomotiQ/docs/en/05-testing.md

# 5. Testing and commissioning

Go through this chapter after assembly and wiring, and again every time the house moves to another place. Each step says what to do and what you should see. When something does not match, the [troubleshooting](11-troubleshooting.md) chapter has the likely causes.

You need a phone or PC connected to the same network as the board: your Wi-Fi network (`http://casa1.local/`) or the hotspot of the house (`http://10.42.1.1/`).

## 1. Power on

Switch on the power supply. What happens:

1. The microcontroller starts at once: relay off, lights off, then a dim **breathing** light in every room while Linux boots (about 40 seconds).
2. When the application is up, it takes over the lights: with nobody in the house they go off.

Check the services from an SSH session:

```bash
systemctl status domotiq domotiq-tts domotiq-llm --no-pager
journalctl -u domotiq -f
```

## 2. Open the web app

Open the address of the house in a browser. At the top right, next to the house name, three dots show the state of the **Microcontroller**, the **Webcam** and the **Audio** (green = working). Every page is open to anybody: **Calibration**, **Diagnostics** and **Settings** are in **More → Setting up**.

## 3. Microcontroller and modules

Open **More → Diagnostics**.

- The **Modulino** card shows a green dot and `v1`, the protocol version of the firmware. A red dot means Linux cannot talk to the microcontroller.
- Below it, *I2C bus free* says that the two lines of the bus are fine (otherwise it shows which line is stuck: see [troubleshooting](11-troubleshooting.md#every-module-is-red-and-the-alert-the-modulino-bus-is-stuck-is-shown)), and every module has a green or red dot: Hub, Latch Relay, the five Pixels (garage, bedroom, kitchen, living room, bathroom), the two Thermo (bathroom, sideboard) and Buttons.
- **I2C scan** lists the addresses that answer. The first line, *main bus*, shows what sits before the Hub: the Latch Relay (0x02, 0x15 or 0x10) and the Hub itself (between 0x70 and 0x77). The channel lines show only what is behind each Hub channel, and you should see:

  | Channel | Expected |
  |---|---|
  | ch0, ch1, ch2, ch3, ch5 | 0x36 (Pixels) |
  | ch4 | 0x44 (Thermo) |
  | ch6 | 0x44, 0x3e (Thermo, Buttons) |
  | ch7 | nothing |

## 4. Lights

In **Controls → Lights**, choose a room and tap a colour: the light turns on at once. Repeat for all six rooms (in the utility room the light is the LED matrix of the UNO Q, with the colour on the RGB LED next to it), then choose *All rooms* and tap **A** to give the lights back to the house. A light turned on by hand stays on for two minutes; the crossed circle keeps a room dark for one minute.

## 5. Buttons and LEDs

- **Language**: all lights flash green (Italian) or red (English) for about a second, the house says "Italiano" or "English", and the LED of the Language button is on while the house speaks English. Press it again to go back to Italian.
- **Talk**: hold it. A beep, the three LEDs light up while the house listens, another beep when you release it; while the house works out its answer the LEDs breathe.
- **Intercom**: a doorbell rings and the house asks "Chi è?" / "Who is it?"; its LED blinks during the conversation. Say nothing twice and the house lets you in as a guest.

## 6. Thermostat and bathroom

On the **House** screen the thermostat and bathroom cards show the temperature in °C and, below, the humidity.

- Put a finger on the Thermo of the sideboard: the temperature rises slowly, because the sensor board has thermal inertia. Breathing on it is faster: humidity jumps, the thermostat goes to **hot**, the house says "It's hot! Turning on the air conditioning." and a cool blue wave runs in every room for up to two minutes, or until the reading settles back.
- Breathe on the bathroom Thermo: when humidity rises 8 points above its recent average the shower rule starts ("Turning on the bathroom fan.", cool light in the bathroom, notification *Shower running*).

The thresholds are relative to the average of the last 5 minutes, so give the sensors a few minutes after power-up.

## 7. Barbecue fan

In **Controls**, tap **Barbecue**. The house says "Lighting the barbecue!", the fan runs for 20 seconds, then "The barbecue is ready, everyone to the garden!". **Stop the barbecue** stops it at once.

Then test a power cut: start the barbecue and unplug the power while the fan runs. When power comes back, the fan must stay off.

## 8. Sound and microphone

In **Diagnostics**:

- **Audio test** plays a chime and says "Audio test: can you hear me?". The speaker knob must be at maximum; set the level with **Controls → Volume**.
- **Microphone test (3 s)** records three seconds: speak towards the totem cap. The result shows the level, the peak and the text recognized. A level close to zero means no sound reaches the microphone input.

## 9. Camera calibration

The calibration tells the house where the base is in the image. Until it is done the house sees nothing, and the blur of the bathroom in the live view is only approximate (see [chapter 7](07-recognition-and-identities.md#privacy)): calibrate before you use the live view.

Open **More → Calibration**.

1. **Take characters and car out of the house (furniture stays).** Leave the furniture exactly where it will stay.
2. **Tap the 4 corners of the base, in the order shown**: front left, front right, back right, back left. Front is the driveway edge; left is the kitchen and garden side. A chip shows which corner is next; ↶ removes the last one. Tap **Use these corners**. If the four points are not a plausible outline of the base, the house refuses them: tap them again, in order.
3. **Check the overlay.** With *Overlay* on, the image shows the outline of the base, the rooms, the doors in green, the walls drawn at their real height and the excluded zones darkened (wall lights, the tree canopy, the pole). The drawn walls must sit on the walls in the image. If they do not, tap the corners again.
4. **The light and the empty house.** Right after the corners the house sets the light of the camera by itself and saves the empty house; a box with a spinner shows it is working, and the buttons stay locked until the message *Empty house saved*. Do not touch the house during those 15 seconds. For a few seconds the camera adjusts exposure and white balance on its own, and the house measures the brightness and colours it reaches. It then looks for the manual values that give the same picture, a quarter darker (so the floor under the coloured house lights does not saturate), and locks them. Under some lights, like some warm, greenish lamps, no colour temperature of the camera gives neutral colours: the house corrects what is left with a fixed gain on each colour. Finally it saves the empty house, the median of 20 frames. It takes about 15 seconds, and the house must be empty.
5. **The empty house in the other lights.** Still with the house empty, tap **Photograph in every light of the house**: for about a minute the house photographs itself in each of its lights, and you must not touch it. Then switch on one at a time the lights of the hall the house does not command (lamps, LEDs, the light of the window) and for each one tap **Add the light of now**. Below the buttons the page says how many empty houses per light it saved and which one is in use. When the light changes, the house compares with the most similar picture (see [chapter 7](07-recognition-and-identities.md#the-light-of-the-hall)).

Later:

- **Save the empty house only** takes a new reference without touching the camera settings, for example after moving a piece of furniture; in that case also tap **Clear (after moving the furniture)** and do step 5 again.
- **Set the light and save the empty house** is for when the light of the hall changes a lot. Slow changes are followed automatically on the free floor.
- If the camera gets bumped, the web app shows *The webcam has moved: calibrate again*: repeat the whole procedure.

**Diagnostics → Webcam** now shows the frame rate (7 to 10 per second) and the processing time, without *not calibrated* or *light not set*.

## 10. The first figurine

1. **Characters → + Add.** Type a name, optionally take a photo, tap **Next**.
2. Put the figurine on a free spot of the house. The house finds it and asks what it is, proposing a kind; tap the right one and **Save**.
3. On the **House** screen the figurine appears with its name. Move it into another room: on the plan it moves into that room. The follow-me lights are off by default ([chapter 9](09-rules.md#priorities-and-light-layers)), so the light of the room stays as it is.
4. Pick it up with your hand and put it down in another room: it keeps its name.

[Chapter 7](07-recognition-and-identities.md) explains the registration and its warnings in detail.

## 11. Voice

Hold **Talk** and ask, in Italian, "Dov'è Marco?" (with the name you registered); release and wait for the answer. Switch to English with the Language button and ask "Where is Marco?".

Then ask something the fixed phrases do not cover, such as "Quanta gente c'è in cucina?". The house says "Vediamo…" / "Let me see…" and passes the sentence to the language model. **Diagnostics → Voice** shows *LLM* with a green dot when the language model server is available.

## 12. Intercom and rules

- Press **Intercom**, say the name of the registered character, and within 60 seconds move that figurine from the driveway through the front door into the living room: it takes that name.
- Put two person figurines in the bathroom: after 2 seconds the bathroom blinks orange and the house says "The bathroom is taken! Please wait your turn."
- With the alarm on, as it is by default, leave a person figurine in the utility room for more than 5 seconds: red alarm lights in living room and garage, "Warning: the utility room is off limits!", and a red banner on the phones until it leaves. **Switch off** on the banner turns the alarm off; switch it on again from the **Alarm** box of the **House** screen.
- Drive the car through the garage gate: "Welcome home!". Leave it still in the parking area for 3 seconds: it counts as parked, and the **Car** card of the **House** screen says so. The garage light stays as it is: it is turned on by the follow-me lights, off by default ([chapter 9](09-rules.md#priorities-and-light-layers)).
- **Controls → Party!**: "Let's dance!", 20 seconds of music and lights, "The party is over!".

## 13. Hotspot and phones

1. Switch the board to its hotspot (`bash scripts/hotspot.sh on`, or reboot if you installed with the default `--hotspot boot`).
2. With an Android phone and an iPhone: join `DomotiQ-Casa1` with the Wi-Fi password (it is in the summary of the installation and in **More → Settings → Wi-Fi of the house**), then open `http://10.42.1.1/` (if you installed with `--house N`, the network is `DomotiQ-CasaN` and the address `http://10.42.N.1/`). If the phone asks, choose *Stay connected* or *Use without Internet*. On Android, if the page does not open, turn mobile data off for a moment.
3. **Diagnostics → Wi-Fi** shows how many devices are connected to the hotspot. Open **Live** on several phones at the same time to check that the stream keeps up.

## 14. Clock

The UNO Q has no battery for its clock and, without internet, cannot set the time by itself. After a restart, the first phone that opens the web app sets the time of the house (a message says *House time set from this phone*). **Diagnostics → Clock** shows where the time came from. See [chapter 8](08-voice.md#setting-the-clock-by-voice) for setting it by voice.

## Testing without figurines

The whole house also runs on a PC, in simulation and without any hardware: start it with `--simulate` (see [chapter 6](06-web-app.md#trying-the-web-app-on-a-pc)). Instead of the webcam there are virtual figurines: tapping **Unrecognized item** and then a spot on the plan puts one there. The simulation page, which is not in the menu, opens with `#/sim` after the address (`http://localhost:8080/#/sim`): there you drag the figurines, add new ones or a registered character, move the virtual sensors and press the virtual buttons. Lights, voice and rules react as they do to real figurines. While the simulation is on the house ignores the webcam; to go back to the real house, just restart it normally, without `--simulate`.

Next: [the web app](06-web-app.md).
