destone28/DomotiQ/(commit log)

2026-09-28 Start the project: MIT license, specification, v3 print files and house layout
    The software moves from GPL-3.0 to MIT; documentation, STL files, images
    and data are released under CC BY 4.0. The specification, the development
    diary, the decision log and the list of tools and licenses are in docs/.
    data/house.json describes rooms, walls, doors, furniture, lights and
    sensors with the coordinates of the v3 CAD model.
    [01_Pedana_A1.stl, 02_Pedana_A2.stl, 03_Pedana_A3.stl, 04_Pedana_B1.stl, 05_Pedana_B2.stl, 06_Pedana_B3.stl, 07_Chiave_01.stl, 07_Chiave_02.stl]
2026-09-28 Add the house core and the web app, runnable in simulation
    The core keeps the state of the house and turns tracks into events:
    rooms entered and left, crowded rooms, parked cars. Lights are layered
    (follow-me, scene, rules, party, constraints) and only changes reach the
    microcontroller. The rule engine runs When/If/Then rules with timers for
    the utility room grace period and the bathroom limit, and ships with the
    default rules. The MCU client speaks MessagePack-RPC to arduino-router
    and registers for button and sensor notifications.
    The web app is served by the board with no external resources: plan of
    the house, live view, controls, events and change log, rule editor,
    character registratio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
2026-09-28 Add the microcontroller firmware
    The sketch owns the Qwiic bus of the UNO Q: Hub, Latch Relay, five
    Pixels, two Thermo, Buttons and Distance, all driven with hand-written,
    time-bounded I2C transactions. An io thread starts at power-up, switches
    the latching relay off and breathes the lights until Linux arrives; then
    it draws the light effects and the party show at 25 frames per second,
    within a power budget for the 3.3 V Qwiic line, reads the buttons 100
    times per second and the sensors in the background. Linux calls light,
    party, relay, leds, limits, modules and scan; the sketch notifies button,
    distance, climate and module changes. The fan switches off if Linux is
    silent for 30 seconds.
    B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
2026-09-29 Add the vision process
    The webcam, the pipeline and the tracker run in a child process. Four
    taps on the base give the homography, and the camera position from the
    model handles parallax. Frames are compared in Lab with the empty house
    after a per-room, per-channel light correction; shadows, wall tops and
    wall lights are ignored. Tracks follow figurines across rooms and hands,
    identities are matched by colour signature, and same-colour twins are
    followed and, when in doubt, asked about. The bathroom is blurred in
    every image that leaves the board. A YOLOX-Nano detector proposes the
    category from the registration photo, and a synthetic renderer tests it
    all without a camera.
2026-09-29 Screenshots of the web app for the guides; name the rule whose lights an action turns off
    The camera-moved check becomes a banner and shows in the diagnostics.
2026-09-29 Add the English and Italian READMEs and the wiring diagram
2026-09-29 Finish voice and intercom registrations by themselves, and fix what the English guide review found
    The intercom registers the first stranger through the door; Talk takes the
    only newcomer in the named room, or asks the web app to choose with a
    banner. Names unknown to the speech recognizer are pointed out. Spoken
    times cover "half past three", "ten to seven" and every Italian minute.
    Alarms of one-off events end after 30 s. Before the calibration the live
    view blurs a wide area where the bathroom should be. The follow-me switch
    shows its real state, logs download as a file, rooms without lights say so.
    The language model answers with a short command under a grammar.
    Add the English guide.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
2026-09-29 Make the free-phrase path reliable on the board
    The language model now sees its examples as a conversation, in a fixed
    mixed order, and answers with a short command under a grammar; its
    instructions stay in the llama-server cache, so a question costs about two
    seconds on the board. Actions it proposes are asked first by voice unless
    it is sure, a registered name with no room means "where is", and the
    rule-based parser covers many more phrasings. Yes, no and cancel are only
    whole short answers.
2026-09-29 Vision at about ten frames a second on the board
    The light is measured three times a second or when the house changes a
    light, the per-pixel gains are kept in between, and the comparison with
    the empty house runs on 8-bit Lab with native OpenCV operations: from 186
    to 82 ms a frame on the UNO Q. The webcam's MJPEG is decoded directly at
    half size.
2026-09-29 Diary: the vision process on the board with the synthetic camera
2026-09-29 Change the Wi-Fi password of the hotspot from the web app or the command line
    Settings gets a Wi-Fi section: the new password goes into the hotspot
    connection through the one nmcli command the sudo rules allow, and the
    hotspot restarts if it is on. The generic settings endpoint can no longer
    touch the network. python -m domotiq.admin changes the PIN or the Wi-Fi
    password on the board and restarts the house.
2026-09-29 Harden the staff PIN and the hotspot password change
    Wrong PINs are also counted for everybody: after ten in ten minutes, from
    any address, logins stop for a growing time, so the PIN cannot be guessed
    by changing address on the hotspot. Changing the PIN or the Wi-Fi
    password asks for the current PIN, and a new PIN ends the other staff
    sessions. The sudo rules no longer allow nmcli with a wildcard: the web
    app sets the password through domotiq-hotspot-psk, a root-owned script
    that reads it on its standard input and changes nothing else. A failing
    nmcli is an error instead of a silent save, the web app says when only
    the sign was updated, and the settings of the running house are reloaded
    when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
2026-09-29 The intercom totem is 103 mm above the floor, not 105 (the 6 mm in the floor socket do not count)
2026-09-29 Look for the Latch Relay at 0x15 too, as its datasheet of September 2026 says
    The Modulino library uses 0x02 and the datasheet 0x15 (0x04 and 0x2A in
    8-bit form): the firmware now tries 0x02, 0x15 and 0x10. Docs, diagram and
    the bench script follow.
2026-09-29 Riconosci il bus dei Modulino bloccato e prova a liberarlo
    Il firmware legge SCL e SDA prima di ogni transazione: con una linea a
    massa non aspetta più il mezzo secondo del driver a ogni tentativo, e ogni
    5 secondi prova a liberare il bus con nove impulsi su SCL e uno STOP. La
    casa mostra un avviso, e Diagnostica e il collaudo al banco dicono quale
    linea è bassa. Le guide spiegano come riconoscere un cavo con i fili
    invertiti.
2026-09-29 Audio a volume pieno, watchdog del firmware corretto e prime prove al banco
    La casa mette l'uscita della scheda audio a 0 dB e spegne il ritorno del
    microfono a ogni apertura, e non sceglie più la webcam come scheda audio.
    Il controllo "Linux tace da 30 secondi" del firmware non scatta più per
    sbaglio quando una chiamata arriva durante le sonde o l'impulso del relè,
    e il relè spento viene ripetuto finché il modulo non risponde.
    L'istantanea della webcam è sempre un'immagine nuova; l'analizzatore
    vocale distingue i gradi dal numero di persone e capisce "la cucina è
    vuota?"; Diagnostica non dà falsi allarmi sul bus.
2026-09-29 La casa si rimette in piedi da sola dopo blocchi, cali di corrente e salti dell'ora
    Il firmware rimanda ogni 5 secondi luci e LED dei tasti, così un modulo
    che ha perso corrente per un attimo non resta spento. La casa rimanda
    tutto allo sketch quando non gli ha parlato per più di 20 secondi, misura
    gli intervalli con un orologio che non salta, e systemd la riavvia se il
    ciclo principale resta fermo per due minuti. Un telefono imposta l'ora
    solo finché la casa non la conosce. La scansione I2C di Diagnostica
    mostra il bus principale a parte.
2026-09-30 La casa saluta i telefoni nuovi e, in modalità chiacchierona, fa domande ai personaggi
    Chi apre la webapp per la prima volta viene salutato a voce: la casa
    chiede il nome, che si può dire senza premere Parla o scrivere nella
    scheda del telefono, e invita a entrare con un personaggio. In modalità
    chiacchierona la casa chiede qualcosa ai personaggi che sono in casa,
    adatto alla stanza, e ascolta la risposta da sola.
    Parla e il citofono interrompono il saluto e le domande; i nomi scritti
    non vengono letti ad alta voce; al massimo un saluto a voce ogni 45
    secondi; una risposta sentita mentre la casa parla si scarta. Le frasi
    sostituiscono solo i segnaposto esatti: un nome scritto da un visit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
2026-09-30 La casa racconta storie, ricorda la giornata e conosce i suoi personaggi
    Le storie, i ricordi e le risposte alle domande libere le scrive un
    secondo modello linguistico, in un servizio suo (domotiq-story). Ogni
    personaggio riceve una personalità che resta la stessa fino al riavvio e
    che rispetta quello che la casa sa di lui: si può scrivere nella webapp
    (Chi è) o dire a voce (ricorda che Marco fa il medico). Quello che la
    casa inventa resta in memoria, così le risposte successive sono coerenti.
    Le storie per i personaggi in casa si scrivono in anticipo, mentre
    nessuno chiede niente, e partono subito; ogni frase si legge con la voce
    della sua lingua. "Cosa ha fatto Marco oggi?" risponde c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
2026-09-30 Con un modello lento la casa promette la storia e la racconta appena è pronta
    Il narratore misura quanto velocemente scrive il modello. Se scrive più
    piano di quanto la casa parla, invece di far aspettare in silenzio dice
    che la sta scrivendo e la racconta appena è pronta; lo stesso per le
    domande libere. In modalità chiacchierona usa solo le frasi già scritte
    in anticipo. Le personalità hanno un formato con le etichette, anche
    quando vengono tradotte, e "Mr." non chiude più una frase.
2026-09-30 Storie, ricordi e risposte sulla vita di casa generati da un database locale
    Le storie non le scrive più un secondo modello linguistico: sulla scheda
    era troppo lento (il 2B) o scriveva un italiano povero (lo 0.8B). Ora la
    casa combina i pezzi di data/stories.json, scritti in italiano e in
    inglese e compatibili con qualunque nome: momenti, attività per stanza,
    eventi, reazioni, relazioni, scoperte, finali, personalità e dettagli
    della vita di casa. Ogni personaggio riceve lavoro, carattere, passione e
    mania che restano fino al riavvio; quello che dice lo staff viene prima.
    Le storie su un personaggio non si ripetono finché ci sono pezzi nuovi, e
    bollette, assicurazione, compleanni, feste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
2026-09-30 Tolta la placca del secondo modulo Buttons, che il totem non usa più
    Nel diario la conferma delle luci al banco e il controllo dei cavi Qwiic sui percorsi del CAD.
    [33_Placca_Totem_Tasti2.stl]
2026-10-03 La regolazione della luce misura le immagini invece di fidarsi dei valori della webcam
    La C270 in automatico non dice esposizione e bilanciamento che usa: bloccare quei valori dava un'immagine quasi nera. Ora la casa misura luminosità e colori in automatico, trova i valori manuali che li riproducono e corregge in software i colori che la temperatura della webcam non riesce a correggere.
2026-10-04 Visione: niente si muove da solo, le mani non sono presenze, fuori dalla casa è sfocato
    Una statuina entra, esce o si sposta solo per mano di qualcuno. Mentre
    una mano è sulla casa, e per mezzo secondo dopo, la casa non conta
    niente e ogni pezzo del braccio è mano; le cose nuove nascono solo dove
    la mano ha lavorato. Una differenza senza mano (un riflesso, la luce
    della sala) non diventa mai una presenza e dopo qualche secondo entra
    nella casa vuota; un cambio di luce in tutta la casa fa rimisurare ogni
    stanza. Un personaggio seguito che per un attimo non si vede resta al
    suo posto. Il nome arriva in due immagini; se resta sconosciuto la casa
    chiede chi è, anche tra i personaggi di cui n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
2026-10-04 Visione: l'area analizzata non sparisce più, statuine scure trovate, braccio e avvio più affidabili
    Con la calibrazione di stamattina la zona del palo, proiettata fino a
    quasi l'altezza della webcam, copriva tutta l'immagine e la casa non
    vedeva niente: il palo è già nella scena, e un controllo ferma una
    maschera che copre la casa. Le soglie sono state misurate sulla casa con
    la luce del laboratorio: una statuina marrone scuro sul pavimento grigio
    ora si vede. Sotto un braccio un personaggio preso in mano non viene più
    riagganciato a un pezzo del braccio; una presenza nuova si annuncia dopo
    un secondo di stabilità; all'avvio si accetta solo ciò che spicca
    davvero; il riflesso di una l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
2026-10-04 Domande a voce senza tasto, chi è per ogni nuovo arrivato, un commento per ogni evento
    Ogni domanda della casa si ascolta da sola dopo averla detta, senza il
    tasto Parla, e intanto compare sui telefoni: vale la prima risposta, a
    voce o dall'app. Per ogni elemento nuovo la casa chiede subito chi è,
    proponendo i personaggi registrati del tipo giusto, e accetta anche un
    nome nuovo (detto e confermato, o scritto sul telefono): il personaggio
    viene creato con i colori che la casa vede. Un narratore dice in poche
    parole chi entra, esce o cambia stanza e l'auto parcheggiata, quando il
    movimento si è fermato. Visione: una "mano" ferma per otto secondi è un
    oggetto sul bordo e non blocca più la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
2026-10-04 Il riflesso di una luce appena accesa dalla casa non diventa una presenza
    Per 15 secondi dopo un cambio di luce in una stanza nessuna cosa vi viene adottata in ritardo: il riflesso entra nella casa vuota. Nel diario, corretta una diagnosi sbagliata sulle firme di colore dei personaggi.
2026-10-04 All'avvio solo i personaggi conosciuti; il braccio sopra il totem resta una mano; domande ritirate
    All'avvio la casa riconosce i personaggi registrati dal loro colore e
    l'auto, e lascia entrare nella casa vuota tutto il resto: luci accese e
    moduli spostati nel frattempo facevano nove domande insieme. La zona del
    totem tagliava dal bordo il braccio di chi si allunga verso il
    soggiorno: fuori dal garage una cosa grande come un braccio vicina al
    bordo è una mano. Una domanda "chi è?" su qualcosa che è sparito viene
    ritirata dai telefoni e la casa smette di ascoltare.
2026-10-04 Audio: la scheda audio che si riavvia da sola non lascia più la casa muta
    La US205 a volte si resetta: aplay restava bloccato e il volume tornava a -23 dB.
    Ora la casa riconosce la scheda dal bus USB, scrive senza bloccarsi, riapre l'uscita
    (e rimette i livelli a 0 dB) se la scheda cambia o si blocca per più di un secondo,
    e intanto continua a mescolare i suoni.
2026-10-04 Chi è: risposte libere capite; falsi positivi che saltano; luce della sala seguita
    - Domanda per ogni nuovo arrivato con quello che la casa pensa che sia ("vedo una
    persona nuova, giusto?"): a una persona si chiede il nome, a un animale si
    propongono solo gli animali registrati. Ogni risposta è capita: nome, correzione
    del tipo, sì/no, "non c'è nessuno" (la visione dimentica la macchia), non lo so,
    un comando o una domanda (eseguiti, poi la casa richiede). Regole per le risposte
    brevi, il modello linguistico locale per le altre, in un secondo slot di
    llama-server; nomi registrati riconosciuti anche con una lettera sbagliata.
    Dal telefono: tipo del nuovo arrivato e "Non c'è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
2026-10-04 Webapp: allarmi e notifiche si chiudono
    Ogni allarme ha la sua ✕: chiuso su un telefono sparisce da tutti e ricompare solo
    quando la sua causa è finita e si ripresenta. Le notifiche si chiudono con un tocco.
2026-10-04 Presenze sicure prima di chiedere; personaggi noti riconosciuti; ascolto subito
    Visione:
    - nasce solo ciò che è comparso mentre la mano lavorava, compatto (al massimo 3,5
    volte più lungo che largo) e ben staccato dal pavimento: le strisce di luce ai piedi
    dei muri e le chiazze tenui non sono presenze;
    - doppio controllo: un nuovo arrivato è mostrato, e se ne chiede il nome, solo se la
    sicurezza (visto quasi sempre, fermo, contrasto, forma) supera l'80% due volte a un
    secondo di distanza; nelle stanze dove si è appena detto "non c'è nessuno" serve il
    92% per due minuti;
    - ciò che sembra una statuina non entra mai nella casa vuota, e il posto lasciato da
    una statuina ingloba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
2026-10-04 Webapp: Personaggi nella barra in basso al posto di Eventi; pagine leggibili fino in fondo
    Eventi passa in cima ad Altro. Il fondo di ogni pagina non finisce più sotto la barra delle
    scelte rapide: il corpo della pagina cresce con il contenuto, con un margine in fondo.
2026-10-04 La matrice LED della UNO Q è la luce del locale tecnico
    Il firmware la comanda come le altre luci (luce 5 per Linux): effetti, luminosità e
    festa sulla matrice (un solo colore, 8 livelli), il colore sul LED RGB della scheda
    accanto. La stanza ha la sua luce nel layout, quindi anche le luci che seguono le
    persone la accendono. Guide 04, 06, 09, strumenti e licenze, decisione D-23, diario.
2026-10-04 Visione: il controllo dei posti vuoti costa poco; niente doppioni in mano
    Il confronto con la casa vuota salvata corregge la luce solo dove sta la macchia, non
    su tutta l'immagine per ogni macchia. Quando un personaggio viene riconosciuto, la sua
    vecchia traccia rimasta in mano sparisce invece di restare come doppione.
2026-10-04 Mobili, frasi varie, nomi stabili, posizioni ferme, matrice accesa, domande chiudibili
    - personaggi sdraiati (più lunghi ma dai colori decisi) visti e seguiti; una statuina in
    mano si ritrova dove la mano l'ha posata, qualunque forma abbia, e la sola cosa nuova
    lasciata dalle mani è il personaggio che tenevano;
    - su quale mobile sta un personaggio (letto, divano, tavoli, panche...);
    - un nome non salta da una traccia all'altra: chi lo tiene lo perde solo dopo otto
    fotogrammi; il riconoscimento largo vale solo nei primi 10 secondi di una traccia;
    - dimensione oltre al colore: l'auto non è mai una statuina e viceversa, e una taglia
    molto diversa da quella imparata conta;
    -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
2026-10-04 Riconoscimento: ogni personaggio impara sulla scheda le sue pose
    Oltre ai colori registrati, ogni personaggio tiene fino a sei pose (sdraiato, sul letto,
    sotto un'altra luce), ciascuna con colori, dimensione e forma, e il confronto si fa con
    la più simile. Una posa nuova si impara quando la casa è sicura del personaggio (confermato,
    riconosciuto con sicurezza, oppure l'unica cosa nuova lasciata dalle mani che lo
    portavano), è fermo, senza mani intorno, visto intero e diverso da tutte le pose note; e
    subito quando qualcuno dice chi è. Le pose restano nell'elenco dei personaggi sulla scheda.
2026-10-04 Via il sensore Distance da hardware, firmware, casa, regole e webapp
    Il Modulino Distance esce dal progetto (D-25). Il canale 6 dell'Hub porta
    solo il Thermo della credenza e il Buttons del totem.
    - Firmware: niente più ricerca e lettura del VL53L4CD, né la notifica
    "dist".
    - Casa e regole: spariscono la distanza, il visitatore al citofono, il
    trigger "qualcuno è al citofono" e la regola di partenza "Visitatore al
    citofono". Una regola salvata con quel trigger viene saltata all'avvio.
    - Webapp: niente più etichetta e pallino sul totem, cursore della
    simulazione e voci di diagnostica.
    - Collaudo al banco, guide, specifica, schemi di cablaggio e attribuzioni
    aggiornati; tolta la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
    [33_Placca_Totem_Distance.stl]
2026-10-04 Riconoscimento più veloce, nomi che si muovono solo con le mani, allarmi su presenze certe, «tutti e due»
    - Il confronto di una macchia con tutte le pose di tutti i personaggi è un
    solo calcolo, fatto una volta per immagine; la luce delle stanze si
    rimisura al massimo ogni 0,3 s dopo un cambio. La diagnostica mostra il
    tempo di ogni fase.
    - Senza una mano un personaggio con un nome lo tiene, e un nome non passa a
    una macchia lontana dall'ultimo posto in cui quel personaggio stava.
    - Una posa deve avere il colore del suo personaggio, più che di chiunque
    altro: le pose imparate sulla macchia sbagliata vengono dimenticate, e i
    colori e la dimensione registrati non imparano più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
2026-10-04 Allarme che si disinserisce, niente più staff e PIN, webapp più pulita e uniforme
    - L'allarme si inserisce e disinserisce come un antifurto, dalla casa,
    dalla notifica rossa o con /api/commands/alarm: disinserito, le regole
    d'allarme stanno zitte e gli allarmi in corso si spengono; reinserito,
    chi è già nel posto sorvegliato viene notato di nuovo.
    - Staff e PIN non ci sono più: calibrazione, diagnostica, impostazioni,
    backup, cestino e sistema sono aperti a chiunque usi la webapp, sotto
    /api/... senza /staff. Restano il registro delle modifiche e il cestino.
    - Webapp: ogni pagina inizia allo stesso modo (titolo, una riga, l'azione
    principale); il menu Altro è diviso in casa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
2026-10-04 Presenze in JSON semplice; l'avvio aspetta le luci e prende solo personaggi certi
    - Il nuovo segno «sicura» di una presenza usciva come booleano di numpy e
    /api/state rispondeva 500: le presenze escono ora sempre come numeri e
    booleani semplici.
    - All'avvio la casa prende quello che vede solo quando le luci stanno
    ferme (il microcontrollore le rimanda), e solo i personaggi che conosce
    da vicino e che hanno la forma di una statuina: alle 20:37, a casa vuota,
    l'alone delle lampade e il modulo dei tasti erano diventati Mister Brown,
    Mister Green e una persona sul vialetto.
    - Una presenza seguita meno di 2,5 secondi è rumore anche se ha preso un
    nome, e non resta nascosta per un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
2026-10-04 Documentazione: niente staff né PIN, allarme disinseribile, tutti e due, nomi che si muovono solo con le mani
    - Guide IT/EN, README, specifica e guida rapida dello stand senza PIN e
    senza modalità staff: tutto è aperto a chiunque, con registro, cestino e
    conferma prima delle azioni che non si annullano.
    - Capitolo 6: pagine che iniziano tutte allo stesso modo, menu Altro in tre
    gruppi, notifiche con un colore per tipo, riquadro dell'allarme, «Tutti e
    due» nelle domande, API aggiornate.
    - Capitolo 7: i nomi si muovono solo con le mani, pose del colore giusto,
    avvio a luci ferme, presenze sotto i 2,5 secondi come rumore, allarmi solo
    su presenze certe, «tutti e due».
    - Capit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
2026-10-05 Riconoscimento: tolleranza per pixel, colori più veloci, auto chiesta solo se certa
    - Il tremolio di ogni pixel si impara con la casa vuota e si salva in noise.npy: una macchia conta solo se supera di 5 volte il tremolio dei suoi pixel. Il file si scrive a parte e poi si rinomina, uno vuoto non blocca la visione, e dopo una nuova regolazione della webcam il rumore si reimpara anche dopo un riavvio.
    - Istogramma dei colori sei volte più veloce, con gli stessi risultati. La firma a piena risoluzione, provata, non è adottata.
    - Fuori dal garage la casa chiede di un'auto solo se è ferma e ben visibile da 10 s, senza salti: i salti si tengono per tutto quel tempo.
    - Togliere una presenza dall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
2026-10-05 Webapp: contatori in tempo reale, presenze da togliere, ricarica automatica
    - La casa aggiorna i conteggi prima di avvisare i telefoni: piantina e contatore seguono subito ogni spostamento. I numeri della piantina contano le persone, come la scheda.
    - "Non c'è davvero: togli" sulla scheda di una presenza (POST /api/tracks/{id}/dismiss); "Non c'è più" se è già sparita.
    - I telefoni si ricaricano da soli quando la casa viene aggiornata; una parte della pagina si ridisegna solo quando cambia, sulla Casa e su Personaggi, così i tocchi non si perdono.
    - L'allarme in fondo alla pagina della casa, temperature in °C con l'umidità scritta, niente tabellone in Altro, niente scala nelle Informa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
2026-10-05 Voce: proposte che diventano comandi, risposte che restano, modello pronto in pochi secondi
    - Le proposte della casa si capiscono come vengono, senza Parla: un sì le esegue, un altro comando esegue quello. Un sì non vale se la proposta stessa è rifiutata; una frase che la nomina senza chiederla va al modello; con Parla una domanda non viene presa per la risposta.
    - Le risposte che dicono qualcosa di duraturo su un personaggio diventano sue informazioni, nelle due lingue, e la casa le usa per rispondere alle domande su di lui; il modello sceglie solo l'argomento. Niente informazioni da frasi su chi risponde, scelte negate lette nel verso giusto, richieste con un nome che restano richieste.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
2026-10-05 Pezzi della versione 8: 84 file numerati da 01 a 59
    Muri uniti in 7 pezzi da stampare in piedi, chiavi e sedi con giochi corretti, fioriere e pedane aperte per far passare le casse dal basso, pali con la finestra per il cavo della webcam, placca della UNO Q a pressione, staffe per la scheda audio e fermacavi, totem con scocca, tre tasti e coperchio con i cappucci.
    [01_Pedana_A1.stl, 02_Pedana_A2.stl, 07_Chiave_01.stl, 07_Chiave_02.stl, 07_Chiave_03.stl, 07_Chiave_04.stl, 07_Chiave_05.stl, 07_Chiave_06.stl]
2026-10-05 Riconoscimento: un nome mai in due posti, l'auto solo in garage, elementi indicati dalla webapp, luce della sala
    - Prima di un dubbio o di una domanda si tolgono dai candidati i personaggi già riconosciuti altrove, quelli visti l'ultima volta lontano senza una mano passata di lì e l'auto fuori dal garage se non è certa; con un solo candidato la casa decide da sola.
    - Il posto di un nome in dubbio non conta più come ultimo posto del personaggio.
    - Un elemento indicato sulla piantina o nell'immagine: la casa riprende lì la casa vuota salvata e lo segue da subito, senza chiedere chi è.
    - Un personaggio scelto dalla webapp insegna il suo aspetto come posa anche se insolito.
    - La webcam si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
2026-10-05 Voce: parola di attivazione, LED, citofono, Fai domande e risposte che diventano azioni
    - Parola di attivazione scelta dalla webapp, al posto del tasto Parla, con i numeri confrontati in parole; l'ascolto della parola cede il microfono a tutto il resto.
    - LED dei tasti: lampeggiano mentre la casa ascolta, fissi mentre parla, respirano mentre pensa.
    - Dopo il citofono la prima statuina che entra prende il nome detto, qualunque tipo le abbia dato la webcam, senza domande.
    - Fai domande: una domanda subito a un personaggio a caso o scelto, preferendo quello che la casa non sa; domande nuove sul ballo e sulle grigliate.
    - Il colore preferito colora la luce della stanza in cui si entra e serve a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
2026-10-05 Webapp: chi è con tutti i personaggi noti, elemento non riconosciuto, Fai una domanda, parola di attivazione
    - Scheda di una presenza: Chi è? / È un altro: cambia, con tutti i personaggi noti o un nome nuovo; nelle domande della casa, Uno già noto.
    - Elemento non riconosciuto sulla piantina della casa e nella diretta.
    - Domande ai personaggi in Comandi e sulla scheda di ogni personaggio.
    - Impostazioni: luce del colore preferito di chi entra, attivazione con la parola chiave con la verifica delle parole.
2026-10-05 Documentazione: pezzi v8, nomi unici, correzioni dalla webapp, citofono, Fai domande, luce della sala, parola di attivazione
    Capitoli 3, 4, 6, 7 e 8, guide rapide e specifica allineati; decisioni D-34-D-40 e diario del 5 ottobre.
2026-10-05 Riconoscimento: i nomi li decide la visione, la taglia nei dubbi, pausa durante la festa
    - La casa non rimette più a una presenza il nome che la visione le ha tolto;
    un nome dato dalla webapp, a voce o dal citofono resta dove è stato dato
    per 3 secondi, mentre la visione lo riceve, e sparisce da ogni altra
    presenza; se due presenze arrivano con lo stesso nome lo tiene quella in vista.
    - Un dubbio tra nomi tutti riconosciuti altrove diventa un nuovo arrivato.
    - Un nome non va a una macchia più di quattro volte più grande o più piccola
    di tutte le pose del personaggio, e una statuina non è mai l'auto.
    - Su un mobile si sale dopo 5 immagini concordi e si scende dopo 15.
    - Durante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
2026-10-05 Voce: i nomi prima di tutto, risposte sui personaggi immediate, parola di attivazione subito, racconto senza ripetizioni, frasi su disco
    - Con un nome nella frase le richieste sui personaggi vengono prima di quelle
    generali ("Raccontami cosa piace a Rossellina"); i nomi storpiati si
    ritrovano per somiglianza o per una loro parola; "X e Y stanno insieme";
    per 90 secondi una domanda senza nome riguarda l'ultimo personaggio.
    - Alle domande della casa vale la parola dell'elenco solo se il parlato
    libero la conferma, o se è molto sicura e la risposta è corta.
    - Le domande sui personaggi non aspettano mai il modello: parole chiave,
    parole in comune con le informazioni, gusti, storie, a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
2026-10-05 Documentazione: immagini v8, nomi unici anche nella casa, festa, parola di attivazione, risposte immediate, frasi su disco
    - Capitolo 3: i 14 render della versione 8 (senza metadati) al posto di quelli
    vecchi, nei passaggi del montaggio; via la nota sulle immagini precedenti.
    - Capitoli 7 e 8, guide rapide e specifica: un nome mai in due posti anche per
    la casa, la taglia nei dubbi, la pausa durante la festa, la parola di
    attivazione con i LED immediati, i nomi prima delle altre parole, le
    risposte sui personaggi senza modello, il racconto che non si ripete, le
    frasi della voce su disco.
    - Decisioni D-41..D-47 e diario.
2026-10-05 Voce: risposte alle domande sulla vita di casa, regole dalle frasi del banco, memoria del modello, due thread di riconoscimento, frasi fisse preparate
    - A una domanda sulla vita di casa una risposta che non è sì o no viene
    capita: "Quando?" dopo il compleanno dà la data, "Dove?" dopo le vacanze il
    posto; un comando o una domanda per la casa ha la sua risposta.
    - Regole dalle frasi che casa1 mandava al modello: la festa sentita male
    ("fai presto", "let's body"), "cosa posso chiederti", l'elenco dei
    personaggi, "dov'è X" con un nome sconosciuto, il nome detto a voce per una
    presenza, "e in bagno?" dopo una domanda su una stanza, "Di chi?" a una
    domanda senza nome, "dove vuole a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
2026-10-05 Visione e servizi: visione a riposo, priorità tra i servizi
    - Dopo 25 secondi senza mani, con le luci ferme, un fotogramma uguale
    all'ultimo analizzato (miniatura 80 x 60, nessun punto oltre 6 livelli di
    grigio) non viene analizzato di nuovo; uno al secondo lo è sempre. In
    Diagnostica la quota dei fotogrammi lasciati stare e la pausa della festa.
    - CPUWeight: domotiq 200, domotiq-tts 150, domotiq-llm 50; dentro domotiq il
    processo della visione ha nice 5 e cede il passo alla voce.
2026-10-05 Documentazione: vita di casa, regole nuove, priorità, visione a riposo, frasi preparate, scheda grafica
    - Capitoli 2, 7 e 8 e specifica: le risposte alle domande sulla vita di casa,
    le regole dalle frasi del banco, la memoria del modello, i due thread di
    riconoscimento, la visione a riposo, le priorità, le frasi fisse preparate
    con scripts/voice_cache.py.
    - Decisioni D-48..D-54 (con le misure della scheda grafica) e diario.
2026-10-05 Voce: i nomi sentiti da un riconoscimento che conosce solo loro, niente più "Mmm"
    - Con Parla e con la parola di attivazione, sullo stesso audio, un
    riconoscimento ristretto ai nomi dei personaggi gira sul secondo thread:
    quando la frase libera non ha nomi e le regole non la capiscono, il nome
    sentito così si usa ("dovevo music" per "dov'è l'Honda Civic?" diventa la
    domanda su dov'è l'auto).
    - Nessuna frase della casa dice più "Mmm" o "Hmm" (la voce li leggeva
    lettera per lettera); un'interiezione fatta solo di m e h si toglie prima
    della sintesi.
    - scripts/voice_cache.py --prune toglie le frasi che la casa non dice più;
    release.sh le toglie anche dalla scheda.
    - Decision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
2026-10-05 Voce: dopo la parola di attivazione la casa risponde subito
    - Se dopo la parola, entro 0,45 secondi, non segue niente di forte almeno
    quanto il 40% della parola, la casa dice subito una frase brevissima già in
    memoria ("Dimmi!", "Sì, dimmi!", "Eccomi!") e ascolta, senza aspettare il
    riconoscimento libero quando la parola è stata sentita con sicurezza.
    - I LED lampeggiano dalla parola alla risposta senza spegnersi; una
    richiesta detta di seguito alla parola resta una richiesta sola.
    - Decisione D-56, capitolo 8, guide rapide e specifica.
2026-10-05 Modello: istruzioni di llama.cpp per il Cortex-A53, flash attention spenta
    - scripts/llama/arm-nodot.patch: prodotti scalari Q5_0, Q8_0, Q4_K e Q6_K per
    i core ARMv8.0 con NEON e senza SDOT (somme a 16 bit allargate una volta, il
    quinto bit di Q5_0 dalla tabella direttamente nei registri, scale applicate
    alle somme parziali), due righe per due colonne anche con un numero dispari
    di parole. Sugli altri processori llama.cpp resta com'era.
    - install.sh applica la patch al commit provato e ricompila quando cambia.
    - domotiq-llm parte con -fa off; i file delle istruzioni salvate hanno un
    nome nuovo (SLOTS_LAYOUT), perché la memoria del contesto è disposta in un
    altro modo.
    - Strumen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
2026-10-05 Voce: le frasi più probabili, i nomi che il modello non conosce, le frasi come le scrive Vosk
2026-10-06 Voce: climatizzatore a voce, informazioni dette così, narratore senza ripetizioni, la casa non sente la propria voce
2026-10-06 Casa: l'ora vale finché la scheda resta accesa, nessuna auto nuova dentro una stanza
2026-10-06 Visione: i personaggi si spostano solo con una mano vicina, posto fissato sulla mediana di 10 immagini, presenze ferme mentre la webcam si regola
2026-10-06 Voce: quando non sa la casa chiede e impara, su sé stessa immagina; le alternative per le domande deboli
2026-10-06 Voce: le domande sul mondo, aspettare la risposta del modello da 0.8B o insegnarla; chi sei anche sentito male
2026-10-06 Voce: quello che qualcuno insegna vince su quello che la casa ha pensato; "sbagliato" e "te lo dico io" correggono, pagina Cosa ha imparato
2026-10-06 Voce: una parola di attivazione che il riconoscimento non conosce si ascolta con una grafia che conosce (Domotiq come domotica)
2026-10-06 Visione: quando cambia la luce della sala i personaggi restano com'erano, la webcam si regola subito e la casa vuota si reimpara con la luce nuova; avviso di sala troppo buia
2026-10-06 Visione: dopo il buio la casa riguarda cosa c'è; le mani contano come luce solo se cambia anche la luminosità
2026-10-06 Visione: il buio si misura sull'immagine e la casa vuota non si salva al buio; avviso per una casa vuota salvata al buio
2026-10-06 Visione: le registrazioni dicono il riquadro di ogni statuina (per addestrare il riconoscimento)
2026-10-07 Visione: veto della rete anche in ritardo, casa vuota mai salvata con statuine, consenso della rete, registro della visione da confermare nella webapp, banco di prova
2026-10-07 Visione: raccolta continua di quello che vede la webcam per addestrare la rete, entro uno spazio scelto
2026-10-07 Visione: la rete guarda anche le macchie che toccano una statuina, e ciò che vede come niente non viene annunciato
2026-10-07 Visione: un avvio con un'altra luce non impara più le statuine come casa vuota, e la rete guarda prima dell'annuncio
    All'avvio la ricerca dei personaggi prende anche quello che la rete riconosce come un personaggio (almeno all'80%),
    anche quando i colori, in un'altra luce, non sono quelli registrati. Se la casa reimpara la casa vuota senza
    conoscere nessuna presenza, fa come dopo il buio: quello che spicca (o che la rete vede come statuina) non entra
    nella casa vuota, e la casa riguarda cosa c'è. Su casa1 ogni riavvio con un'altra luce aveva imparato tutte le
    statuine come parte della casa vuota.
    Con la rete accesa una presenza nuova si annuncia solo dopo il suo parere, e il nome di un pe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
2026-10-07 Visione: all'avvio la rete ha l'ultima parola
    Una casa vuota salvata con un'altra luce mostra all'avvio macchie dei colori dei personaggi: con la rete, la
    ricerca dell'avvio prende una macchia solo se la rete vi vede un personaggio (su casa1 alle 16:16 Mister Green,
    Mister Brown e Viola erano nati in una casa vuota, con la rete che diceva niente).
2026-10-07 Documenti: la rete addestrata di nuovo con i dati di oggi rivisti (D-72), all'avvio la rete ha l'ultima parola
2026-10-07 Rete delle statuine: le correzioni fatte sulla piantina diventano esempi per l'addestramento
    scripts/figures/web_fixes.py ritrova nel database della casa le presenze eliminate e i nomi dati sulla piantina,
    e per quanto tempo quella traccia è rimasta in quel punto; build_crops.py --fixes li applica ai ritagli (una
    presenza eliminata era niente, una presenza con un nome era quel personaggio anche mentre la casa la chiamava in
    un altro modo). Gli eventi della webapp registrano ora la traccia, e ogni ritaglio la traccia e il riquadro da
    cui viene (D-73).
2026-10-07 Visione: una soglia per ogni rete, e la rete distingue i personaggi dai colori simili
    La soglia oltre cui la rete scarta una macchia come niente si misura a ogni addestramento, appena sopra la statuina
    vera più "niente" dei blocchi lasciati fuori, e viaggia con la rete in figures.json (not_p); senza, 90%. Quando i
    colori propongono un personaggio e la rete è sicura due volte di fila di un altro personaggio libero, vince la
    rete; un dubbio tra due personaggi uguali di colore aspetta 2 secondi il suo parere prima della domanda (su casa1
    Rossellina era stata chiamata Rossana dai colori, la rete sicura al 96%). D-74.
2026-10-07 Visione: la casa vuota fotografata con più luci
    Calibrazione → Fotografa con tutte le luci della casa: con la casa vuota la casa mostra le sue luci una dopo
    l'altra (tutte spente, tutte accese, una stanza alla volta, gli scenari) e in ognuna salva una foto della casa
    vuota; Aggiungi la luce di adesso aggiunge le luci della sala che la casa non comanda. Quando la luce cambia, e
    all'avvio, la casa confronta con la foto più simile dopo aver misurato la luce di ogni stanza, e non impara niente
    da quello che vede se il 90% dei punti torna; altrimenti impara come prima (D-75).
2026-10-07 Rete delle statuine: addestramento sulla GPU, e le coppie che confonde anche quando è sicura
    train.py --device cuda (o auto) addestra su una scheda NVIDIA: le variazioni delle immagini si preparano in quattro
    thread mentre la scheda calcola (su una GTX 960M circa 2,7 volte più veloce). A ogni addestramento la rete misura
    sui blocchi lasciati fuori le coppie di personaggi che confonde anche quando è sicura al 95% (su casa1 Viola presa
    per Mister Blu 34 volte) e le scrive in figures.json: tra quelle due non sceglie, non dà nomi né scioglie dubbi, e
    decidono i colori o la domanda. Le correzioni con più finestre di tempo per traccia (la statuina, poi il fantasma
    quando è stata tolta).
2026-10-09 Visione: la luce della webcam seguita a piccoli passi del guadagno
    Mentre la casa guarda, ogni mezzo secondo il vialetto e la fascia intorno alla casa (dove le luci della casa non
    arrivano) si confrontano con la casa vuota in uso; fuori dalla banda del 5% il guadagno della webcam fa un passo,
    l'80% della strada e al massimo l'8% di luce, con la risposta stimata dagli ultimi due punti. L'esposizione resta
    alla posa più lunga vera e scende di uno scalino solo con il guadagno al minimo. Il motore riscala la luce delle
    stanze e il rumore a ogni passo e lo toglie dalla luminosità con cui si accorge di un cambio di luce: la
    regolazione completa della webcam parte solo quando il guadagno è al li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
2026-10-09 Visione: la luce della webcam misurata sulle stanze, la casa vuota imparata dopo i passi, la vista dal vivo di nuovo a ogni immagine
    La verifica sul campo di D-76 su casa1 (D-77). Il regolatore confronta la luce delle stanze con la casa vuota in uso
    così come è stata fotografata: in ogni regione la mediana sul pavimento libero, lontano da presenze e mani, poi la
    mediana fra le regioni; le stanze di cui la casa ha appena cambiato la luce restano fuori. Il vialetto e la fascia
    intorno alla casa non rispondono alle luci della sala come le stanze (0,29-0,38 contro 0,84-1,49 fra le foto della
    casa vuota del 7/10). Mentre la casa segue un cambio della sala i passi arrivano al 25% e la casa vuota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
2026-10-09 Documentazione: una guida che può seguire chiunque, la password al primo sudo, add-pc.sh con le schede nuove
    La guida descrive una casa sola (casa1, utente arduino, password domotiq2026) e la guida rapida è per chi usa la
    casa ogni giorno. Il numero della casa (--house N, da 1 a 254) è facoltativo, di serie 1. Il cartello da stampare è
    tolto dalla webapp insieme alla libreria dei QR: rete, password del Wi-Fi e indirizzo sono scritti nella guida.
    Sull'immagine di fabbrica la password dell'utente arduino si imposta al primo sudo. Il passo dell'accesso con chiave
    ha un comando per caso; add-pc.sh riconosce una scheda nuova con un nome già usato (chiede se dimenticare l'identità
    vecchia) e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
2026-10-10 Installazione: la guida rifatta da capo su una scheda nuova, password del Wi-Fi a scelta, consegna senza credenziali
    Seguendo la guida passo per passo su una scheda nuova sono comparsi alcuni intoppi, ora corretti (D-79). La guida
    installa la libreria ALSA da backports prima dell'aggiornamento del sistema. Attiva SSH all'avvio (solo fatto
    ripartire, dopo il riavvio rifiutava la connessione), e anche l'installer lo attiva. La password della rete del
    laboratorio si scrive solo quando nmcli la chiede, così non resta nella cronologia. install.sh accetta --wifi PASSWORD
    (la guida usa domotica2026). release.sh casaN --install passa le opzioni all'installer e funziona anche per una prima
    installaz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
2026-10-10 Audio: l'uscita si riapre quando si apre la webcam, e i livelli della scheda rimessi se cambiano
    Su una scheda appena montata la casa restava muta per alcuni minuti dopo ogni accensione (D-80): la sua C270 si
    riavvia sul bus USB quando viene aperta, e la scheda audio sullo stesso hub continuava a prendere il suono senza
    suonarlo, finché la guardia non riapriva l'uscita. Ora l'uscita audio si riapre una volta quando la webcam risulta
    aperta, all'avvio e dopo ogni riconnessione. In più l'uscita rilegge ogni 10 secondi i livelli della scheda (in un
    thread a parte) e li rimette se qualcuno li ha cambiati; la diagnostica conta le correzioni.
2026-10-10 Visione: una presenza nuova aspetta finché la rete dice «niente», rete addestrata anche con la casa vuota e la luce del giorno; webapp: interruttori delle regole, personaggi eliminati tolti dappertut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
2026-10-10 Vista e voce: la webcam segue la luce anche in una sala buia, con le esposizioni digitali e il rumore imparato al limite; due voci a scelta (naturale o veloce), risposte frase per frase e «Dimmi!» su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
2026-10-12 Visione: le statuine dentro il bagliore delle lampade restano viste, la rete con gli undici personaggi ha la precedenza sui colori, l'auto e il nero profondo non sono più mani né ombre, il bianco si 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
2026-10-12 Visione: rete riaddestrata con le posizioni nuove, l'auto sul vialetto e il bagno; un'auto indicata nella webapp torna intera
2026-10-12 Webapp più semplice: niente scenari né luci che seguono in Comandi, simulazione fuori dal menu e «Addestramento immagini», tolte le scelte da tecnico e la voce veloce, la rete sempre attiva; il clima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
2026-10-12 Voce: dopo «non ho capito» la casa propone ogni volta un'altra richiesta da provare, tra quelle che sente meglio; «barbecue», «garage» e «cucina» capiti anche come il riconoscimento li sente sulle ca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
2026-10-12 Webapp: in «Addestramento immagini» le immagini da valutare una alla volta, con Giusto, la correzione o Salta; le domande della casa una alla volta, la più recente per prima
2026-10-12 Visione: l'auto con l'alone di luce, i doppioni senza nome, il nome che può avere uno solo e i nomi che la rete corregge davvero; con le luci della casa che si muovono (allarmi, clima, scenari) la vi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
2026-10-12 Documentazione nello stile di Arduino Project Hub: guida per chi costruisce la casa per sé, in seconda persona, senza note di sviluppo, rete del laboratorio né consegna ad altri; tolti diario, decisi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
2026-10-13 Commenti del codice e dei test senza note di sviluppo; documentazione allineata a quello che la casa e la webapp fanno oggi; le soglie del clima cambiate dalla webapp valgono subito
2026-10-13 Test: la giornata di un personaggio sta tutta in oggi, a qualsiasi ora girino i test (falliva nella mezz'ora dopo mezzanotte)
